emrah1982/KuluckaMakinesi/KuluckaSureleriVeDegerler.jpeg

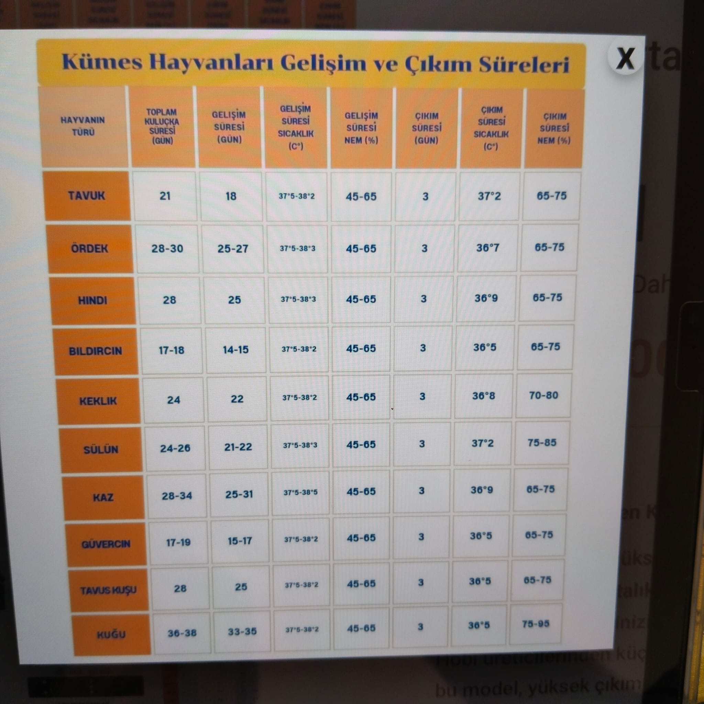
KuluckaSureleriVeDegerler.jpeg
