emrah1982/KuluckaMakinesi/KuluckaMakinesi_kicad/kullanilacakEkipmanlarinListesi.md

PCF8574 IO Genişleme Modülü
CJMCU-9548 TCA9548A I2C 8 Kanal Çoklayıcı Kartı Modülü
SHT40 Sensör Modül 1mt Kablolu
PAM8403 2x3w Amplifier Board
17HS4401 Nema 17 Step Motor
DS3231 Hassas RTC ve 24C32 EEPROM Modülü
DRV8825 Step Motor Sürücü Modül
Mini360 3A DC DC Voltaj Dönüştürücü Modülü (4.75-23V Giriş - 1-17V Çıkış)
