emrah1982/KuluckaMakinesi/docs/Hayvan.pdf

Hayvan | Evre | Gün Aralığı | Sıcaklık (°C) | Nem (%) | Not
Tavuk | Gelişim 1–18 | | 37.5 | 50-55 | Yumurtalar çevrilir
| Çıkım | 19–21 | 37.2 | 65-75 | Çevirme DURUR
Bıldırcın | Gelişim 1–14 | | 37.5 | 45-55 | Hızlı gelişim
| Çıkım | 15–18 | 37.2 | 65-75 | Kritik nem artışı
Kaz | Gelişim 1–25 | | 37.5 | 55-60 | Günlük soğutma + su püskürtme
| Çıkım | 26–30 | 37.2 | 75-80 | Yüksek nem şart
Ördek | Gelişim 1–25 | | 37.5 | 55-60 | Kaz ile benzer
| Çıkım | 26–28 | 37.2 | 70-80 | Nem artırılır
Hindi | Gelişim 1–25 | | 37.5 | 50-55 | Düzenli çevirme
| Çıkım | 26–28 | 37.2 | 65-75 | Nem artır
Güvercin | Gelişim 1–15 | | 37.5 | 50-55 | Hassas süreç
| Çıkım | 16–19 | 37.2 | 65-70 | Nem artar
Papağan | Gelişim | Türüne bağlı | 36.8-37.2 | 50-60 | Stabil ortam
| Çıkım | Son 2-3 gün | 36.5-37 | 65-75 | Tür bazlı değişir
Sülün | Gelişim 1–20 | | 37.5 | 50-55 | Tavuk benzeri
| Çıkım | 21–25 | 37.2 | 65-75 | Nem artır
Deve Kuşu | Gelişim 1–38 | | 36.0 | 25-35 | Çok düşük nem
| Çıkım | 39–42 | 36.0 | 40-50 | Yavaş çıkım
