emrah1982/KuluckaMakinesi/KuluckaMakinesi_kicad/resimler/3.2 inch ESP32 TFT Dokunmatik LCD Ekran.png

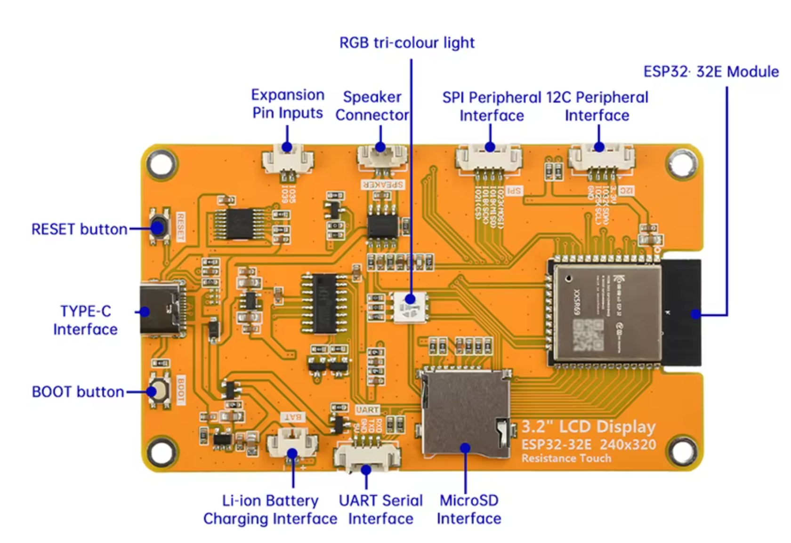
KuluckaMakinesi_kicad/resimler/3.2 inch ESP32 TFT Dokunmatik LCD Ekran.png
