emrah1982/KuluckaMakinesi/KuluckaMakinesi_kicad/resimler/DRV8825/Ekran görüntüsü 2026-05-17 150617.png

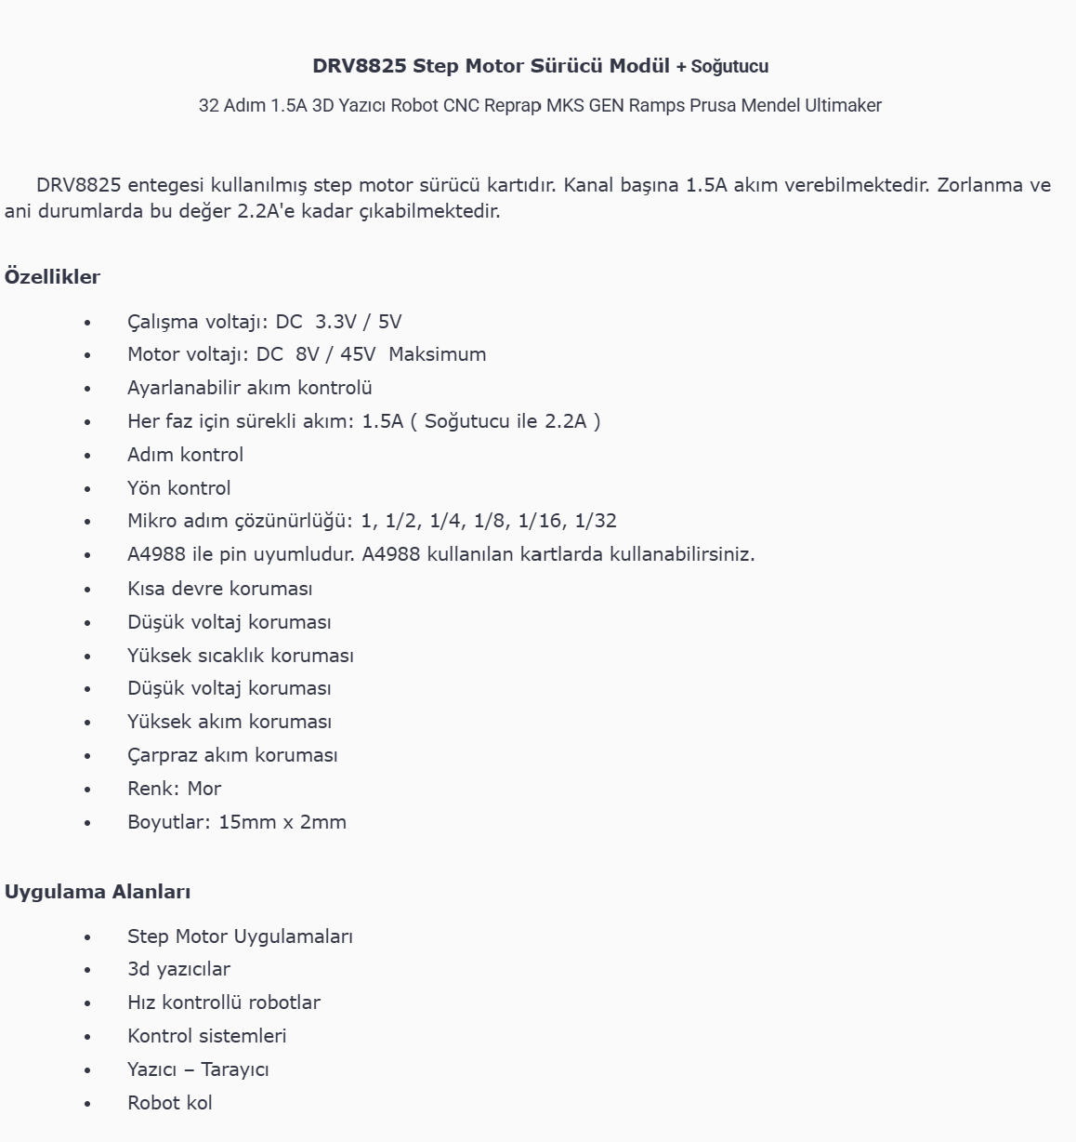
KuluckaMakinesi_kicad/resimler/DRV8825/Ekran görüntüsü 2026-05-17 150617.png
