emrah1982/KuluckaMakinesi/KuluckaMakinesi_kicad/resimler/DS3231/Ekran görüntüsü 2026-05-17 150417.png

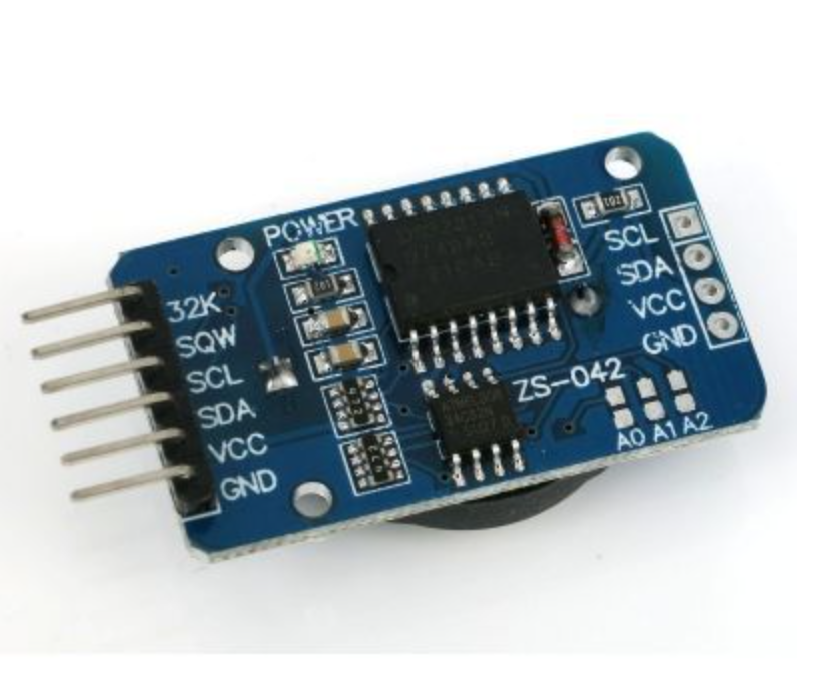
KuluckaMakinesi_kicad/resimler/DS3231/Ekran görüntüsü 2026-05-17 150417.png
