emrah1982/KuluckaMakinesi/KuluckaMakinesi_kicad/resimler/mini360/Ekran görüntüsü 2026-05-18 221324.png

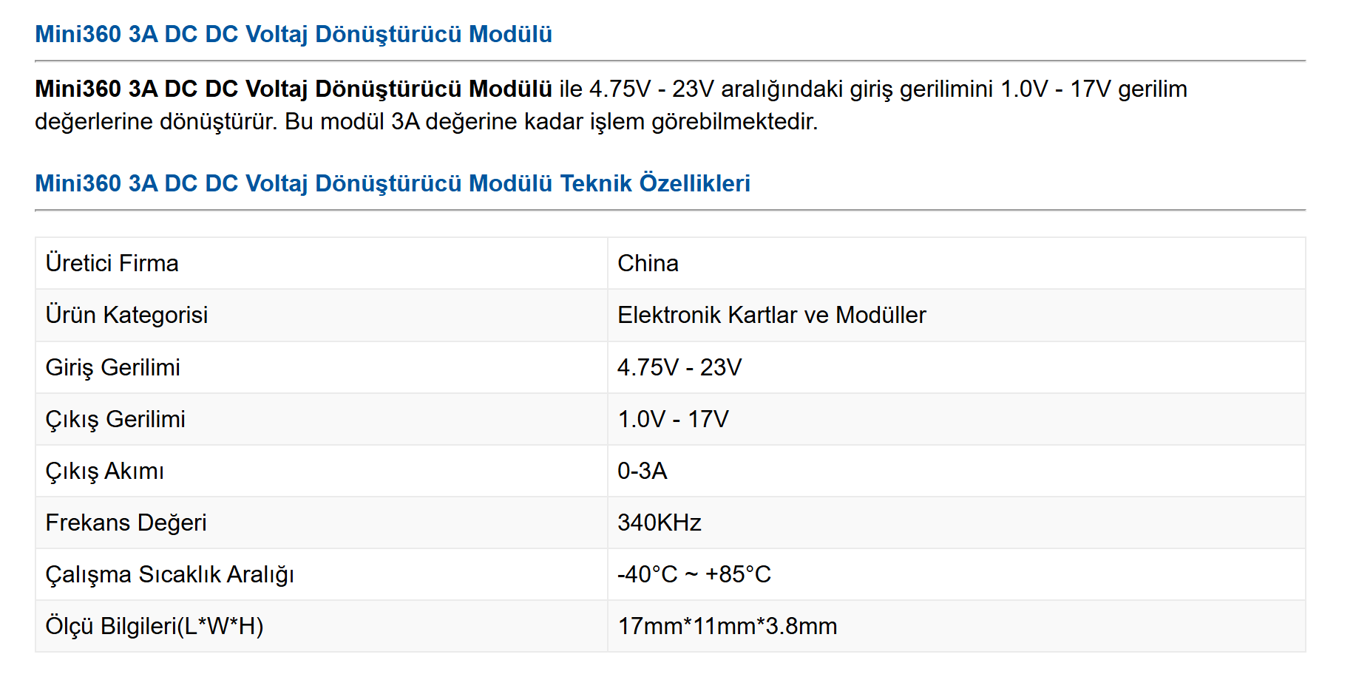
KuluckaMakinesi_kicad/resimler/mini360/Ekran görüntüsü 2026-05-18 221324.png
