emrah1982/KuluckaMakinesi/KuluckaMakinesi_kicad/resimler/PAM8403/Ekran görüntüsü 2026-05-17 150039.png

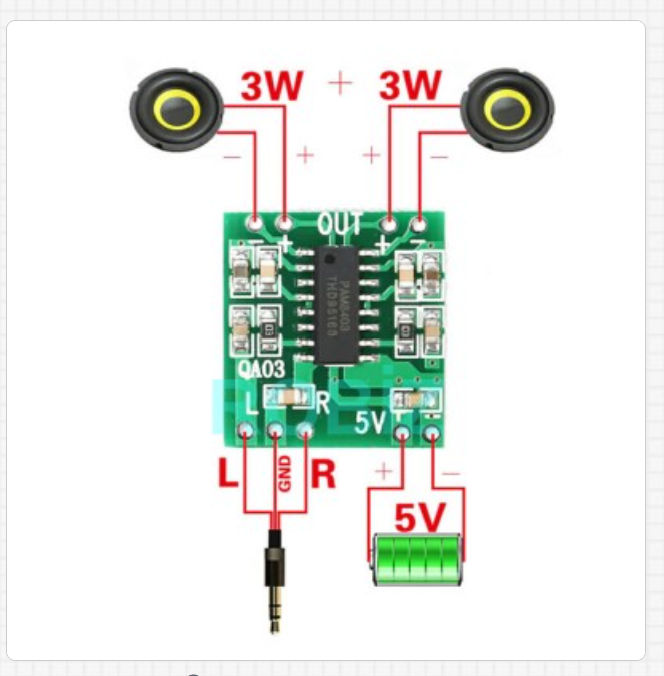
KuluckaMakinesi_kicad/resimler/PAM8403/Ekran görüntüsü 2026-05-17 150039.png
