emrah1982/KuluckaMakinesi/KuluckaMakinesi_kicad/resimler/pcf8574/Ekran görüntüsü 2026-05-17 144710.png

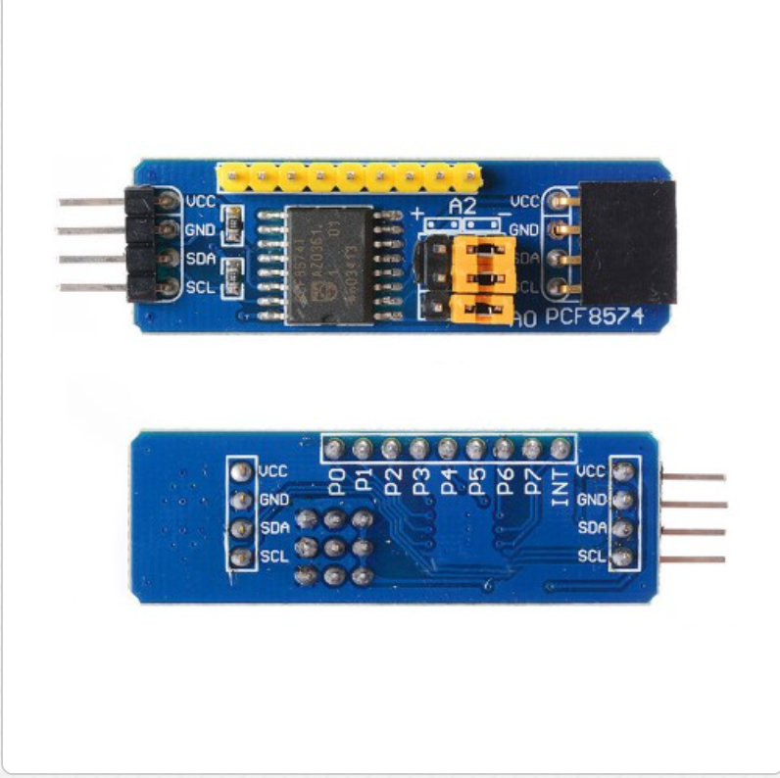
KuluckaMakinesi_kicad/resimler/pcf8574/Ekran görüntüsü 2026-05-17 144710.png
