emrah1982/KuluckaMakinesi/KuluckaMakinesi_kicad/resimler/SHT40 Sensör Modül/Ekran görüntüsü 2026-05-17 145020.png

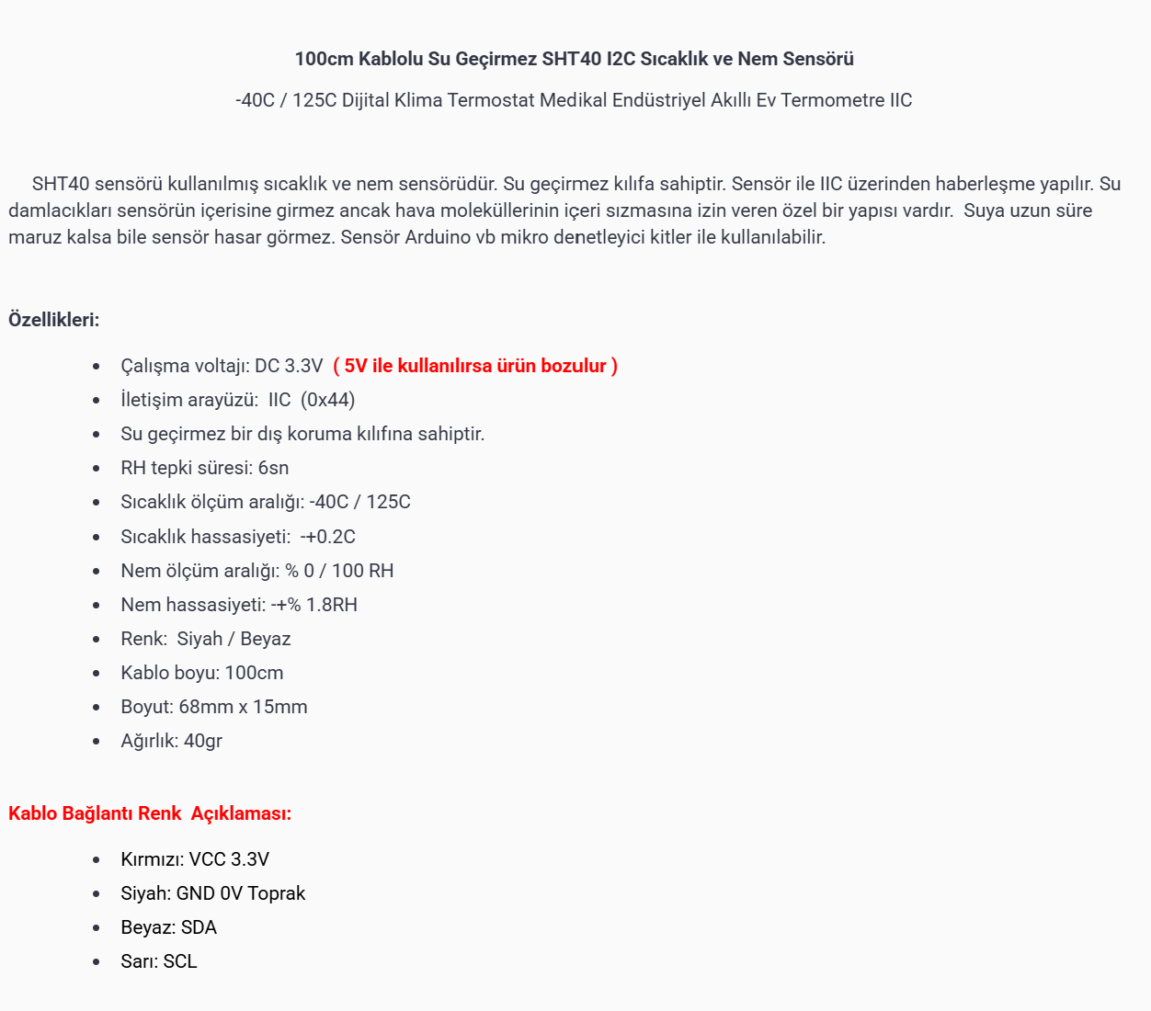
KuluckaMakinesi_kicad/resimler/SHT40 Sensör Modül/Ekran görüntüsü 2026-05-17 145020.png
