emrah1982/KuluckaMakinesi/KuluckaMakinesi_kicad/resimler/TCA9548A/Ekran görüntüsü 2026-05-17 144811.png

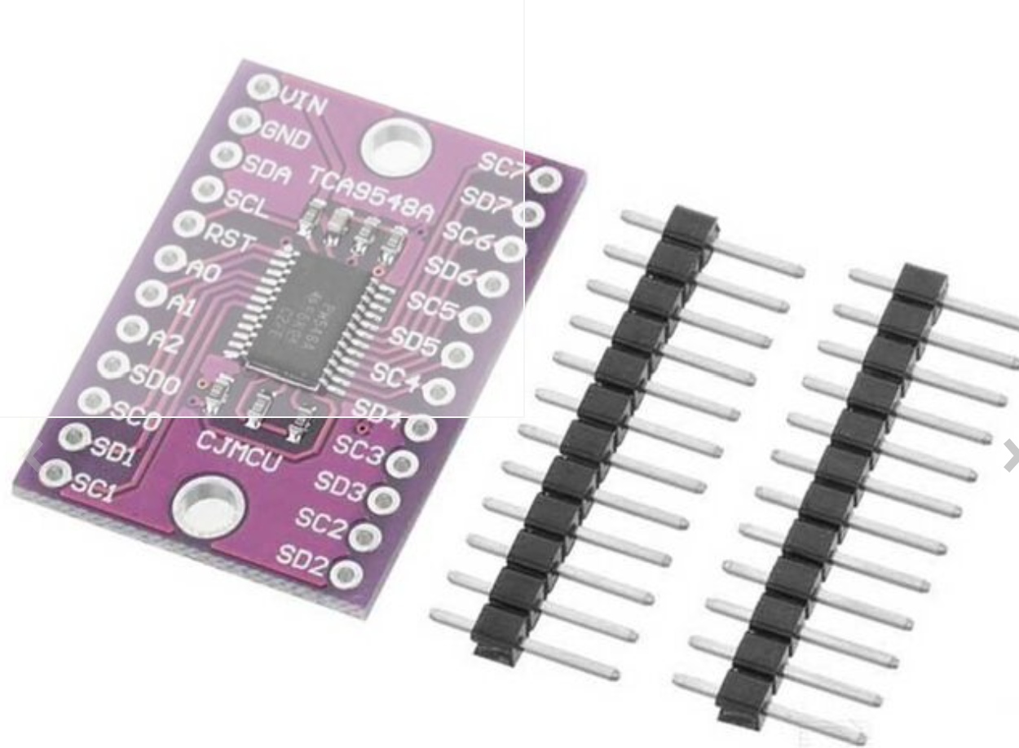
KuluckaMakinesi_kicad/resimler/TCA9548A/Ekran görüntüsü 2026-05-17 144811.png
