emrah1982/KuluckaMakinesi/KuluckaMakinesi_kicad/resimler/Step Motor/Ekran görüntüsü 2026-05-17 150236.png

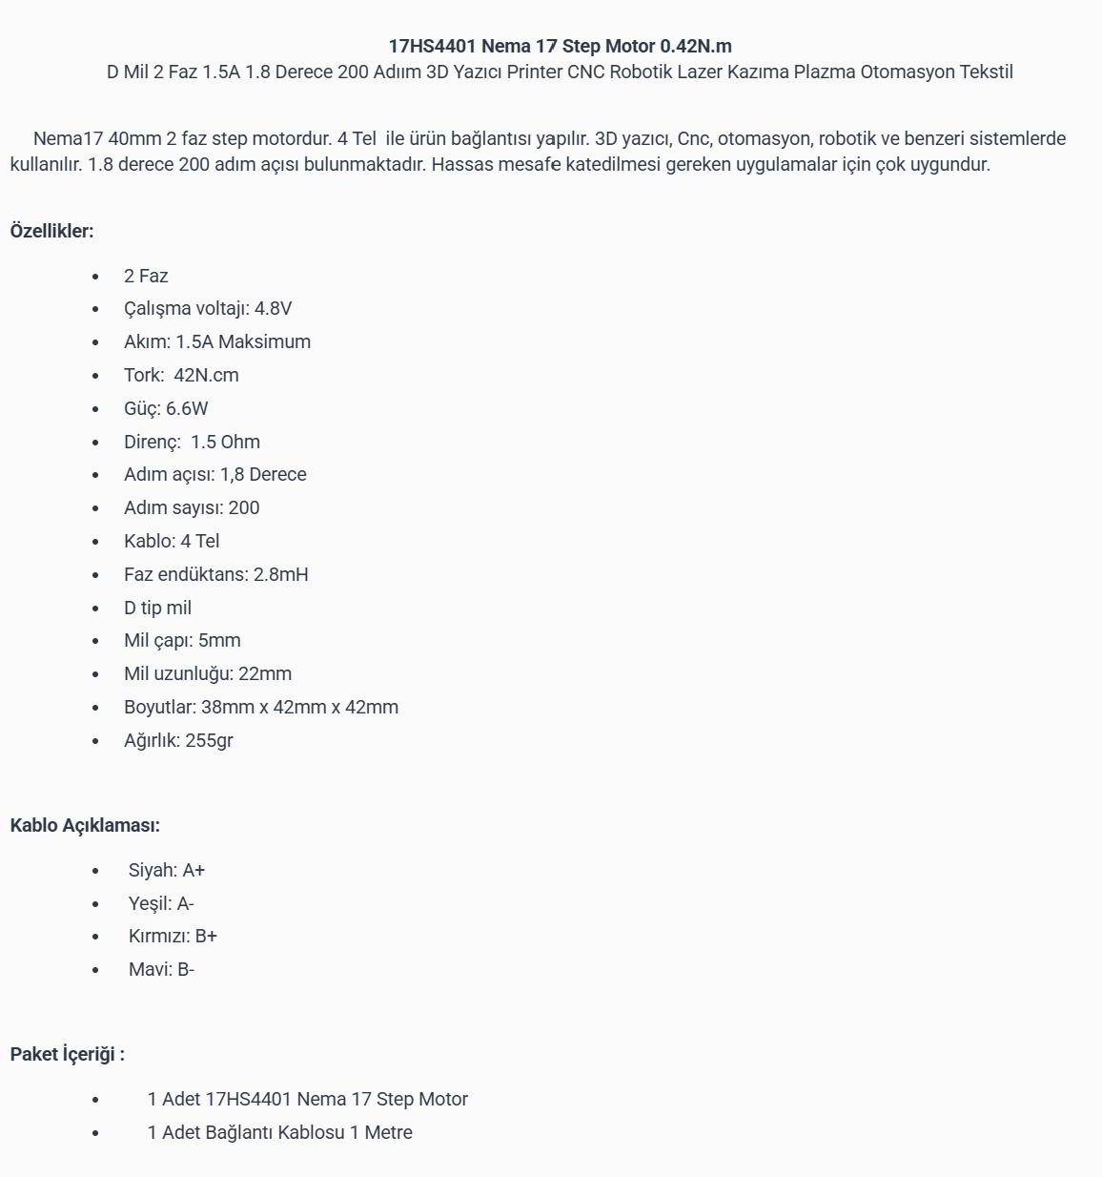
KuluckaMakinesi_kicad/resimler/Step Motor/Ekran görüntüsü 2026-05-17 150236.png
