emrah1982/KuluckaMakinesi/KuluckaMakinesi_kicad/KuluckaMakinesi.kicad_pcb

## KiCad design KuluckaMakinesi_kicad/KuluckaMakinesi.kicad_pcb (2026-08-02)

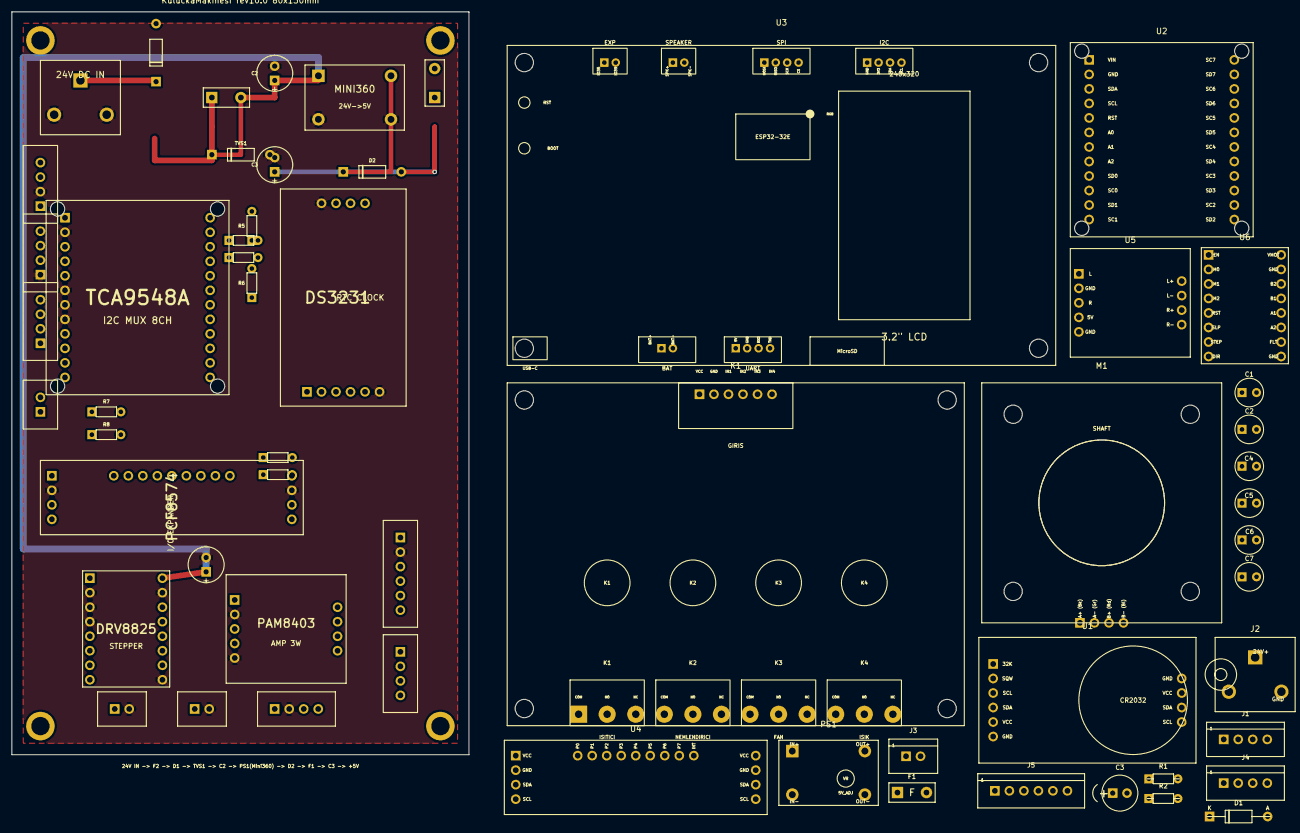
[picture p19: board KuluckaMakinesi.kicad_pcb from above]

Board: 2 copper layers, 80.0 x 130.0 mm, 61 parts (0 on the bottom side), 28 nets.

Parts:
C1: 100uF/25V; CP_Radial_D6.3mm_P2.5mm
C1#2, C2#2, C4, C5, C6, C7: 100nF; C_Disc_D5mm_P2.54mm
C2, C3#2: 100uF/35V; CP_Radial_D6.3mm_P2.5mm
C3: 100uF/16V; CP_Radial_D6.3mm_P2.5mm
D1, D1#2: SS34; D_Axial_DO41_P10.16mm
D2: SS14; D_Axial_DO41_P10.16mm
F1: 1A_PTC; F_Polyfuse_Radial_P5.08mm
F1#2, F2: 3A_PTC; F_Polyfuse_Radial_P5.08mm
H1, H2, H3, H4: M3; MountingHole_3.2mm_M3
J1: SHT40_SENSOR; JST_XH_4pin_2.54mm
J1#2: 24V_IN; DC_Jack_5.5x2.1
J2: DC_Jack_24V_5.5x2.1; DC_Jack_5.5x2.1
J2#2: BAT_2p; JST_XH_2pin_2.54mm
J3: 12V_VMOT; JST_XH_2pin_2.54mm
J3#2: UART_4p; JST_XH_4pin_2.54mm
J4: I2C_4p; JST_XH_4pin_2.54mm
J4#2: NEMA17_MOTOR; JST_XH_4pin_2.54mm
J5: ROLE_CTRL_6p; JST_XH_6pin_2.54mm
J5#2: EXP_2p; JST_XH_2pin_2.54mm
J6: SPI_4p; JST_XH_4pin_2.54mm
J7: SPK_2p; JST_XH_2pin_2.54mm
J8: NEMA17_4p; JST_XH_4pin_2.54mm
J9: RELAY_6p; JST_XH_6pin_2.54mm
J10: SHT40_4p; JST_XH_4pin_2.54mm
K1: RELAY_4CH; Relay4Channel_Module
M1: NEMA17; NEMA17_42x42_Mount
PS1: MINI360; Mini360_Buck
PS1#2: Mini360_24V_5V; Mini360_Buck
R1, R1#2, R2, R2#2, R3, R4, R5, R6, R7, R8: 4.7k; R_Axial_P5.08mm
TVS1: P6KE30A; D_Axial_DO41_P10.16mm
U1, U4: DS3231; DS3231_Module
U2, U2#2: TCA9548A; TCA9548A_Module
U3: ESP32_TFT; ESP32_TFT_3248S032
U4#2, U5#2: PCF8574; PCF8574_Module
U5, U7: PAM8403; PAM8403_Module
U6, U6#2: DRV8825; DRV8825_Module

Connections:
/+3V3: J4.2, J10.1, R1#2.1, R2.1, R3.1, R4.1, R5.1, R6.1, R7.1, R8.1, U2.1, U2.5, U4.5, U4.8, U5#2.1, U5#2.5, U6.5, U6.6
/+5V: C3.1, F1.2, J3#2.1, J9.1, U7.4
/+5V_BUCK: D2.1, PS1.3
/+5V_RAW: D2.2, F1.1
/+24V_FUSED: C1.1, C2.1, F2.2, PS1.1, TVS1.1, U6.9
/+24V_IN: D1.1, J1#2.1
/+24V_RAW: D1.2, F2.1
/AUDIO_IN: J7.1, U7.1, U7.3
/DIR: U5#2.15, U6.8
/GND: C1.2, C2.2, C3.2, J1#2.2, J2#2.2, J3#2.2, J4.1, J7.2, J9.2, J10.2, PS1.2, PS1.4, TVS1.2, U2.2, U2.6, U2.7, U2.8, U4.6, U4.7, U5#2.2, U5#2.6, U6.2, U6.3, U6.4, U6.10, U6.16, U7.2, U7.5
/I2C_SCL_CH0: J10.4, R4.2, U2.10
/I2C_SCL_CH1: R6.2, U2.12, U4.3, U4.10
/I2C_SCL_CH2: R8.2, U2.14, U5#2.4, U5#2.8
/I2C_SCL_MAIN: J4.4, R2.2, U2.4
/I2C_SDA_CH0: J10.3, R3.2, U2.9
/I2C_SDA_CH1: R5.2, U2.11, U4.4, U4.9
/I2C_SDA_CH2: R7.2, U2.13, U5#2.3, U5#2.7
/I2C_SDA_MAIN: J4.3, R1#2.2, U2.3
/MOT_A1: J8.1, U6.13
/MOT_A2: J8.2, U6.14
/MOT_B1: J8.3, U6.12
/MOT_B2: J8.4, U6.11
/MOT_EN: U5#2.13, U6.1
/RELAY_FAN: J9.5, U5#2.11
/RELAY_HEATER: J9.3, U5#2.9
/RELAY_HUMID: J9.4, U5#2.10
/RELAY_LIGHT: J9.6, U5#2.12
/STEP: J6.1, U6.7
