emrah1982/KuluckaMakinesi/KuluckaMakinesi_Esp32/KuluckaMakinesi/DisplayManager.cpp

#include "DisplayManager.h"
#include "AnimalIcons.h"
#include "CandlingScheduler.h"
#include <esp_task_wdt.h>
#include "WdtFeed.h"
#include "StorageService.h"
#include <math.h>

// Derece -> Radyan donusumu
#define DEG2RAD 0.0174532925f

// ==================== RENK PALETI (Web arayuz eslesimi) ====================
static const uint16_t COL_BG     = 0x0000;  // Siyah arkaplan
static const uint16_t COL_CARD   = 0x1947;  // #1E293B - Kart
static const uint16_t COL_TEXT   = 0xFFFF;  // Beyaz
static const uint16_t COL_DIM    = 0x9517;  // #94A3B8 - Soluk
static const uint16_t COL_RED    = 0xD924;  // #DC2626
static const uint16_t COL_BLUE   = 0x231D;  // #2563EB
static const uint16_t COL_GREEN  = 0x1509;  // #16A34A
static const uint16_t COL_ORANGE = 0xDBA0;  // #D97706
static const uint16_t COL_CYAN   = 0x05BA;  // #06B6D4
static const uint16_t COL_PURPLE = 0x79DD;  // #7C3AED
static const uint16_t COL_BAR_BG = 0x2104;  // #202020
static const uint16_t COL_YELLOW = 0xFE60;  // #FFD700

// Durum isimleri ve renkleri (index = SystemState enum)
// 0=INIT 1=AUTOTUNE 2=RUNNING 3=PAUSED 4=COMPLETED 5=EMERGENCY 6=CLEANING
static const char* ST_BADGE[]  = {"BASLA", "TUNE", "CALISIYOR", "DURAKLAT", "TAMAM", "ACIL!", "TEMIZLIK"};
static const char* ST_SHORT[]  = {"Basla", "Tune", "Calisiyor", "Duraklat", "Tamam", "ACIL!", "Temizlik"};
static const uint16_t ST_CLR[] = {COL_DIM, COL_PURPLE, COL_GREEN, COL_ORANGE, COL_BLUE, COL_RED, COL_CYAN};

// Sekme isimleri (5 sekme: Durum, Olcum, Kontrol, Profil, Ayar)
static const char* TAB_LABEL[] = {"Durum", "Olcum", "Kontrol", "Profil", "Ayar"};

// Profilleri alfabetik siralayan index haritasi (gercek index degismez!)
// _profileSortMap[i] = ALL_PROFILES dizisindeki gercek index
static uint8_t _profileSortMap[PROFILE_COUNT];
static bool _profileSortReady = false;

static void buildProfileSortMap() {
    for (uint8_t i = 0; i < PROFILE_COUNT; i++) _profileSortMap[i] = i;
    // Insertion sort: alfabetik (case-insensitive)
    for (uint8_t i = 1; i < PROFILE_COUNT; i++) {
        uint8_t key = _profileSortMap[i];
        int8_t j = i - 1;
        while (j >= 0 && strcmp(ALL_PROFILES[_profileSortMap[j]]->name,
                                ALL_PROFILES[key]->name) > 0) {
            _profileSortMap[j + 1] = _profileSortMap[j];
            j--;
        }
        _profileSortMap[j + 1] = key;
    }
    _profileSortReady = true;
}

static inline uint8_t profileRealIdx(uint8_t sortedPos) {
    if (!_profileSortReady) buildProfileSortMap();
    return _profileSortMap[sortedPos];
}

// Layout sabitleri (240x320 portrait, tab bar altta)
static const int SCR_W = 240;
static const int SCR_H = 320;
static const int TAB_H = 30;           // Alt tab bar yuksekligi
static const int PAGE_H = SCR_H - TAB_H; // Icerik alani: 0-289

// Dashboard layout
static const int HDR_Y = 0,   HDR_H = 28;
static const int GAU_Y = 30,  GAU_H = 56;
static const int INF_Y = 88,  INF_H = 46;
static const int OUT_Y = 136, OUT_H = 62;
static const int SNS_Y = 200, SNS_H = 24;
static const int ALM_Y = 226, ALM_H = 38;
// Durum seridi: alarm kartinin altinda kalan bos alan (264..290 arasi
// kullanilmiyordu). CO2, yumurta IR kaynagi ve I/O sagligi burada.
static const int STA_Y = 266, STA_H = 22;

// Profil sekmesi kaydirma bolgeleri. Ekranda gorunen kontrollerle AYNI yerde
// olmalari sart: yukari = baslik karti, asagi = alttaki "ASAGI" seridi.
static const int PROF_SCROLL_UP_MAXY = 66;    // baslik karti 2..64
static const int PROF_SCROLL_DN_MINY = 266;   // alt serit 266..286

// ---- Sistem kontrol onay modali ----
// Yazilar buyutuldugu icin modal da buyutuldu. Yatay tasma sinirlari
// (Font1 ~6 px/karakter, Font2 ~8 px, Font4 ~14 px, ic genislik 212 px):
//   baslik  "SISTEM KONTROL" Font2 = 112 px  OK
//   durum   "Calisiyor"      Font4 = 126 px  OK
//   uyari   en uzun satir    Font2 = 176 px  OK   (26 karakteri asmamali)
//   buton   "GUVENLIK SIFIRLA" Font2 = 128 px, tek buton genisligi 212  OK
//   buton   "DURAKLAT"       Font2 =  64 px, ikili buton genisligi 104  OK
static const int SYSM_X = 10, SYSM_Y = 30;
static const int SYSM_W = SCR_W - 20;              // 220 (ic genislik 212)
static const int SYSM_H = 240;                     // 30..270 (sayfa siniri 290)
static const int SYSM_BTN_H = 44;                  // dokunma hedefi buyutuldu
static const int SYSM_ACT_Y = SYSM_Y + 92;         // eylem butonlari 122..166
static const int SYSM_CANCEL_Y = SYSM_Y + 182;     // vazgec 212..256
static const int SYSM_BTN_W2 = (SYSM_W - 12) / 2;  // yan yana iki buton: 104
// Kazara acilan modal panoyu suresiz kapatmasin
static const unsigned long SYSM_TIMEOUT_MS = 15000;

// Sistem durumuna gore sunulan eylemler.
// Cizim ve dokunma AYNI kaynagi kullanir; ikisi ayrisirsa kullanici
// bastigi butondan baska bir eylemi tetikler - guvenlik acisindan kabul
// edilemez.
struct SysAction {
    const char* label;
    TouchAction act;
    uint16_t    color;
};

static uint8_t sysActionsFor(int state, SysAction out[2]) {
    switch (state) {
        case 2:  // SYS_RUNNING
            out[0] = {"DURAKLAT", TOUCH_PAUSE, COL_ORANGE};
            out[1] = {"DURDUR",   TOUCH_STOP,  COL_RED};
            return 2;
        case 3:  // SYS_PAUSED
            out[0] = {"DEVAM",  TOUCH_RESUME, COL_GREEN};
            out[1] = {"DURDUR", TOUCH_STOP,   COL_RED};
            return 2;
        case 1:  // SYS_AUTOTUNING
            out[0] = {"DURDUR", TOUCH_STOP, COL_RED};
            return 1;
        case 5:  // SYS_EMERGENCY
            out[0] = {"GUVENLIK SIFIRLA", TOUCH_SAFETY_RESET, COL_CYAN};
            return 1;
        case 6:  // SYS_CLEANING
            out[0] = {"TEMIZLIGI BITIR", TOUCH_STOP, COL_ORANGE};
            return 1;
        default: // SYS_INITIALIZING / SYS_COMPLETED
            out[0] = {"BASLAT", TOUCH_START, COL_GREEN};
            return 1;
    }
}

// Kontrol sayfasi buton konumlari
static const int BTN_W  = 112;
static const int BTN_H  = 44;
static const int BTN_Y1 = 38;
static const int BTN_Y2 = 88;

// ==================== CONSTRUCTOR & BEGIN ====================

DisplayManager::DisplayManager()
    : _tft()
    , _lastUpdate(0)
    , _lastTouch(0)
    , _tab(TAB_DASH)
    , _forceRedraw(true)
    , _bgDraw(true)
    , _scrollOffset(0)
    , _profMaxScroll(0)
    , _sysCtrlOpen(false)
    , _sysCtrlDrawn(false)
    , _sysCtrlOpenedMs(0)
#if RELAY_TEST_ENABLED
    , _relayTestDrawn(false)
    , _relayTestSig(0xFF)
    , _relayTestHeaterLeft(0xFFFF)
#endif
    , _profileListOpen(false)
    , _pendingProfileIdx(0)
    , _prevTemp(-999)
    , _prevHum(-999)
    , _prevCO2(0)
    , _prevTempMin(-999)
    , _prevTempMax(-999)
    , _prevHumMin(-999)
    , _prevHumMax(-999)
    , _prevTempColor(0)
    , _prevHumColor(0)
    , _prevCO2Color(0)
    , _loadingTaskHandle(nullptr)
    , _loadingActive(false)
{
}

void DisplayManager::begin() {
#if (TFT_BL >= 0)
    pinMode(TFT_BL, OUTPUT);
    digitalWrite(TFT_BL, HIGH);
#endif

    _tft.init();
    _tft.setRotation(0);  // Portrait: 240x320
    _tft.fillScreen(COL_BG);

    // Dokunmatik kalibrasyon
    // 5. parametre: bit0=swap_XY, bit1=invert_X, bit2=invert_Y
    // ESP32-3248S032 icin 7 (swap+invertX+invertY) genelde dogru
    uint16_t calData[5] = {
        TOUCH_CAL_X_MIN, TOUCH_CAL_X_MAX,
        TOUCH_CAL_Y_MIN, TOUCH_CAL_Y_MAX, 7
    };
    _tft.setTouch(calData);

    // ========== SECGEM SPLASH ANIMASYONU ==========
    showSplashAnimation();

    _lastUpdate = 0;
    _lastTouch  = 0;
    _tab = TAB_DASH;
    _forceRedraw = true;
    _bgDraw = true;  // Tab bar ve arka plan cizimi icin

    DEBUG_PRINTLN("[TOUCH] OK");
}

// ==================== DOKUNMATIK ====================

bool DisplayManager::getTouchXY(uint16_t &x, uint16_t &y) {
    // Ham Z basinci oku
    uint16_t z = _tft.getTouchRawZ();
    if (z < 300) return false;

    // Ham koordinatlari oku
    uint16_t rawX, rawY;
    _tft.getTouchRaw(&rawX, &rawY);

    // ESP32-3248S032 rotation=0: swap YOK, invertX + invertY
    int sx = map((long)rawX, TOUCH_CAL_X_MIN, TOUCH_CAL_X_MAX, SCR_W - 1, 0);
    int sy = map((long)rawY, TOUCH_CAL_Y_MIN, TOUCH_CAL_Y_MAX, SCR_H - 1, 0);
    x = constrain(sx, 0, SCR_W - 1);
    y = constrain(sy, 0, SCR_H - 1);
    return true;
}

bool DisplayManager::touchInRect(uint16_t tx, uint16_t ty,
                                  int rx, int ry, int rw, int rh) {
    return (tx >= rx && tx < rx + rw && ty >= ry && ty < ry + rh);
}

TouchAction DisplayManager::handleTouch(const DisplayData &data) {
    uint16_t tx, ty;
    if (!getTouchXY(tx, ty)) return TOUCH_NONE;

    unsigned long now = millis();
    if (now - _lastTouch < TOUCH_DEBOUNCE_MS) return TOUCH_NONE;
    _lastTouch = now;

#if RELAY_TEST_ENABLED
    // --- ROLE TESTI ACIKSA: EN ONCE, her seyden once ---
    // Modal dokunmasi TUM sekme isleyicilerinden once gelmelidir. Bu blok
    // once TAB_CTRL isleyicisinin ardinda duruyordu ve calismiyordu:
    // "TESTI BITIR" (y 208..248) ile Kontrol sekmesindeki
    // "Profil Sec / Profili Duzenle" satiri (y 218..246) cakisiyor,
    // dokunus once oraya gidip profil listesini aciyordu.
    // Koordinatlar drawRelayTest ile BIREBIR ayni.
    if (data.relayTestActive) {
        const int mx = 6, my = 24, mw = SCR_W - 12;
        const int bx = mx + 4, bw2 = (mw - 12) / 2;
        const int rx2 = bx + bw2 + 4;
        const int bh = 38;
        const int r1y = my + 42;
        const int r2y = r1y + bh + 4;
        const int fy  = r2y + bh + 4;

        if (touchInRect(tx, ty, bx,  r1y, bw2, bh)) return TOUCH_RTEST_R0;
        if (touchInRect(tx, ty, rx2, r1y, bw2, bh)) return TOUCH_RTEST_R1;
        if (touchInRect(tx, ty, bx,  r2y, bw2, bh)) return TOUCH_RTEST_R2;
        if (touchInRect(tx, ty, rx2, r2y, bw2, bh)) return TOUCH_RTEST_R3;
        if (touchInRect(tx, ty, bx,  fy,  mw - 8, bh)) return TOUCH_RTEST_FAN;
        if (touchInRect(tx, ty, bx,  fy + bh + 20, mw - 8, 40)) {
            _forceRedraw = true;
            return TOUCH_RTEST_EXIT;
        }
        return TOUCH_NONE;   // modal disi dokunuslar yutulur
    }
#endif

    // --- ALARM MODAL aciksa ---
    // Tum alarmlarda 3 buton: SUSTUR (10dk), ERTELE (1sa), KAPAT
    // CANDLING'de SUSTUR butonu yerine direkt ERTELE/KAPAT (kullanici karari net olsun)
    if (_alarmModalOpen) {
        bool isCandling = (data.alarmType == ALARM_CANDLING_DUE);
        const int btnX = 20;
        const int btnW = SCR_W - 40;
        const int btnH = 38;
        const int btnGap = 6;
        // 3 buton: SUSTUR / ERTELE / KAPAT (alt alta)
        const int totalH = (isCandling ? 2 : 3) * btnH + (isCandling ? 1 : 2) * btnGap;
        const int firstY = SCR_H - totalH - 14;

        if (isCandling) {
            // CANDLING: ERTELE + KAPAT (2 buton)
            int snoozeY  = firstY;
            int dismissY = firstY + btnH + btnGap;
            if (touchInRect(tx, ty, btnX, snoozeY, btnW, btnH)) {
                _alarmModalOpen = false;
                _alarmModalDrawn = false;
                _forceRedraw = true;
                return TOUCH_ALARM_SNOOZE;
            }
            if (touchInRect(tx, ty, btnX, dismissY, btnW, btnH)) {
                _alarmModalOpen = false;
                _alarmModalDrawn = false;
                _forceRedraw = true;
                return TOUCH_ALARM_DISMISS;
            }
        } else {
            // STANDART: SUSTUR + ERTELE + KAPAT (3 buton)
            int ackY     = firstY;
            int snoozeY  = firstY + btnH + btnGap;
            int dismissY = firstY + 2 * (btnH + btnGap);
            if (touchInRect(tx, ty, btnX, ackY, btnW, btnH)) {
                _alarmModalOpen = false;
                _alarmModalDrawn = false;
                _forceRedraw = true;
                return TOUCH_ALARM_ACK;
            }
            if (touchInRect(tx, ty, btnX, snoozeY, btnW, btnH)) {
                _alarmModalOpen = false;
                _alarmModalDrawn = false;
                _forceRedraw = true;
                return TOUCH_ALARM_SNOOZE;
            }
            if (touchInRect(tx, ty, btnX, dismissY, btnW, btnH)) {
                _alarmModalOpen = false;
                _alarmModalDrawn = false;
                _forceRedraw = true;
                return TOUCH_ALARM_DISMISS;
            }
        }
        // Modal disindaki dokunmalar yutulur — kullanici acikca buton tikladi
        return TOUCH_NONE;
    }

    // --- Profil dropdown aciksa TUM ekrani ele al (tab bar dahil) ---
    if (_tab == TAB_CTRL && _profileListOpen) {
        const int itemH  = 36;       // Daha buyuk dokunma alani
        const int hdrH   = 40;       // Ust baslik + yukari ok
        const int ftrH   = 40;       // Alt asagi ok
        const int listY  = hdrH;     // Liste baslangici
        int maxVisible = (SCR_H - hdrH - ftrH) / itemH;  // (320-40-40)/36 = 6
        if (maxVisible > PROFILE_COUNT) maxVisible = PROFILE_COUNT;
        int maxScroll = PROFILE_COUNT - maxVisible;
        if (maxScroll < 0) maxScroll = 0;
        if (_scrollOffset > maxScroll) _scrollOffset = maxScroll;

        int listEndY = listY + maxVisible * itemH;

        // Yukari ok butonuna dokunma (baslik alani, y < hdrH)
        if (ty < hdrH) {
            if (_scrollOffset > 0) {
                _scrollOffset--;
                _forceRedraw = true;
            }
            return TOUCH_NONE;
        }

        // Asagi ok butonuna dokunma (alt alan, y >= listEndY)
        if (ty >= listEndY) {
            if (_scrollOffset < maxScroll) {
                _scrollOffset++;
                _forceRedraw = true;
            }
            return TOUCH_NONE;
        }

        // Liste icerisindeki profillere dokunma
        int idx = (ty - listY) / itemH;
        idx = constrain(idx, 0, maxVisible - 1);
        int sortedIdx = idx + _scrollOffset;
        int realIdx = -1;
        if (sortedIdx >= 0 && sortedIdx < PROFILE_COUNT) {
            realIdx = profileRealIdx(sortedIdx);  // Alfabetik -> gercek index
            _pendingProfileIdx = (uint8_t)realIdx;
            _profileListOpen = false;
            _scrollOffset = 0;
            _forceRedraw = true;
            return TOUCH_PROFILE_SELECT;
        }

        // Baska bir yere dokunma -> kapat
        _profileListOpen = false;
        _scrollOffset = 0;
        _forceRedraw = true;
        return TOUCH_NONE;
    }

    // --- Tab bar dokunma (Y >= PAGE_H) ---
    if (ty >= PAGE_H) {
        int tabW = SCR_W / TAB_COUNT;
        int tabIdx = tx / tabW;
        if (tabIdx >= 0 && tabIdx < TAB_COUNT) {
            DisplayTab newTab = (DisplayTab)tabIdx;
            if (newTab != _tab) {
                _tab = newTab;
                _scrollOffset = 0;  // Tab degisince scroll sifirla
                _profileListOpen = false;
                _forceRedraw = true;
            }
        }
        return TOUCH_NONE;
    }

    // --- Profil EDITOR aciksa: tum ekran ona ait ---
    if (_tab == TAB_CTRL && _profileEditorOpen) {
        const int hdrH    = 32;
        const int rowH    = 42;
        const int rowGap  = 3;
        const int rowsY   = hdrH + 3;
        const int padX    = 8;
        const int btnW    = 50;
        const int btnH    = rowH - 8;
        const int rowCount = 4;   // Sicaklik, Nem Alt, Nem Ust, Cev Aralik

        // Satir bazli ±butonlar
        // NOT: forceRedraw set ETMIYORUZ — sadece deger metni guncellenir,
        // arkaplan/butonlar olduklari yerde kalir (flicker olmaz).
        for (int i = 0; i < rowCount; i++) {
            int y = rowsY + i * (rowH + rowGap);
            int btnY = y + rowH - btnH - 4;
            int minusX = padX + 8;
            int plusX  = SCR_W - padX - 8 - btnW;
            if (touchInRect(tx, ty, minusX, btnY, btnW, btnH)) {
                if (i == 0) return TOUCH_EDIT_TEMP_DEC;
                if (i == 1) return TOUCH_EDIT_HUMLOW_DEC;
                if (i == 2) return TOUCH_EDIT_HUMHIGH_DEC;
                if (i == 3) return TOUCH_EDIT_TURNINT_DEC;
            }
            if (touchInRect(tx, ty, plusX, btnY, btnW, btnH)) {
                if (i == 0) return TOUCH_EDIT_TEMP_INC;
                if (i == 1) return TOUCH_EDIT_HUMLOW_INC;
                if (i == 2) return TOUCH_EDIT_HUMHIGH_INC;
                if (i == 3) return TOUCH_EDIT_TURNINT_INC;
            }
        }

        // Alt: Fabrika + Kapat
        int botY = rowsY + rowCount * (rowH + rowGap) + 4;
        int botBtnH = 32;
        int botBtnW = (SCR_W - padX * 3) / 2;
        int closeX  = SCR_W - padX - botBtnW;

        if (touchInRect(tx, ty, padX, botY, botBtnW, botBtnH)) {
            // Fabrika butonunun rengi degisecek (override silindi -> gri),
            // bu yuzden BG yeniden cizilmeli.
            _forceRedraw = true;
            return TOUCH_EDIT_RESET_FACTORY;
        }
        if (touchInRect(tx, ty, closeX, botY, botBtnW, botBtnH)) {
            _profileEditorOpen = false;
            _forceRedraw = true;
            return TOUCH_NONE;
        }
        // Editor aciksa baska bolgeye dokunmayi yutuyoruz
        return TOUCH_NONE;
    }

    // --- Kontrol sayfasi butonlari (yeni tasarim) ---
    if (_tab == TAB_CTRL) {
        const int cardMargin = 4;
        const int cardW = SCR_W - cardMargin * 2;
        const int btnGap = 4;
        const int btnStartY = 34;
        const int btnH2 = 38;
        const int btnW2 = (cardW - btnGap) / 2;
        int lx = cardMargin;
        int rx = cardMargin + btnW2 + btnGap;

        // 2x2 buton grid
        if (touchInRect(tx, ty, lx, btnStartY, btnW2, btnH2)) return TOUCH_START;
        if (touchInRect(tx, ty, rx, btnStartY, btnW2, btnH2)) return TOUCH_PAUSE;
        if (touchInRect(tx, ty, lx, btnStartY + btnH2 + btnGap, btnW2, btnH2)) return TOUCH_RESUME;
        if (touchInRect(tx, ty, rx, btnStartY + btnH2 + btnGap, btnW2, btnH2)) return TOUCH_STOP;

        // Alt satir: Profil Sec (SOL) + Profili Duzenle (SAG)
        const int pidH = 44;
        const int nemH = 44;
        const int py = 122;
        const int ny = py + pidH + 4;
        const int cy = ny + nemH + 4;  // 218

        // Manuel cikis toggle'lari (NEM ESIKLERI kartinin yerine gecti).
        // Koordinatlar drawControl'daki cizimle BIREBIR ayni olmali; aksi
        // halde kullanici bastigi butondan baskasini tetikler.
#if RELAY_TEST_ENABLED
        // Tek giris: role/cikis testi (cizimle ayni koordinatlar)
        {
            const int mBtnY = ny + 17;
            const int mBtnH = 22;
            if (touchInRect(tx, ty, cardMargin, mBtnY, cardW, mBtnH)) {
                _forceRedraw = true;
                return TOUCH_RTEST_ENTER;
            }
        }
#endif
        const int bottomH = 28;
        const int halfW = (cardW - 4) / 2;
        int px = cardMargin + halfW + 4;  // sag yari baslangici

        // Profil Sec — SOL
        if (touchInRect(tx, ty, cardMargin, cy, halfW, bottomH)) {
            _profileListOpen = true;
            _scrollOffset = 0;
            _forceRedraw = true;
            return TOUCH_NONE;
        }
        // Profili Duzenle — SAG (editoru ac)
        if (touchInRect(tx, ty, px, cy, halfW, bottomH)) {
            _profileEditorOpen = true;
            _forceRedraw = true;
            return TOUCH_NONE;
        }

        // En alt satir — sag yarida TEMIZLIK butonu
        const int ty2 = cy + bottomH + 4;
        const int turnH = 28;
        int clnX = cardMargin + halfW + 4;
        if (touchInRect(tx, ty, clnX, ty2, halfW, turnH)) {
            _forceRedraw = true;
            return TOUCH_CLEANING_TOGGLE;
        }
    }

    // --- Sistem kontrol modali acikken baska hicbir sey dinlenmez ---
    // Modal bir ONAY penceresidir; arka plandaki kontrollerin de tetiklenmesi
    // kullanicinin onaylamadigi bir eylemi calistirabilirdi.
    if (_sysCtrlOpen) {
        SysAction acts[2];
        uint8_t n = sysActionsFor(constrain(data.systemState, 0, 6), acts);

        // Vazgec
        if (touchInRect(tx, ty, SYSM_X + 4, SYSM_CANCEL_Y, SYSM_W - 8, SYSM_BTN_H)) {
            _sysCtrlOpen = false;
            _forceRedraw = true;
            return TOUCH_NONE;
        }
        // Eylem butonlari - cizimle AYNI koordinatlar ve AYNI eylem kaynagi
        if (n == 1) {
            if (touchInRect(tx, ty, SYSM_X + 4, SYSM_ACT_Y, SYSM_W - 8, SYSM_BTN_H)) {
                _sysCtrlOpen = false;
                _forceRedraw = true;
                return acts[0].act;
            }
        } else {
            if (touchInRect(tx, ty, SYSM_X + 4, SYSM_ACT_Y, SYSM_BTN_W2, SYSM_BTN_H)) {
                _sysCtrlOpen = false;
                _forceRedraw = true;
                return acts[0].act;
            }
            if (touchInRect(tx, ty, SYSM_X + 8 + SYSM_BTN_W2, SYSM_ACT_Y,
                            SYSM_BTN_W2, SYSM_BTN_H)) {
                _sysCtrlOpen = false;
                _forceRedraw = true;
                return acts[1].act;
            }
        }
        // Modal disina dokunma -> kapat (guvenli taraf)
        _sysCtrlOpen = false;
        _forceRedraw = true;
        return TOUCH_NONE;
    }

    // --- Durum sekmesi: DURUM kartina dokunma -> sistem kontrol modali ---
    // Dogrudan eylem YOK. Kart yalnizca onay penceresini acar.
    if (_tab == TAB_DASH) {
        const int bw = 56;
        const int gap = (SCR_W - 4 * bw - 4) / 3;
        const int x3 = 2 + 2 * (bw + gap);      // DURUM karti
        if (touchInRect(tx, ty, x3, INF_Y, bw, INF_H)) {
            _sysCtrlOpen     = true;
            _sysCtrlDrawn    = false;   // bir kez cizilsin
            _sysCtrlOpenedMs = millis();
            _forceRedraw     = true;
            return TOUCH_NONE;
        }
    }

    // --- Profil sayfasi: scroll ---
    // Dokunma bolgeleri artik EKRANDA GORUNEN kontrollerle ayni yerde:
    //   yukari -> baslik karti (y 2..64), icinde "^ 1/2" gostergesi var
    //   asagi  -> en alttaki "v ASAGI v" seridi (y 266..286)
    // Eskiden bolgeler y 38..80 ve y>220 idi; hicbir gorsel karsiligi yoktu,
    // kullanici kaydirmanin mumkun oldugunu bile goremiyordu.
    if (_tab == TAB_PROF) {
        if (ty < PROF_SCROLL_UP_MAXY) {
            if (_scrollOffset > 0) {
                _scrollOffset--;
                _forceRedraw = true;
            }
            return TOUCH_NONE;
        }
        if (ty >= PROF_SCROLL_DN_MINY) {
            // Sinir kontrolu: eskiden kosulsuz artiriliyordu. Cizim sirasinda
            // kirpiliyordu ama bu, "sonu gectin" geri bildirimi vermiyordu.
            if (_scrollOffset < _profMaxScroll) {
                _scrollOffset++;
                _forceRedraw = true;
            }
            return TOUCH_NONE;
        }
    }

    // --- Ayar sayfasi scroll ---
    if (_tab == TAB_SET) {
        if (ty < 60) {
            if (_scrollOffset > 0) {
                _scrollOffset--;
                _forceRedraw = true;
            }
            return TOUCH_NONE;
        }
        // YENI TASARIM (Tarih kart 28 + AG 58 + SENSOR 28 + SISTEM 58 + PROFIL 46 + IR 36)
        // Yumurta sayisi -/+ butonlari (Kart 4 PROFIL icinde, kompakt)
        // PROFIL cy = 2+28+4+58+4+28+4+58+4 = 190, btnY = cy+22 = 212
        const int btnY = 212;
        const int btnW = 28;
        const int btnH = 20;
        const int leftBtnX  = 4 + 8 + 6;             // cardPadX + cardMargin + 6 = 18
        const int rightBtnX = leftBtnX + btnW + 42;  // 88
        if (touchInRect(tx, ty, leftBtnX, btnY, btnW, btnH))  return TOUCH_EGG_DEC;
        if (touchInRect(tx, ty, rightBtnX, btnY, btnW, btnH)) return TOUCH_EGG_INC;

        // IR YUMURTA toggle butonu (Kart 5 - cy=240, tgl y = cy+6 = 246)
        const int tglW = 72;
        const int tglH = 24;
        const int tglX = SCR_W - 4 - 8 - tglW;
        const int tglY = 246;
        if (touchInRect(tx, ty, tglX, tglY, tglW, tglH)) {
            _forceRedraw = true;
            return TOUCH_EGG_SENSOR_TOGGLE;
        }
        // IR YUMURTA "BUL" butonu (Kart 5, sol-alt) — cy=240, btnY = cy+18 = 258
        const int bulX = 4 + 8;       // 12
        const int bulY = 254;         // dokunma zonu cy+14..cy+34
        const int bulW = 64;
        const int bulH = 22;
        if (touchInRect(tx, ty, bulX, bulY, bulW, bulH)) {
            _forceRedraw = true;
            return TOUCH_EGG_DISCOVER;
        }

        if (ty > 285) {
            _scrollOffset++;
            _forceRedraw = true;
            return TOUCH_NONE;
        }
    }

    // --- Dashboard: alarm kartina dokunma -> kullanici alarmi sustur (ack) ---
    // (Onceki davranis TOUCH_SAFETY_RESET idi; v3'te alarm ack daha sik kullanilir.
    // Safety reset acil durumda Kontrol tab'indan zaten yapilabilir.)
    if (_tab == TAB_DASH) {
        if (touchInRect(tx, ty, 2, ALM_Y, SCR_W - 4, ALM_H) && data.alarmActive) {
            _forceRedraw = true;
            return TOUCH_ALARM_ACK;
        }
    }

    return TOUCH_NONE;
}

// ==================== UPDATE ====================

TouchAction DisplayManager::update(const DisplayData &data) {
    // Loading animasyonu calisiyorsa once durdur, landscape splash'ten
    // portrait dashboard'a gec (dashboard ilk kez ciziliyor)
    if (_loadingActive) {
        stopLoadingAnimation();
        _tft.fillScreen(COL_BG);
        _tft.setRotation(0);     // portrait'a gec
        _tft.fillScreen(COL_BG);
        _forceRedraw = true;
        _bgDraw      = true;
    }
    // Alarm modal otomatik ac/kapat (alarm aktif + mute degil -> ac)
    if (data.alarmAutoShow && !_alarmModalOpen) {
        _alarmModalOpen  = true;
        _alarmModalDrawn = false;
        _forceRedraw     = true;
    }
    // Alarm temizlendi -> modal'i kapat
    if (!data.alarmActive && _alarmModalOpen) {
        _alarmModalOpen  = false;
        _alarmModalDrawn = false;
        _forceRedraw     = true;
    }

    // Cleaning gecisinde tam ekran yenile (banner alanini temizlemek icin)
    static bool s_prevCleaning = false;
    if (data.cleaningActive != s_prevCleaning) {
        _forceRedraw = true;
        s_prevCleaning = data.cleaningActive;
    }

    // FAZ ILERLEMESI: gun veya aktif evre degisince tam yenile.
    // Profil sekmesindeki evre cerceveleri (yesil/gri/yok) _bgDraw katmaninda
    // cizilir, yani yalnizca tam yenilemede. Bu tetik olmadan gun donse bile
    // tamamlanan evre gri cerceveye GECMEZ; ekran acik kaldigi surece eski
    // durumu gosterir ve ancak sekme degistirilince duzelirdi.
    // Gunde bir kez calisir, maliyeti ihmal edilebilir.
    static int     s_prevDay      = -1;
    static uint8_t s_prevPhaseIdx = 0xFF;
    if (data.currentDay != s_prevDay || data.currentPhaseIndex != s_prevPhaseIdx) {
        _forceRedraw   = true;
        s_prevDay      = data.currentDay;
        s_prevPhaseIdx = data.currentPhaseIndex;
    }

    // Termal kacis bannerinin acilmasi/kapanmasi da alan temizligi ister
    static bool s_prevRunaway = false;
    if (data.thermalRunaway != s_prevRunaway) {
        _forceRedraw  = true;
        s_prevRunaway = data.thermalRunaway;
    }

#if RELAY_TEST_ENABLED
    // Role testine girildiginde/cikildiginda tam yenile: modal zemini bir kez
    // cizilecek, cikista da arka plan temizlenecek.
    static bool s_prevRTest = false;
    if (data.relayTestActive != s_prevRTest) {
        _forceRedraw    = true;
        _relayTestDrawn = false;
        _relayTestSig   = 0xFF;   // butonlar kesin cizilsin
        s_prevRTest     = data.relayTestActive;
    }
#endif

    // Sistem kontrol modali zaman asimi: kazara acildiysa panoyu suresiz
    // kapatmasin, kendiliginden kapansin (hicbir eylem tetiklemeden).
    if (_sysCtrlOpen && (millis() - _sysCtrlOpenedMs) > SYSM_TIMEOUT_MS) {
        _sysCtrlOpen = false;
        _forceRedraw = true;
    }

    // Dokunma her zaman kontrol et (ekran guncelleme beklemeden)
    TouchAction action = handleTouch(data);

    unsigned long now = millis();
    if (!_forceRedraw && _lastUpdate != 0 && (now - _lastUpdate) < DISPLAY_UPDATE_MS) {
        return action;
    }
    _lastUpdate = now;

    _bgDraw = _forceRedraw;
    if (_forceRedraw) {
        _tft.fillRect(0, 0, SCR_W, PAGE_H, COL_BG);
        _forceRedraw = false;
    }

#if RELAY_TEST_ENABLED
    // Role testi acikken her sey onun altinda kalir: otomatik kontrol zaten
    // askida, ekranda da baska bir sey gosterilmesi yaniltici olurdu.
    if (data.relayTestActive) {
        drawRelayTest(data);
        return action;
    }
#endif

    // Sistem kontrol modali en ustte: onay bekleyen bir pencere arka plandaki
    // olcumlerle karistirilmamali.
    // TITREME ONLEME: modal icerigi acikken degismez, bu yuzden yalnizca BIR
    // KEZ cizilir. Eskiden her DISPLAY_UPDATE_MS'de (500 ms) tum zemin
    // fillRoundRect ile yeniden dolduruluyordu; gozle gorulur sekilde
    // yanip sonuyordu.
    if (_sysCtrlOpen) {
        if (_bgDraw || !_sysCtrlDrawn) {
            if (_bgDraw) draw(data);   // arka plani bir kez tazele
            drawSysControl(data);
            _sysCtrlDrawn = true;
        }
        return action;
    }

    // Modal acik degilse normal tab cizimi
    if (!_alarmModalOpen) {
        draw(data);
    } else {
        // Modal: tum tab'larin ustunde tam ekran (tab bar dahil)
        drawAlarmModal(data);
    }
    return action;
}

void DisplayManager::draw(const DisplayData &data) {
    drawTabBar();

    switch (_tab) {
        case TAB_DASH:  drawDashboard(data); break;
        case TAB_GRAPH: drawGraph(data);     break;
        case TAB_CTRL:  drawControl(data);   break;
        case TAB_PROF:  drawProfile(data);   break;
        case TAB_SET:   drawSettings(data);  break;
        default:        drawDashboard(data); break;
    }

    // ===== TEMIZLIK MODU UYARI BANTI (tum sekmeler uzerinde) =====
    // Aktifken her cizimden sonra ust kisima sari/turuncu yanip sonen bir
    // bant ciziyoruz: kullanici hangi sekmede olursa olsun modun aktif
    // oldugunu net gorur.
    // Termal kacis, temizlik modundan ONCELIKLIDIR: biri konfor bilgisi,
    // digeri fiziksel mudahale gerektiren bir donanim arizasi.
    if (data.thermalRunaway) {
        drawRunawayBanner(data);
    } else if (data.cleaningActive) {
        drawCleaningBanner(data);
    }

    // ===== CANDLING (DOL KONTROLU) BILDIRISI =====
    // Bugun kontrol gunu ise temizlik banneri yoksa ust bant goster
    if (data.candlingToday && !data.cleaningActive) {
        drawCandlingBanner(data);
    }
}

void DisplayManager::drawCleaningBanner(const DisplayData &data) {
    // Yanip sonen efekt (500 ms periyot) — kullanici sezmesin diye 2 ton
    bool blink = ((millis() / 500) % 2) == 0;
    uint16_t bg = blink ? COL_ORANGE : COL_RED;

    const int bh = 16;
    const int by = 0;
    _tft.fillRect(0, by, SCR_W, bh, bg);
    _tft.drawFastHLine(0, bh, SCR_W, COL_RED);

    // Sol: uyari ikonu/metin (kucuk font 1)
    _tft.setTextFont(1);
    _tft.setTextSize(1);
    _tft.setTextDatum(ML_DATUM);
    _tft.setTextColor(COL_TEXT, bg);
    _tft.setTextPadding(0);
    _tft.drawString("! TEMIZLIK MODU AKTIF", 4, by + bh / 2);

    // Sag: kalan dakika + heater/fan PWM (live geri bildirim)
    unsigned long mins = (data.cleaningRemainMs + 59999UL) / 60000UL;
    char buf[40];
    snprintf(buf, sizeof(buf), "H%u F%u %lud",
             data.heaterPWM, data.fanPWM, mins);
    _tft.setTextDatum(MR_DATUM);
    _tft.drawString(buf, SCR_W - 4, by + bh / 2);
    _tft.setTextDatum(TL_DATUM);
}

void DisplayManager::drawCandlingBanner(const DisplayData &data) {
    // Yanip sonen efekt (500 ms periyot) — kirmizi/sari (dikkat cekici)
    bool blink = ((millis() / 500) % 2) == 0;
    uint16_t bg = blink ? COL_RED : COL_ORANGE;

    const int bh = 18;
    const int by = 0;
    _tft.fillRect(0, by, SCR_W, bh, bg);
    _tft.drawFastHLine(0, bh, SCR_W, COL_RED);

    // Sol: dol kontrolu uyari metni (kalinca yazı)
    _tft.setTextFont(2);
    _tft.setTextSize(1);
    _tft.setTextDatum(ML_DATUM);
    _tft.setTextColor(COL_TEXT, bg);
    _tft.setTextPadding(0);
    char buf[56];
    snprintf(buf, sizeof(buf), "🔔 DOL KONTROLU ZAMANI! %s", data.candlingLabel ? data.candlingLabel : "");
    _tft.drawString(buf, 4, by + bh / 2);

    // Sag: lockdown gunu
    _tft.setTextFont(1);
    snprintf(buf, sizeof(buf), "Lockdown: G%u", data.candlingLockdownDay);
    _tft.setTextDatum(MR_DATUM);
    _tft.drawString(buf, SCR_W - 4, by + bh / 2);
    _tft.setTextDatum(TL_DATUM);
}

// ==================== TAB BAR (ALTTA) ====================

void DisplayManager::drawTabBar() {
    int tabW = SCR_W / TAB_COUNT;
    int by = PAGE_H;

    // Tab bar her zaman cizilsin (ilk acilista ve sekme degisiminde)
    _tft.fillRect(0, by, SCR_W, TAB_H, COL_CARD);
    _tft.drawFastHLine(0, by, SCR_W, COL_DIM);

    for (int i = 0; i < TAB_COUNT; i++) {
        int bx = i * tabW;
        bool active = (i == (int)_tab);

        _tft.setTextFont(2);
        _tft.setTextSize(1);
        _tft.setTextDatum(MC_DATUM);
        _tft.setTextPadding(0);

        if (active) {
            _tft.fillRect(bx + 1, by + 1, tabW - 2, TAB_H - 1, COL_BG);
            _tft.fillRect(bx + 4, by + 1, tabW - 8, 2, COL_BLUE);
        }

        uint16_t bg = active ? COL_BG : COL_CARD;
        _tft.setTextColor(active ? COL_BLUE : COL_DIM, bg);
        _tft.drawString(TAB_LABEL[i], bx + tabW / 2, by + TAB_H / 2 + 4);
    }
}

// ==================== SAYFA: DASHBOARD ====================

void DisplayManager::drawDashboard(const DisplayData &data) {
    drawHeader(data);
    drawGauges(data);
    drawInfoRow(data);
    drawOutputs(data);
    drawSensors(data);
    drawAlarm(data);
    drawStatusStrip(data);   // CO2 + yumurta IR kaynagi + I/O sagligi
}

// ==================== SAYFA: GRAFIK (GAUGE TARZI - FLICKER-FREE) ====================

// ---------------------------------------------------------------------
//  Sensor durum gosterimi - iki ekranin da kullandigi TEK kaynak
//
//  Uc durum ayridir ve karistirilmamalidir:
//    OK   : takili, okuyor
//    HATA : takili ama cevap vermiyor -> GERCEK ARIZA (kirmizi)
//    YOK  : donanim hic takili degil -> normal (gri)
//  Takili olmayana alarm rengi vermek gercek arizayi siradanlastirir.
// ---------------------------------------------------------------------
const char* DisplayManager::sensorStateText(bool ok, bool present) {
    if (ok)      return "OK";
    if (present) return "HATA";
    return "YOK";
}

uint16_t DisplayManager::sensorStateColor(bool ok, bool present) const {
    if (ok)      return COL_GREEN;
    if (present) return COL_RED;
    return COL_DIM;
}

// ---------------------------------------------------------------------
//  Olcum durum renkleri - Durum ve Olcum sekmelerinin ortak kaynagi
// ---------------------------------------------------------------------
uint16_t DisplayManager::tempStateColor(float temp, float target) const {
    float d = temp - target;
    if (fabs(d) <= 0.5f) return COL_GREEN;
    return (d > 0) ? COL_RED : COL_BLUE;   // sicak kirmizi, soguk mavi
}

uint16_t DisplayManager::humStateColor(float hum, float low, float high) const {
    if (hum >= low && hum <= high) return COL_GREEN;
    return (hum > high) ? COL_CYAN : COL_ORANGE;   // nemli cyan, kuru turuncu
}

uint16_t DisplayManager::co2StateColor(uint16_t co2, bool valid,
                                       uint16_t low, uint16_t high,
                                       uint16_t critical) const {
    // Sensor yoksa gri: 0 ppm'i YESIL "normal" gostermek "hava temiz"
    // izlenimi verir, oysa hicbir olcum yoktur.
    if (!valid)          return COL_DIM;
    if (co2 >= critical) return COL_RED;
    if (co2 >= high)     return COL_ORANGE;
    if (co2 <= low)      return COL_GREEN;
    return COL_YELLOW;
}

void DisplayManager::drawGauge(int cx, int cy, int r, float value, float minVal,
                                float maxVal, float target, uint16_t color,
                                const char* label, const char* unit,
                                float bandLo, float bandHi,
                                GaugeDev devMode, uint8_t devDecimals) {
    const bool showDev = (devMode != DEV_NONE);
    // Sadece ilk cizimde statik elemanlari ciz
    if (_bgDraw) {
        // Arkaplan yay (koyu gri) - sadece 1 kez cizilir
        for (int i = 0; i <= 180; i += 3) {
            float angle = (180.0f - i) * DEG2RAD;
            int x1 = cx + cos(angle) * (r - 6);
            int y1 = cy - sin(angle) * (r - 6);
            int x2 = cx + cos(angle) * r;
            int y2 = cy - sin(angle) * r;
            _tft.drawLine(x1, y1, x2, y2, 0x2104);
        }
        
        // Isaretciler - sadece 1 kez cizilir.
        //   set noktasi : kalin (2px) turuncu, yayin disina tasar
        //   bant sinirlari: ince (1px) turuncu, alarm esiklerini gosterir
        auto drawMark = [&](float t, bool thick) {
            float tr = (t - minVal) / (maxVal - minVal);
            tr = constrain(tr, 0.0f, 1.0f);
            float tAngle = (180.0f - tr * 180.0f) * DEG2RAD;
            int tx1 = cx + cos(tAngle) * (r - 10);
            int ty1 = cy - sin(tAngle) * (r - 10);
            int tx2 = cx + cos(tAngle) * (r + (thick ? 4 : 2));
            int ty2 = cy - sin(tAngle) * (r + (thick ? 4 : 2));
            _tft.drawLine(tx1, ty1, tx2, ty2, COL_ORANGE);
            if (thick) _tft.drawLine(tx1 + 1, ty1, tx2 + 1, ty2, COL_ORANGE);
        };
        if (bandLo > GAUGE_NONE + 1.0f) drawMark(bandLo, false);
        if (bandHi > GAUGE_NONE + 1.0f) drawMark(bandHi, false);
        if (target > GAUGE_NONE + 1.0f) drawMark(target, true);
        
        // Min/Max etiketleri - sadece 1 kez
        _tft.setTextFont(1);
        _tft.setTextDatum(TC_DATUM);
        _tft.setTextColor(COL_DIM, COL_BG);
        char buf[8];
        sprintf(buf, "%.0f", minVal);
        _tft.drawString(buf, cx - r + 8, cy + 6);
        sprintf(buf, "%.0f", maxVal);
        _tft.drawString(buf, cx + r - 8, cy + 6);
        
        // Birim - sadece 1 kez.
        // Sapma satiri gosterilecekse ayni yeri o kullanir (birimi kendi
        // icinde yazar), burada cizmiyoruz; yoksa ust uste binerdi.
        if (!showDev) {
            _tft.setTextFont(2);
            _tft.setTextDatum(MC_DATUM);
            _tft.setTextColor(COL_DIM, COL_BG);
            _tft.drawString(unit, cx, cy + 42);
        }
        
        // Etiket (ust) - sadece 1 kez
        _tft.setTextFont(2);
        _tft.setTextColor(COL_TEXT, COL_BG);
        _tft.drawString(label, cx, cy - r - 12);
    }
    
    // Deger yayi (renkli) - her zaman guncellenir
    float ratio = (value - minVal) / (maxVal - minVal);
    ratio = constrain(ratio, 0.0f, 1.0f);
    int sweepDeg = (int)(ratio * 180);

    // Kabul edilebilir bant. Yay her karede yeniden cizildigi icin turuncu
    // sinir cizgilerinin yay uzerine denk gelen kismi siliniyor; bandi
    // ibrenin ulasmadigi bolgede koyu gri yerine soluk yesil cizerek kalici
    // hale getiriyoruz. Boylece "normal aralik" ibre nerede olursa olsun
    // gorunur kalir.
    int bandDegLo = -1, bandDegHi = -1;
    if (bandLo > GAUGE_NONE + 1.0f && bandHi > GAUGE_NONE + 1.0f) {
        float lo = fminf(bandLo, bandHi);
        float hi = fmaxf(bandLo, bandHi);
        float rLo = constrain((lo - minVal) / (maxVal - minVal), 0.0f, 1.0f);
        float rHi = constrain((hi - minVal) / (maxVal - minVal), 0.0f, 1.0f);
        bandDegLo = (int)(rLo * 180.0f);
        bandDegHi = (int)(rHi * 180.0f);
    }

    for (int i = 0; i <= 180; i += 3) {
        float angle = (180.0f - i) * DEG2RAD;
        int x1 = cx + cos(angle) * (r - 6);
        int y1 = cy - sin(angle) * (r - 6);
        int x2 = cx + cos(angle) * r;
        int y2 = cy - sin(angle) * r;
        uint16_t offCol = (bandDegLo >= 0 && i >= bandDegLo && i <= bandDegHi)
                            ? 0x0320      // soluk yesil = normal aralik
                            : 0x2104;     // koyu gri    = aralik disi
        uint16_t col = (i <= sweepDeg) ? color : offCol;
        _tft.drawLine(x1, y1, x2, y2, col);
    }
    
    // Merkez daire (ibre merkezi)
    _tft.fillCircle(cx, cy, 5, COL_TEXT);
    
    // Deger (buyuk, ortada) - textPadding ile uzerine yaz
    _tft.setTextFont(4);
    _tft.setTextDatum(MC_DATUM);
    _tft.setTextColor(color, COL_BG);
    _tft.setTextPadding(60);
    char buf[8];
    sprintf(buf, "%.1f", value);
    _tft.drawString(buf, cx, cy + 22);
    _tft.setTextPadding(0);

    // Sapma satiri: "hedefe ne kadar kaldi / ne kadar asildi".
    // Renk ISA-101 mantigiyla: hedefteyken soluk gri (dikkat cekmesin),
    // disina cikinca kadran rengi (goz oraya gitsin).
    if (showDev) {
        char devBuf[20];
        bool  inTarget = false;
        float dev = 0.0f;
        const bool hasBand = (bandLo > GAUGE_NONE + 1.0f && bandHi > GAUGE_NONE + 1.0f);
        const float lo = hasBand ? fminf(bandLo, bandHi) : 0.0f;
        const float hi = hasBand ? fmaxf(bandLo, bandHi) : 0.0f;

        if (devMode == DEV_SETPOINT) {
            // Tek hedefli olcum: sapma her zaman set noktasina gore.
            // Deger bandin icindeyse "normal" sayilir ama sayi yine yazilir;
            // 0.1 C'lik sapmalari izlemek kulucka icin degerli.
            dev = value - target;
            inTarget = hasBand ? (value >= lo && value <= hi)
                               : (fabsf(dev) < 0.05f);
            snprintf(devBuf, sizeof(devBuf), "%+.*f %s", (int)devDecimals, dev, unit);
        } else {
            // Aralik hedefli olcum: aralik ICINDE sapma diye bir sey yoktur;
            // ortalamaya gore sapma yazmak yaniltir (%56 da %64 de hedeftedir).
            // Disarda ise en yakin sinira olan uzaklik gosterilir.
            if      (value < lo) { dev = value - lo; }
            else if (value > hi) { dev = value - hi; }
            else                 { inTarget = true;  }

            if (inTarget) snprintf(devBuf, sizeof(devBuf), "HEDEFTE");
            else          snprintf(devBuf, sizeof(devBuf), "%+.*f %s",
                                   (int)devDecimals, dev, unit);
        }

        _tft.setTextFont(2);
        _tft.setTextDatum(MC_DATUM);
        _tft.setTextColor(inTarget ? COL_DIM : color, COL_BG);
        _tft.setTextPadding(70);
        _tft.drawString(devBuf, cx, cy + 42);
        _tft.setTextPadding(0);
    }
}

void DisplayManager::drawGraph(const DisplayData &data) {
    const int cardMargin = 4;
    const int cardPadX = 8;
    const int cardW = SCR_W - cardMargin * 2;
    
    // ========== UST KART: PROFIL BILGISI ==========
    const int hdrH = 42;
    if (_bgDraw) {
        _tft.fillRoundRect(cardMargin, 2, cardW, hdrH, 6, COL_CARD);
        _tft.drawRoundRect(cardMargin, 2, cardW, hdrH, 6, 0x3186);
        _prevTemp = -999;
        _prevHum = -999;
    }
    
    // Hayvan ikonu (sol) - profil adi ile eslestirilir (index sirasindan bagimsiz)
    // Her hayvanin kendi rengi var (tavuk kahve, kaz beyaz, papagan yesil, ari sari vb.)
    if (_bgDraw) {
        const AnimalIconEntry* entry = getAnimalIconEntryByName(data.profileName);
        _tft.drawXBitmap(cardMargin + 6, 7, entry->icon, ICON_WIDTH, ICON_HEIGHT, entry->color);
    }
    
    // Profil adi ve gun bilgisi (ikonun yaninda)
    _tft.setTextFont(2);
    _tft.setTextDatum(TL_DATUM);
    _tft.setTextColor(COL_TEXT, COL_CARD);
    _tft.setTextPadding(100);
    _tft.drawString(data.profileName ? data.profileName : "---", cardMargin + ICON_WIDTH + 14, 8);
    
    _tft.setTextFont(1);
    _tft.setTextColor(COL_ORANGE, COL_CARD);
    char dayInfo[24];
    sprintf(dayInfo, "Gun %d/%d | Kalan: %d", data.currentDay, data.totalDays, data.remainingDays);
    _tft.drawString(dayInfo, cardMargin + ICON_WIDTH + 14, 26);
    
    // secgem.com (sag ust)
    _tft.setTextFont(2);
    _tft.setTextDatum(TR_DATUM);
    _tft.setTextColor(COL_CYAN, COL_CARD);
    _tft.drawString("secgem.com", SCR_W - cardMargin - cardPadX, 6);
    _tft.setTextDatum(TL_DATUM);
    _tft.setTextPadding(0);
    
    // ========== GAUGE ALANI ==========
    // Ust satir: Sicaklik (sol) + Nem (sag) yan yana
    // Alt satir: CO2 (ortada)
    const int GAUGE_R = 38;  // Ust gauge radius
    const int GAUGE_R_CO2 = 32;  // CO2 gauge biraz kucuk
    const int GAUGE_Y1 = hdrH + 21 + GAUGE_R;  // Ust satir Y (+13px asagi)
    const int GAUGE1_X = SCR_W / 4;           // Sicaklik (sol)
    const int GAUGE2_X = 3 * SCR_W / 4;       // Nem (sag)
    const int GAUGE_Y2 = GAUGE_Y1 + GAUGE_R + 8 + GAUGE_R_CO2;  // Alt satir Y
    const int GAUGE3_X = SCR_W / 2;           // CO2 (orta)
    
    // Deger degisti mi kontrol et
    bool tempChanged = (fabs(data.temperature - _prevTemp) >= 0.1f);
    bool humChanged = (fabs(data.humidity - _prevHum) >= 0.1f);
    bool co2Changed = (data.co2 != _prevCO2);
    
    // ---- Kadran olcek sinirlari (uyarlanabilir) ----
    // Normalde hedefin +/-3 C'lik dar bir penceresi kullanilir; kulucka
    // calisirken bu yuksek cozunurluk verir.
    //
    // Ancak ISINMA sirasinda olcum bu pencerenin tamamen disinda kalir
    // (orn. hedef 37.8, oda 28). drawGauge oranı constrain() ile 0'a
    // kirptigi icin ibre 28 -> 34.8 arasindaki tum yolculuk boyunca
    // sifirda cakili durur; kullanici hedefe yaklasmayi izleyemez.
    //
    // Cozum: olcum disarda kaldiginda pencereyi olcumu icine alacak sekilde
    // genislet. Genisletme 5'er derecelik adimlarla yapilir; her okumada
    // olcegin kaymasini onler, ibre gercekten hareket eder.
    float tempMin = data.targetTemp - 3.0f;
    float tempMax = data.targetTemp + 3.0f;
    if (data.temperature < tempMin) tempMin = floorf(data.temperature / 5.0f) * 5.0f;
    if (data.temperature > tempMax) tempMax = ceilf(data.temperature / 5.0f) * 5.0f;

    float humMin = data.targetHumLow - 10.0f;
    float humMax = data.targetHumHigh + 10.0f;
    if (data.humidity < humMin) humMin = floorf(data.humidity / 10.0f) * 10.0f;
    if (data.humidity > humMax) humMax = ceilf(data.humidity / 10.0f) * 10.0f;
    if (humMin < 0.0f)   humMin = 0.0f;
    if (humMax > 100.0f) humMax = 100.0f;

    // Olcek degistiyse min/max etiketleri ve hedef isaretcisi yenilenmeli.
    // Bunlar yalnizca _bgDraw'da cizildigi icin tam yeniden cizim gerekir.
    // Adimli genisletme sayesinde bu nadiren tetiklenir (titreme olmaz).
    if (tempMin != _prevTempMin || tempMax != _prevTempMax ||
        humMin  != _prevHumMin  || humMax  != _prevHumMax) {
        _prevTempMin = tempMin;  _prevTempMax = tempMax;
        _prevHumMin  = humMin;   _prevHumMax  = humMax;
        _forceRedraw = true;
    }
    
    // CO2 sinir degerleri (profil bazli)
    float co2Min = 0;
    float co2Max = (float)data.co2Critical + 1000;  // Kritik + 1000 ppm
    float co2Target = (float)data.co2Low;           // Hedef = alt limit
    
    // Durum renkleri - Durum sekmesiyle ORTAK kaynak (bkz. *StateColor)
    uint16_t tempColor = tempStateColor(data.temperature, data.targetTemp);
    uint16_t humColor  = humStateColor(data.humidity, data.targetHumLow, data.targetHumHigh);
    uint16_t co2Color  = co2StateColor(data.co2, data.co2Valid,
                                       data.co2Low, data.co2High, data.co2Critical);
    
    bool tempColorChanged = (tempColor != _prevTempColor);
    bool humColorChanged = (humColor != _prevHumColor);
    bool co2ColorChanged = (co2Color != _prevCO2Color);
    
    // Sicaklik gauge (sol ust)
    // Sicaklikta TEK dogru deger vardir (set noktasi) + cevresinde alarm
    // uretmeyen tolerans bandi. Bu yuzden kalin set noktasi cizgisi ile
    // birlikte +/- ALARM_TEMP_TOLERANCE bandi gosterilir: operator hem
    // "nereye gitmeli" hem "ne zaman alarm calar" bilgisini ayni anda gorur.
    if (tempChanged || tempColorChanged || _bgDraw) {
        drawGauge(GAUGE1_X, GAUGE_Y1, GAUGE_R,
                  data.temperature, tempMin, tempMax, data.targetTemp,
                  tempColor, "SICAKLIK", "C",
                  data.targetTemp - ALARM_TEMP_TOLERANCE,
                  data.targetTemp + ALARM_TEMP_TOLERANCE,
                  DEV_SETPOINT, 1);   // sapma: set noktasina gore, 0.1 C
        _prevTemp = data.temperature;
        _prevTempColor = tempColor;
    }
    
    // Nem gauge (sag ust)
    // Nem TEK bir hedef degil ARALIK ister (orn. %55-65). Ortalamayi tek
    // isaretci olarak gostermek yaniltiyordu: %56 da %64 de hedefte olmasina
    // ragmen ibre isaretciden uzak gorunuyordu. Artik alt ve ust sinir ayri
    // cizgilerle, aralarindaki bant da soluk yesil ile gosteriliyor.
    if (humChanged || humColorChanged || _bgDraw) {
        drawGauge(GAUGE2_X, GAUGE_Y1, GAUGE_R,
                  data.humidity, humMin, humMax,
                  GAUGE_NONE,          // nemde tek set noktasi yok
                  humColor, "NEM", "%",
                  data.targetHumLow, data.targetHumHigh,
                  DEV_BAND, 1);        // sapma: aralik sinirina gore
        _prevHum = data.humidity;
        _prevHumColor = humColor;
    }
    
    // CO2 gauge (alt orta) - sensor yoksa birim "YOK" yazar
    if (co2Changed || co2ColorChanged || _bgDraw) {
        // CO2'de "dusuk iyidir": set noktasi yok, tabandan alt limite kadar
        // olan bolge kabul edilebilir bant.
        // Sensor yokken sapma satiri gosterilmez: 0 ppm bandin icinde
        // kaldigi icin "HEDEFTE" yazardi ve olcum varmis gibi gorunurdu.
        drawGauge(GAUGE3_X, GAUGE_Y2, GAUGE_R_CO2,
                  (float)data.co2, co2Min, co2Max, GAUGE_NONE,
                  co2Color, "CO2", data.co2Valid ? "ppm" : "YOK",
                  co2Min, co2Target,
                  data.co2Valid ? DEV_BAND : DEV_NONE, 0);  // ppm tam sayi
        _prevCO2 = data.co2;
        _prevCO2Color = co2Color;
    }
    
    // ========== ALT KART: DETAY BILGISI ==========
    const int INFO_Y = GAUGE_Y2 + GAUGE_R_CO2 + 14;
    const int INFO_H = 60;  // 3. satir (IR yumurta) icin genisletildi
    
    if (_bgDraw) {
        _tft.fillRoundRect(cardMargin, INFO_Y, cardW, INFO_H, 6, COL_CARD);
        _tft.drawRoundRect(cardMargin, INFO_Y, cardW, INFO_H, 6, 0x3186);
        // IR satiri icin ince ayirici
        _tft.drawFastHLine(cardMargin + 4, INFO_Y + 41, cardW - 8, 0x2104);
    }
    
    // Ust satir: Evre ve CO2 limitleri
    _tft.setTextFont(2);
    _tft.setTextDatum(TL_DATUM);
    _tft.setTextColor(COL_GREEN, COL_CARD);
    _tft.setTextPadding(80);
    _tft.drawString(data.phaseName ? data.phaseName : "---", cardPadX + cardMargin, INFO_Y + 6);
    
    _tft.setTextDatum(TR_DATUM);
    _tft.setTextColor(COL_DIM, COL_CARD);
    _tft.setTextPadding(120);
    char co2LimitStr[32];
    sprintf(co2LimitStr, "CO2: %u/%u ppm", data.co2High, data.co2Critical);
    _tft.drawString(co2LimitStr, SCR_W - cardMargin - cardPadX, INFO_Y + 6);
    
    // Alt satir: Hedef degerler ve yumurta sayisi
    _tft.setTextFont(1);
    _tft.setTextDatum(TL_DATUM);
    _tft.setTextColor(COL_DIM, COL_CARD);
    _tft.setTextPadding(100);
    char targetStr[32];
    sprintf(targetStr, "%.1fC | %%%d-%%%d", data.targetTemp, (int)data.targetHumLow, (int)data.targetHumHigh);
    _tft.drawString(targetStr, cardPadX + cardMargin, INFO_Y + 28);
    
    _tft.setTextDatum(TR_DATUM);
    _tft.setTextColor(COL_TEXT, COL_CARD);
    _tft.setTextPadding(100);
    char eggStr[24];
    sprintf(eggStr, "Yumurta: %u", (unsigned)data.eggCount);
    _tft.drawString(eggStr, SCR_W - cardMargin - cardPadX, INFO_Y + 28);

    // Alt satir: Yumurta IR sicaklik (3. satir)
    _tft.setTextDatum(TL_DATUM);
    _tft.setTextColor(COL_DIM, COL_CARD);
    _tft.setTextPadding(80);
    _tft.drawString("Yumurta Sicaklik:", cardPadX + cardMargin, INFO_Y + 46);
    
    char eggTempStr[26];
    if (data.eggTempValid) {
        // Kaynak da yazilir: yerel MLX90614 mi, yoksa WiFi yedegine mi
        // dusuldu? Yedege dusuldugunde olcum agdan geliyor demektir ve
        // baglanti koparsa veri bayatlar - kullanici bunu bilmeli.
        // °C sembolu: extended ASCII 0xB0 (TFT_eSPI font 2/4 destekler)
        snprintf(eggTempStr, sizeof(eggTempStr), "%.1f \xB0""C (%s)",
                 data.eggTemp,
                 (data.eggTempSource == 1) ? "yerel" : "uzak");
        _tft.setTextColor((data.eggTempSource == 1) ? COL_YELLOW : COL_CYAN,
                          COL_CARD);
    } else {
        snprintf(eggTempStr, sizeof(eggTempStr), "Baglanti yok");
        _tft.setTextColor(COL_DIM, COL_CARD);
    }
    _tft.setTextDatum(TR_DATUM);
    _tft.setTextPadding(120);
    _tft.drawString(eggTempStr, SCR_W - cardMargin - cardPadX, INFO_Y + 46);
    _tft.setTextPadding(0);
    _tft.setTextDatum(TL_DATUM);
}

void DisplayManager::drawHeader(const DisplayData &data) {
    if (_bgDraw) {
        _tft.fillRect(0, HDR_Y, SCR_W, HDR_H, COL_CARD);
    }

    _tft.setTextFont(2);
    _tft.setTextSize(1);
    _tft.setTextDatum(TL_DATUM);
    _tft.setTextColor(COL_TEXT, COL_CARD);
    _tft.setTextPadding(100);
    _tft.drawString(data.profileName ? data.profileName : "---", 5, HDR_Y + 1);

    char sub[40];
    int rd = data.remainingDays < 0 ? 0 : data.remainingDays;
    if (data.hatchDate.length() > 0) {
        snprintf(sub, sizeof(sub), "Gun %d/%d | C:%s",
                 data.currentDay, data.totalDays, data.hatchDate.c_str());
    } else {
        snprintf(sub, sizeof(sub), "Gun %d/%d | %s | %dg",
                 data.currentDay, data.totalDays,
                 data.phaseName ? data.phaseName : "---", rd);
    }
    _tft.setTextFont(1);
    _tft.setTextColor(COL_DIM, COL_CARD);
    _tft.drawString(sub, 5, HDR_Y + 18);

    int si = constrain(data.systemState, 0, 6);
    const char* sn = ST_BADGE[si];
    uint16_t sc = ST_CLR[si];
    _tft.setTextFont(1);
    int tw = _tft.textWidth(sn);
    int bw = tw + 12;
    int bx = SCR_W - bw - 4;
    _tft.fillRoundRect(bx, HDR_Y + 4, bw, 16, 4, sc);
    _tft.setTextDatum(MC_DATUM);
    _tft.setTextColor(COL_TEXT, sc);
    _tft.drawString(sn, bx + bw / 2, HDR_Y + 12);
}

void DisplayManager::drawGauges(const DisplayData &data) {
    const int gw = 115;
    int lx = 2;
    int rx = SCR_W - gw - 2;

    // Sicaklik
    if (_bgDraw) {
        _tft.fillRoundRect(lx, GAU_Y, gw, GAU_H, 4, COL_CARD);
        _tft.fillRect(lx + 1, GAU_Y + 4, 3, GAU_H - 8, COL_RED);
    }

    _tft.setTextFont(4);
    _tft.setTextSize(1);
    _tft.setTextDatum(TC_DATUM);
    // Deger, Olcum sekmesiyle AYNI durum rengini kullanir. Eskiden burada
    // hep beyaz yaziliyordu: ayni sicaklik bir sekmede kirmizi, digerinde
    // notr gorunuyordu ve Durum sekmesi sapmayi hic belli etmiyordu.
    _tft.setTextColor(tempStateColor(data.temperature, data.targetTemp), COL_CARD);
    _tft.setTextPadding(_tft.textWidth("88.8"));
    char ts[8];
    dtostrf(data.temperature, 4, 1, ts);
    _tft.drawString(ts, lx + gw / 2, GAU_Y + 4);

    _tft.setTextFont(1);
    _tft.setTextColor(COL_DIM, COL_CARD);
    _tft.setTextPadding(0);
    _tft.drawString("C SICAKLIK", lx + gw / 2, GAU_Y + 34);
    // Hedef satiri kirmizi: olculen degerle karistirilmamasi icin ayirt edici
    _tft.setTextColor(COL_RED, COL_CARD);
    char tt[16];
    snprintf(tt, sizeof(tt), "Hedef: %.1f", data.targetTemp);
    _tft.setTextPadding(_tft.textWidth("Hedef: 88.8"));
    _tft.drawString(tt, lx + gw / 2, GAU_Y + 44);
    _tft.setTextPadding(0);

    // Nem
    if (_bgDraw) {
        _tft.fillRoundRect(rx, GAU_Y, gw, GAU_H, 4, COL_CARD);
        _tft.fillRect(rx + 1, GAU_Y + 4, 3, GAU_H - 8, COL_BLUE);
    }

    _tft.setTextFont(4);
    _tft.setTextDatum(TC_DATUM);
    _tft.setTextColor(humStateColor(data.humidity, data.targetHumLow,
                                    data.targetHumHigh), COL_CARD);
    _tft.setTextPadding(_tft.textWidth("88.8"));
    char hs[8];
    dtostrf(data.humidity, 4, 1, hs);
    _tft.drawString(hs, rx + gw / 2, GAU_Y + 4);

    _tft.setTextFont(1);
    _tft.setTextColor(COL_DIM, COL_CARD);
    _tft.setTextPadding(0);
    _tft.drawString("% NEM", rx + gw / 2, GAU_Y + 34);
    // Hedef araligi kirmizi (sicaklik karti ile ayni dil)
    _tft.setTextColor(COL_RED, COL_CARD);
    char ht[16];
    snprintf(ht, sizeof(ht), "%%%d - %%%d", (int)data.targetHumLow, (int)data.targetHumHigh);
    _tft.setTextPadding(_tft.textWidth("%88 - %88"));
    _tft.drawString(ht, rx + gw / 2, GAU_Y + 44);
    _tft.setTextPadding(0);
}

void DisplayManager::drawInfoRow(const DisplayData &data) {
    const int bw = 56;
    const int gap = (SCR_W - 4 * bw - 4) / 3;
    int x1 = 2, x2 = x1 + bw + gap, x3 = x2 + bw + gap, x4 = x3 + bw + gap;

    // Evre
    if (_bgDraw) _tft.fillRoundRect(x1, INF_Y, bw, INF_H, 4, COL_CARD);
    _tft.setTextFont(1);
    _tft.setTextSize(1);
    _tft.setTextDatum(TC_DATUM);
    _tft.setTextColor(COL_DIM, COL_CARD);
    _tft.setTextPadding(0);
    _tft.drawString("EVRE", x1 + bw / 2, INF_Y + 3);
    _tft.setTextFont(2);
    _tft.setTextColor(COL_TEXT, COL_CARD);
    _tft.setTextPadding(bw - 4);
    _tft.drawString(data.phaseName ? data.phaseName : "---", x1 + bw / 2, INF_Y + 14);
    _tft.setTextFont(1);
    _tft.setTextColor(COL_DIM, COL_CARD);
    _tft.setTextPadding(bw - 8);
    char p1[16];
    snprintf(p1, sizeof(p1), "Bitis: %dg", data.phaseRemainingDays);
    _tft.drawString(p1, x1 + bw / 2, INF_Y + 35);
    _tft.setTextPadding(0);

    // Kalan
    if (_bgDraw) _tft.fillRoundRect(x2, INF_Y, bw, INF_H, 4, COL_CARD);
    _tft.setTextFont(1);
    _tft.setTextColor(COL_DIM, COL_CARD);
    _tft.drawString("KALAN", x2 + bw / 2, INF_Y + 3);
    _tft.setTextFont(2);
    _tft.setTextColor(COL_TEXT, COL_CARD);
    _tft.setTextPadding(bw - 4);
    int rem = data.remainingDays < 0 ? 0 : data.remainingDays;
    char r1[12];
    snprintf(r1, sizeof(r1), "%d gun", rem);
    _tft.drawString(r1, x2 + bw / 2, INF_Y + 14);
    _tft.setTextFont(1);
    _tft.setTextColor(COL_DIM, COL_CARD);
    _tft.setTextPadding(bw - 8);
    char d1[12];
    snprintf(d1, sizeof(d1), "Gun %d/%d", data.currentDay, data.totalDays);
    _tft.drawString(d1, x2 + bw / 2, INF_Y + 35);
    _tft.setTextPadding(0);

    // Durum - DOKUNULABILIR (sistem kontrol modalini acar).
    // Cyan cerceve, dokunulabilir oldugunu belli eder; diger kartlarda yok.
    if (_bgDraw) {
        _tft.fillRoundRect(x3, INF_Y, bw, INF_H, 4, COL_CARD);
        _tft.drawRoundRect(x3, INF_Y, bw, INF_H, 4, COL_CYAN);
    }
    _tft.setTextFont(1);
    _tft.setTextColor(COL_CYAN, COL_CARD);
    _tft.drawString("DURUM >", x3 + bw / 2, INF_Y + 3);
    int si = constrain(data.systemState, 0, 6);
    _tft.setTextFont(2);
    _tft.setTextColor(COL_TEXT, COL_CARD);
    _tft.setTextPadding(bw - 4);
    _tft.drawString(ST_SHORT[si], x3 + bw / 2, INF_Y + 14);
    _tft.setTextFont(1);
    _tft.setTextColor(COL_DIM, COL_CARD);
    _tft.setTextPadding(0);
    _tft.drawString(data.profileName ? data.profileName : "---", x3 + bw / 2, INF_Y + 35);

    // Yumurta
    if (_bgDraw) _tft.fillRoundRect(x4, INF_Y, bw, INF_H, 4, COL_CARD);
    _tft.setTextFont(1);
    _tft.setTextColor(COL_DIM, COL_CARD);
    _tft.drawString("YUM", x4 + bw / 2, INF_Y + 3);
    _tft.setTextFont(2);
    _tft.setTextColor(COL_TEXT, COL_CARD);
    _tft.setTextPadding(bw - 4);
    char ec[10];
    snprintf(ec, sizeof(ec), "%u", (unsigned)data.eggCount);
    _tft.drawString(ec, x4 + bw / 2, INF_Y + 14);
    _tft.setTextFont(1);
    _tft.setTextColor(COL_DIM, COL_CARD);
    _tft.setTextPadding(0);
    _tft.drawString("adet", x4 + bw / 2, INF_Y + 35);
}

void DisplayManager::drawOutputs(const DisplayData &data) {
    if (_bgDraw) _tft.fillRoundRect(2, OUT_Y, SCR_W - 4, OUT_H, 4, COL_CARD);

    const int lblX = 8;
    const int barX = 55;
    const int barW = 148;
    const int barH = 12;

    // Isitici
    int iy = OUT_Y + 6;
    _tft.setTextFont(1);
    _tft.setTextSize(1);
    _tft.setTextDatum(ML_DATUM);
    _tft.setTextColor(COL_DIM, COL_CARD);
    _tft.setTextPadding(0);
    _tft.drawString("Isitici", lblX, iy + barH / 2);
    drawBar(barX, iy, barW, barH, data.heaterPWM, 255, COL_ORANGE, COL_BAR_BG);
    _tft.setTextDatum(MR_DATUM);
    _tft.setTextColor(COL_TEXT, COL_CARD);
    _tft.setTextPadding(24);
    char hv[6]; snprintf(hv, sizeof(hv), "%d", data.heaterPWM);
    _tft.drawString(hv, SCR_W - 8, iy + barH / 2);

    // Fan
    int fy = iy + barH + 6;
    _tft.setTextDatum(ML_DATUM);
    _tft.setTextColor(COL_DIM, COL_CARD);
    _tft.setTextPadding(0);
    _tft.drawString("Fan", lblX, fy + barH / 2);
    drawBar(barX, fy, barW, barH, data.fanPWM, 255, COL_CYAN, COL_BAR_BG);
    _tft.setTextDatum(MR_DATUM);
    _tft.setTextColor(COL_TEXT, COL_CARD);
    _tft.setTextPadding(24);
    char fv[6]; snprintf(fv, sizeof(fv), "%d", data.fanPWM);
    _tft.drawString(fv, SCR_W - 8, fy + barH / 2);

    // Nem
    int ny = fy + barH + 6;
    _tft.setTextDatum(ML_DATUM);
    _tft.setTextColor(COL_DIM, COL_CARD);
    _tft.setTextPadding(0);
    _tft.drawString("Nem", lblX, ny + barH / 2);
    uint16_t indBg = data.humidifierOn ? COL_GREEN : COL_BAR_BG;
    uint16_t indFg = data.humidifierOn ? COL_TEXT : COL_DIM;
    _tft.fillRoundRect(barX, ny, barW, barH, barH / 2, indBg);
    _tft.setTextDatum(MC_DATUM);
    _tft.setTextColor(indFg, indBg);
    _tft.drawString(data.humidifierOn ? "ACIK" : "KAPALI", barX + barW / 2, ny + barH / 2);
}

void DisplayManager::drawSensors(const DisplayData &data) {
    if (_bgDraw) _tft.fillRoundRect(2, SNS_Y, SCR_W - 4, SNS_H, 4, COL_CARD);

    // DORT sutun: SHT40 | SHT30 | CO2 | UP
    // CO2 eskiden bu satirda yoktu; yalnizca Olcum sekmesinde kadran ve
    // Durum sekmesi alt seridinde deger olarak goruluyordu. Sensor durumunun
    // toplu okundugu yer burasi oldugu icin CO2 de yanlarina alindi.
    // Sutun genisligi 78 -> 59 px dustu; Font 1'de (~6 px/karakter) en uzun
    // icerik olan uptime "2s15d30s" 48 px eder, sigar.
    const int sw = (SCR_W - 4) / 4;
    _tft.setTextFont(1);
    _tft.setTextSize(1);
    _tft.setTextDatum(TC_DATUM);
    _tft.setTextPadding(0);

    int cx1 = 2 + sw / 2;
    _tft.setTextColor(COL_DIM, COL_CARD);
    _tft.drawString(SENSOR1_NAME, cx1, SNS_Y + 2);
    _tft.setTextColor(sensorStateColor(data.sensor1OK, data.sensor1Present), COL_CARD);
    _tft.drawString(sensorStateText(data.sensor1OK, data.sensor1Present), cx1, SNS_Y + 13);

    int cx2 = 2 + sw + sw / 2;
    _tft.setTextColor(COL_DIM, COL_CARD);
    _tft.drawString(SENSOR2_NAME, cx2, SNS_Y + 2);
    _tft.setTextColor(sensorStateColor(data.sensor2OK, data.sensor2Present), COL_CARD);
    _tft.drawString(sensorStateText(data.sensor2OK, data.sensor2Present), cx2, SNS_Y + 13);

    // CO2: ikili dil (OK/YOK). CO2Sensor "takili ama arizali" ayrimini
    // tutmadigi icin diger iki sensordeki uc durumlu dil kullanilamiyor.
    int cx3 = 2 + 2 * sw + sw / 2;
    _tft.setTextColor(COL_DIM, COL_CARD);
    _tft.drawString("CO2", cx3, SNS_Y + 2);
    _tft.setTextColor(data.co2Valid ? COL_GREEN : COL_DIM, COL_CARD);
    _tft.drawString(data.co2Valid ? "OK" : "YOK", cx3, SNS_Y + 13);

    int cx4 = 2 + 3 * sw + sw / 2;
    _tft.setTextColor(COL_DIM, COL_CARD);
    _tft.drawString("UP", cx4, SNS_Y + 2);
    unsigned long s = data.uptimeSec;
    char ut[16];
    snprintf(ut, sizeof(ut), "%lus%lud%lus", s / 3600, (s % 3600) / 60, s % 60);
    _tft.setTextColor(COL_TEXT, COL_CARD);
    _tft.setTextPadding(sw);
    _tft.drawString(ut, cx4, SNS_Y + 13);
    _tft.setTextPadding(0);
}

// ---------------------------------------------------------------------
//  Durum seridi (Durum sekmesi alti)
//
//  Buradaki uc bilgi daha once TFT'de HIC yoktu:
//    CO2       - yalnizca Olcum sekmesinde kadran olarak vardi
//    IR kaynak - yerel MLX90614 mi uzak WiFi yedegi mi, sadece web'de vardi
//    I/O       - role/MUX sagligi, sadece durum JSON'unda vardi
//  Ucu de gecerli/gecersiz ayrimini renk ile tasir; olcum yokken yesil
//  gostermek "her sey yolunda" izlenimi verecegi icin gri kullanilir.
// ---------------------------------------------------------------------
void DisplayManager::drawStatusStrip(const DisplayData &data) {
    if (_bgDraw) {
        _tft.fillRoundRect(2, STA_Y, SCR_W - 4, STA_H, 4, COL_CARD);
    }

    const int ty = STA_Y + STA_H / 2;
    _tft.setTextFont(1);
    _tft.setTextSize(1);
    _tft.setTextDatum(ML_DATUM);

    // ---- SOL: CO2 ----  "CO2 1250/3000"
    _tft.setTextColor(COL_DIM, COL_CARD);
    _tft.setTextPadding(0);
    _tft.drawString("CO2", 6, ty);

    char cbuf[10];
    if (data.co2Valid) snprintf(cbuf, sizeof(cbuf), "%u", (unsigned)data.co2);
    else               snprintf(cbuf, sizeof(cbuf), "--");
    _tft.setTextColor(co2StateColor(data.co2, data.co2Valid, data.co2Low,
                                    data.co2High, data.co2Critical), COL_CARD);
    _tft.setTextPadding(28);
    _tft.drawString(cbuf, 26, ty);

    // Limit kirmizi (Durum sekmesindeki diger hedeflerle ayni dil)
    char lbuf[10];
    snprintf(lbuf, sizeof(lbuf), "/%u", (unsigned)data.co2High);
    _tft.setTextColor(COL_RED, COL_CARD);
    _tft.setTextPadding(30);
    _tft.drawString(lbuf, 56, ty);

    // ---- ORTA: Yumurta IR + kaynak ----  "IR 37.6 Y"
    _tft.setTextColor(COL_DIM, COL_CARD);
    _tft.setTextPadding(0);
    _tft.drawString("IR", 100, ty);

    char ibuf[14];
    uint16_t irCol;
    if (!data.eggTempValid) {
        snprintf(ibuf, sizeof(ibuf), "--");
        irCol = COL_DIM;
    } else {
        // Y = yerel MLX90614 (birincil), U = uzak WiFi servisi (yedek).
        // Kaynak onemli: yedege dusulduyse olcum agdan geliyor demektir.
        char tag = (data.eggTempSource == 1) ? 'Y' : 'U';
        snprintf(ibuf, sizeof(ibuf), "%.1f %c", data.eggTemp, tag);
        irCol = (data.eggTempSource == 1) ? COL_GREEN : COL_CYAN;
    }
    _tft.setTextColor(irCol, COL_CARD);
    _tft.setTextPadding(48);
    _tft.drawString(ibuf, 116, ty);

    // ---- SAG: I/O sagligi ----
    _tft.setTextDatum(MR_DATUM);
    const char* ioTxt;
    uint16_t    ioCol;
    if (!data.muxOK) {
        ioTxt = "I/O MUX!";   ioCol = COL_RED;
    } else if (!data.relayOK) {
        ioTxt = "I/O ROLE!";  ioCol = COL_RED;
    } else if (data.muxRecoverCount > 0) {
        // Bus toparlandi ama sorun yasandi: sessizce gecmemeli
        ioTxt = "I/O ~";      ioCol = COL_ORANGE;
    } else {
        ioTxt = "I/O OK";     ioCol = COL_GREEN;
    }
    _tft.setTextColor(ioCol, COL_CARD);
    _tft.setTextPadding(60);
    _tft.drawString(ioTxt, SCR_W - 6, ty);

    _tft.setTextPadding(0);
    _tft.setTextDatum(TL_DATUM);
}

// ---------------------------------------------------------------------
//  Termal kacis banneri - tum sekmelerin ustunde
//
//  Sistem "kapattim" dedigi halde sicaklik dusmuyorsa role kontagi
//  yapismis olabilir. Yazilimin yapabilecegi bir sey kalmamistir; tek
//  cozum isitici beslemesini elle kesmektir. Bu yuzden mesaj hangi
//  sekmede olunursa olunsun gorunur.
// ---------------------------------------------------------------------
void DisplayManager::drawRunawayBanner(const DisplayData &data) {
    (void)data;
    bool blink = ((millis() / 400) % 2) == 0;
    uint16_t bg = blink ? COL_RED : 0x8000;   // kirmizi <-> koyu kirmizi

    const int bh = 16;
    _tft.fillRect(0, 0, SCR_W, bh, bg);
    _tft.drawFastHLine(0, bh, SCR_W, COL_RED);

    _tft.setTextFont(1);
    _tft.setTextSize(1);
    _tft.setTextDatum(MC_DATUM);
    _tft.setTextColor(COL_TEXT, bg);
    _tft.setTextPadding(0);
    _tft.drawString("!! ISITICI BESLEMESINI KES !!", SCR_W / 2, bh / 2);
    _tft.setTextDatum(TL_DATUM);
}

// ---------------------------------------------------------------------
//  Sistem kontrol onay modali
//
//  Neden onay: stop() NVS'deki kulucka durumunu siler, yani guc kesintisi
//  kurtarmasi kaybolur ve gun sayaci sifirlanir. Kumeste/ahirda dokunmatik
//  panele yanlislikla surtunmek 18 gunluk bir kulucka icin olumcul olurdu.
//  Bu yuzden DURUM karti dogrudan eylem yapmaz, once bu modali acar.
//
//  Modal SYSM_TIMEOUT_MS sonunda kendiliginden kapanir: kazara acilan bir
//  pencere panoyu suresiz kapatip olcumleri gizlemesin.
// ---------------------------------------------------------------------
void DisplayManager::drawSysControl(const DisplayData &data) {
    // Zemin
    _tft.fillRoundRect(SYSM_X, SYSM_Y, SYSM_W, SYSM_H, 8, COL_CARD);
    _tft.drawRoundRect(SYSM_X, SYSM_Y, SYSM_W, SYSM_H, 8, COL_CYAN);

    _tft.setTextSize(1);
    _tft.setTextDatum(MC_DATUM);
    _tft.setTextPadding(0);

    // Baslik (Font 2 - 14 karakter, Font 4'te 196 px olur ve 212'ye cok
    // yaklasirdi; basliktan cok DURUM buyuk olmali)
    _tft.setTextFont(2);
    _tft.setTextColor(COL_CYAN, COL_CARD);
    _tft.drawString("SISTEM KONTROL", SCR_W / 2, SYSM_Y + 16);

    // Mevcut durum - modaldeki EN ONEMLI bilgi, Font 4
    int si = constrain(data.systemState, 0, 6);
    _tft.setTextFont(4);
    _tft.setTextColor(ST_CLR[si], COL_CARD);
    _tft.drawString(ST_SHORT[si], SCR_W / 2, SYSM_Y + 50);

    // Gun bilgisi - Font 2 (eskiden Font 1 idi)
    _tft.setTextFont(2);
    _tft.setTextColor(COL_DIM, COL_CARD);
    char dbuf[24];
    snprintf(dbuf, sizeof(dbuf), "Gun %d/%d", data.currentDay, data.totalDays);
    _tft.drawString(dbuf, SCR_W / 2, SYSM_Y + 76);

    // Eylem butonlari
    SysAction acts[2];
    uint8_t n = sysActionsFor(si, acts);

    if (n == 1) {
        drawButton(SYSM_X + 4, SYSM_ACT_Y, SYSM_W - 8, SYSM_BTN_H,
                   acts[0].label, acts[0].color, COL_TEXT);
    } else {
        drawButton(SYSM_X + 4, SYSM_ACT_Y, SYSM_BTN_W2, SYSM_BTN_H,
                   acts[0].label, acts[0].color, COL_TEXT);
        drawButton(SYSM_X + 8 + SYSM_BTN_W2, SYSM_ACT_Y, SYSM_BTN_W2, SYSM_BTN_H,
                   acts[1].label, acts[1].color, COL_TEXT);
    }

    // Uyari metni - Font 2. Satirlar 26 karakteri ASMAMALI, yoksa 212 px'lik
    // ic genisligi tasar. Metinler bu sinira gore kisaltildi.
    _tft.setTextFont(2);
    _tft.setTextDatum(MC_DATUM);
    bool hasStop = (acts[0].act == TOUCH_STOP) || (n == 2 && acts[1].act == TOUCH_STOP);
    if (hasStop) {
        _tft.setTextColor(COL_RED, COL_CARD);
        _tft.drawString("DURDUR kaydi SILER,",        // 19 karakter
                        SCR_W / 2, SYSM_ACT_Y + SYSM_BTN_H + 14);
        _tft.drawString("kurtarma kaybolur.",         // 18 karakter
                        SCR_W / 2, SYSM_ACT_Y + SYSM_BTN_H + 32);
    } else {
        _tft.setTextColor(COL_DIM, COL_CARD);
        _tft.drawString("Isitici devreye girer.",     // 22 karakter
                        SCR_W / 2, SYSM_ACT_Y + SYSM_BTN_H + 22);
    }

    // Vazgec - en genis ve en kolay hedef (yanlislikla acildiysa cikis)
    drawButton(SYSM_X + 4, SYSM_CANCEL_Y, SYSM_W - 8, SYSM_BTN_H,
               "VAZGEC", 0x3186, COL_TEXT);

    _tft.setTextDatum(TL_DATUM);
}

#if RELAY_TEST_ENABLED
// ---------------------------------------------------------------------
//  ROLE TEST MODALI (GECICI - Config.h RELAY_TEST_ENABLED)
//
//  PCF8574 (MUX CH7) uzerindeki dort rolenin tek tek denenmesi. Fan
//  ROLEDE DEGIL: IO18 uzerinden 25 kHz PWM ile L298N surucuye gidiyor,
//  bu yuzden ayri bir buton olarak veriliyor.
//
//  Buton genisligi 108 px; etiketler Font 2'de en fazla ~12 karakter
//  olacak sekilde secildi.
// ---------------------------------------------------------------------
void DisplayManager::drawRelayTest(const DisplayData &data) {
    const int mx = 6, my = 24, mw = SCR_W - 12, mh = 236;   // 24..260
    const int bx = mx + 4, bw2 = (mw - 12) / 2;             // 108
    const int rx2 = bx + bw2 + 4;
    const int bh = 38;

    // TITREME ONLEME: zemin ve basliklar DEGISMEZ, yalnizca bir kez cizilir.
    // Eskiden her DISPLAY_UPDATE_MS'de (500 ms) tum modal fillRoundRect ile
    // siliniyordu; ekran surekli yanip sonuyordu.
    bool bgNeeded = (_bgDraw || !_relayTestDrawn);
    if (bgNeeded) {
        _tft.fillRoundRect(mx, my, mw, mh, 8, COL_CARD);
        _tft.drawRoundRect(mx, my, mw, mh, 8, COL_ORANGE);

        _tft.setTextSize(1);
        _tft.setTextDatum(MC_DATUM);
        _tft.setTextPadding(0);
        _tft.setTextFont(2);
        _tft.setTextColor(COL_ORANGE, COL_CARD);
        _tft.drawString("ROLE TESTI", SCR_W / 2, my + 14);
        _tft.setTextFont(1);
        _tft.setTextColor(COL_DIM, COL_CARD);
        _tft.drawString("PCF8574 - MUX CH7", SCR_W / 2, my + 30);
        _relayTestDrawn = true;
    }

    // Butonlar yalnizca DURUM DEGISINCE yeniden cizilir. Her karede
    // cizilseydi kucuk olcekli bir titreme kalmaya devam ederdi.
    // Isitici geri sayimi saniyede bir degistigi icin imzaya dahil edildi;
    // aksi halde sayac ekranda donuk kalirdi.
    uint8_t sig = (data.relayTestOn[0] ? 1 : 0) | (data.relayTestOn[1] ? 2 : 0)
                | (data.relayTestOn[2] ? 4 : 0) | (data.relayTestOn[3] ? 8 : 0)
                | (data.relayTestFan > 0 ? 16 : 0) | (data.relayOK ? 32 : 0);
    if (!bgNeeded && sig == _relayTestSig &&
        data.relayTestHeaterLeftSec == _relayTestHeaterLeft) return;
    _relayTestSig        = sig;
    _relayTestHeaterLeft = data.relayTestHeaterLeftSec;

    _tft.setTextSize(1);
    _tft.setTextDatum(MC_DATUM);
    _tft.setTextPadding(0);

    // Dort role - 2x2
    const int r1y = my + 42;
    const int r2y = r1y + bh + 4;
    drawButton(bx,  r1y, bw2, bh, "P0 ISITICI",
               data.relayTestOn[0] ? COL_RED : 0x3186, COL_TEXT);
    drawButton(rx2, r1y, bw2, bh, "P1 NEMLEND.",
               data.relayTestOn[1] ? COL_BLUE : 0x3186, COL_TEXT);
    drawButton(bx,  r2y, bw2, bh, "P2 CEV.GUC",
               data.relayTestOn[2] ? COL_GREEN : 0x3186, COL_TEXT);
    drawButton(rx2, r2y, bw2, bh, "P3 CEV.YON",
               data.relayTestOn[3] ? COL_PURPLE : 0x3186, COL_TEXT);

    // Fan - role degil. Iki sinyal birden: P7 (L298N IN1) + IO18 PWM (ENA).
    // Etikette ikisi de yazili ki test sirasinda hangi hattin denendigi belli olsun.
    const int fy = r2y + bh + 4;
    char fbuf[24];
    snprintf(fbuf, sizeof(fbuf), "FAN P7+PWM %u", (unsigned)data.relayTestFan);
    drawButton(bx, fy, mw - 8, bh, fbuf,
               data.relayTestFan > 0 ? COL_CYAN : 0x3186, COL_TEXT);

    // Durum satiri: role yazmasi gercekten geciyor mu + isitici geri sayimi.
    // Isitici sessizce kapansaydi kullanici "role bozuk" sanardi; kalan
    // sureyi gostermek bunun bilincli bir sinir oldugunu belli eder.
    _tft.setTextFont(1);
    _tft.setTextDatum(MC_DATUM);
    _tft.setTextPadding(210);
    if (data.relayTestHeaterLeftSec > 0) {
        char hbuf[40];
        snprintf(hbuf, sizeof(hbuf), "Isitici otomatik kapanma: %u sn",
                 (unsigned)data.relayTestHeaterLeftSec);
        _tft.setTextColor(COL_ORANGE, COL_CARD);
        _tft.drawString(hbuf, SCR_W / 2, fy + bh + 10);
    } else {
        _tft.setTextColor(data.relayOK ? COL_GREEN : COL_RED, COL_CARD);
        _tft.drawString(data.relayOK ? "Role karti: OK"
                                     : "Role karti: YAZILAMIYOR!",
                        SCR_W / 2, fy + bh + 10);
    }
    _tft.setTextPadding(0);

    // Cikis
    drawButton(bx, fy + bh + 20, mw - 8, 40, "TESTI BITIR", COL_ORANGE, COL_TEXT);
    _tft.setTextDatum(TL_DATUM);
}
#endif // RELAY_TEST_ENABLED

void DisplayManager::drawAlarm(const DisplayData &data) {
    if (_bgDraw) _tft.fillRoundRect(2, ALM_Y, SCR_W - 4, ALM_H, 4, COL_CARD);
    if (data.alarmActive) {
        _tft.drawRoundRect(2, ALM_Y, SCR_W - 4, ALM_H, 4, COL_RED);
    }
    _tft.setTextFont(2);
    _tft.setTextSize(1);
    _tft.setTextDatum(ML_DATUM);
    _tft.setTextPadding(SCR_W - 16);
    if (data.alarmActive && data.alarmMsg.length() > 0) {
        // Susturulmus alarm HALA TEHLIKEDIR. Sessiz bir sistemde "alarm yok"
        // ile "alarm var ama susturuldu" ayirt edilemezse kullanici tehlikeyi
        // gecmis sanir. Bu yuzden kirmizi cerceve korunur, metin turuncuya
        // doner ve sag ust kosede acik bir SESSIZ etiketi cikar.
        _tft.setTextColor(data.alarmMuted ? COL_ORANGE : COL_RED, COL_CARD);
        String txt = data.alarmMsg;
        // Susturuldugunda sag tarafta etikete yer acmak icin daha kisa kes
        uint8_t maxLen = data.alarmMuted ? 15 : 22;
        if (txt.length() > maxLen) txt = txt.substring(0, maxLen - 3) + "...";
        _tft.setTextPadding(data.alarmMuted ? (SCR_W - 70) : (SCR_W - 16));
        _tft.drawString(txt, 8, ALM_Y + 12);
        _tft.setTextPadding(0);

        if (data.alarmMuted) {
            _tft.setTextDatum(MR_DATUM);
            _tft.setTextColor(COL_ORANGE, COL_CARD);
            _tft.drawString("SESSIZ", SCR_W - 10, ALM_Y + 12);
            _tft.setTextDatum(ML_DATUM);
        }

        // Alt satir: dokunma ipucu / susturma durumu
        _tft.setTextFont(1);
        _tft.setTextColor(COL_DIM, COL_CARD);
        _tft.setTextPadding(SCR_W - 16);
        _tft.drawString(data.alarmMuted ? "Susturuldu - dokun: detay"
                                        : "Dokun: SUSTUR",
                        8, ALM_Y + ALM_H - 10);
        _tft.setTextFont(2);
    } else {
        _tft.setTextColor(COL_GREEN, COL_CARD);
        _tft.drawString("Alarm yok", 8, ALM_Y + ALM_H / 2);
    }
    _tft.setTextPadding(0);
}

// ==================== SAYFA: KONTROL ====================

void DisplayManager::drawControl(const DisplayData &data) {
    // Dropdown aciksa tam sayfa profil listesi goster
    if (_profileListOpen) {
        if (_bgDraw) drawProfileList();
        return;
    }
    // Editor acik ise tam sayfa profil duzenleme goster
    if (_profileEditorOpen) {
        drawProfileEditor(data);
        return;
    }

    const int cardMargin = 4;
    const int cardPadX = 8;
    const int cardW = SCR_W - cardMargin * 2;

    // ========== BASLIK KARTI ==========
    if (_bgDraw) {
        _tft.fillRoundRect(cardMargin, 2, cardW, 28, 6, COL_CARD);
        _tft.drawRoundRect(cardMargin, 2, cardW, 28, 6, 0x3186);
    }
    _tft.setTextFont(1);
    _tft.setTextSize(1);
    _tft.setTextDatum(TL_DATUM);
    _tft.setTextColor(COL_CYAN, COL_CARD);
    _tft.drawString("! SISTEM KONTROL", cardPadX + cardMargin, 10);

    // ========== KONTROL BUTONLARI (2x2) ==========
    {
        const int btnGap = 4;
        const int btnStartY = 34;
        const int btnH2 = 38;
        const int btnW2 = (cardW - btnGap) / 2;
        int lx = cardMargin;
        int rx = cardMargin + btnW2 + btnGap;

        int st = data.systemState;
        uint16_t cStart  = (st == 0 || st == 3 || st == 4 || st == 5) ? COL_GREEN : 0x2104;
        uint16_t cPause  = (st == 1 || st == 2) ? COL_ORANGE : 0x2104;
        uint16_t cResume = (st == 3) ? COL_CYAN : 0x2104;
        uint16_t cStop   = (st != 0) ? COL_RED : 0x2104;

        drawButton(lx, btnStartY, btnW2, btnH2, "BASLAT", cStart, COL_TEXT);
        drawButton(rx, btnStartY, btnW2, btnH2, "DURAKLAT", cPause, COL_TEXT);
        drawButton(lx, btnStartY + btnH2 + btnGap, btnW2, btnH2, "DEVAM", cResume, COL_TEXT);
        drawButton(rx, btnStartY + btnH2 + btnGap, btnW2, btnH2, "DURDUR", cStop, COL_TEXT);
    }

    // ========== PID PARAMETRELERI ==========
    int py = 122;
    const int pidH = 44;
    if (_bgDraw) {
        _tft.fillRoundRect(cardMargin, py, cardW, pidH, 6, COL_CARD);
        _tft.drawRoundRect(cardMargin, py, cardW, pidH, 6, 0x3186);
    }
    _tft.setTextFont(1);
    _tft.setTextDatum(TL_DATUM);
    _tft.setTextColor(COL_CYAN, COL_CARD);
    _tft.drawString("* PID", cardPadX + cardMargin, py + 6);

    _tft.setTextFont(2);
    _tft.setTextColor(COL_TEXT, COL_CARD);
    _tft.setTextDatum(TL_DATUM);
    
    // Kp
    _tft.setTextColor(COL_DIM, COL_CARD);
    _tft.drawString("Kp", cardPadX + cardMargin, py + 24);
    _tft.setTextColor(COL_TEXT, COL_CARD);
    char kpStr[10]; snprintf(kpStr, sizeof(kpStr), "%.1f", data.kp);
    _tft.drawString(kpStr, cardPadX + cardMargin + 22, py + 24);
    
    // Ki
    _tft.setTextColor(COL_DIM, COL_CARD);
    _tft.drawString("Ki", cardPadX + cardMargin + 70, py + 24);
    _tft.setTextColor(COL_TEXT, COL_CARD);
    char kiStr[10]; snprintf(kiStr, sizeof(kiStr), "%.2f", data.ki);
    _tft.drawString(kiStr, cardPadX + cardMargin + 88, py + 24);
    
    // Kd
    _tft.setTextColor(COL_DIM, COL_CARD);
    _tft.drawString("Kd", cardPadX + cardMargin + 145, py + 24);
    _tft.setTextColor(COL_TEXT, COL_CARD);
    char kdStr[10]; snprintf(kdStr, sizeof(kdStr), "%.1f", data.kd);
    _tft.drawString(kdStr, cardPadX + cardMargin + 165, py + 24);

    // ========== MANUEL CIKIS KONTROLU ==========
    // Buradaki eski "NEM ESIKLERI" karti kaldirildi: salt gosterimdi (dokunma
    // isleyicisi yoktu) ve ayni bilgi Durum sekmesinde nem kartinda
    // ("%55 - %65") ve Olcum sekmesinde yesil bant + HEDEFTE satiri olarak
    // zaten iki kez gosteriliyordu. Acilan 44 px manuel kontrole verildi.
    int ny = py + pidH + 4;
    const int nemH = 44;
    if (_bgDraw) {
        _tft.fillRoundRect(cardMargin, ny, cardW, nemH, 6, COL_CARD);
        _tft.drawRoundRect(cardMargin, ny, cardW, nemH, 6,
                           data.cleaningActive ? COL_ORANGE : 0x3186);
    }
    _tft.setTextFont(1);
    _tft.setTextDatum(TL_DATUM);
    _tft.setTextColor(data.cleaningActive ? COL_ORANGE : COL_CYAN, COL_CARD);
    _tft.setTextPadding(150);
    _tft.drawString(data.cleaningActive ? "* MANUEL MOD AKTIF" : "* MANUEL KONTROL",
                    cardPadX + cardMargin, ny + 5);
    _tft.setTextPadding(0);

    // Iki toggle: ISITICI | NEMLENDIRICI
    // Manuel mod aktif degilse dokunmak once o moda gecirir; PID ile elle
    // kontrolun ayni anda isiticiya komut vermesi kabul edilemez.
    {
        const int mBtnY = ny + 17;
        const int mBtnH = 22;
#if RELAY_TEST_ENABLED
        // TEK GIRIS NOKTASI.
        // Onceden burada ISITICI ve NEM toggle'lari da vardi; onlar temizlik
        // modu uzerinden calisiyordu, role testi ise otomatik kontrolu
        // tamamen askiya alan AYRI bir yol. Iki farkli manuel mekanizmayi
        // yan yana koymak hangi durumda olundugunu belirsizlestiriyor ve
        // kazara yanlis moda girme riski yaratiyordu. Role testi zaten
        // isitici (P0) ve nemlendiriciyi (P1) de kapsiyor.
        drawButton(cardMargin, mBtnY, cardW, mBtnH,
                   "ROLE / CIKIS TESTI", COL_ORANGE, COL_TEXT);
#else
        // Test derlemeden cikarildiginda kart bos kalmasin
        _tft.setTextFont(1);
        _tft.setTextDatum(MC_DATUM);
        _tft.setTextColor(COL_DIM, COL_CARD);
        _tft.drawString("Manuel kontrol web arayuzunde",
                        SCR_W / 2, mBtnY + mBtnH / 2);
        _tft.setTextDatum(TL_DATUM);
#endif
    }

    // ========== ALT SATIR: PROFIL SEC + PROFIL DUZENLE ==========
    int cy = ny + nemH + 4;
    const int bottomH = 28;
    const int halfW = (cardW - 4) / 2;

    // Profil Sec butonu (sol)
    if (_bgDraw) _tft.fillRoundRect(cardMargin, cy, halfW, bottomH, 6, COL_BLUE);
    _tft.setTextFont(2);
    _tft.setTextDatum(MC_DATUM);
    _tft.setTextColor(COL_TEXT, COL_BLUE);
    _tft.setTextPadding(halfW - 8);
    char profBtn[24];
    // Override varsa profil adi yanina "*" ekle (rozet)
    bool hasOverride = _customProfileStorage &&
                       _customProfileStorage->hasProfileOverride(
                           (uint8_t)_pendingProfileIdx);
    snprintf(profBtn, sizeof(profBtn), "%s%s v",
             data.profileName ? data.profileName : "Sec",
             hasOverride ? " *" : "");
    _tft.drawString(profBtn, cardMargin + halfW / 2, cy + bottomH / 2);
    _tft.setTextPadding(0);

    // Profili Duzenle butonu (sag) — turuncu, vurgu icin
    int px = cardMargin + halfW + 4;
    if (_bgDraw) _tft.fillRoundRect(px, cy, halfW, bottomH, 6, COL_ORANGE);
    _tft.setTextFont(2);
    _tft.setTextDatum(MC_DATUM);
    _tft.setTextColor(COL_TEXT, COL_ORANGE);
    _tft.setTextPadding(halfW - 8);
    _tft.drawString("Profili Duzenle", px + halfW / 2, cy + bottomH / 2);
    _tft.setTextPadding(0);

    // ========== ALT SATIR: CEVIRME DURUMU (sol) + TEMIZLIK BTN (sag) ==========
    int ty = cy + bottomH + 4;     // 250
    const int turnH = 28;
    const int halfW2 = (cardW - 4) / 2;

    // -- Sol: Cevirme durumu --
    if (_bgDraw) {
        _tft.fillRoundRect(cardMargin, ty, halfW2, turnH, 6, COL_CARD);
        _tft.drawRoundRect(cardMargin, ty, halfW2, turnH, 6, 0x3186);
    }
    _tft.setTextFont(1);
    _tft.setTextDatum(ML_DATUM);
    _tft.setTextColor(COL_DIM, COL_CARD);
    _tft.drawString("Cevirme:", cardPadX + cardMargin, ty + turnH / 2);
    _tft.setTextDatum(MR_DATUM);
    _tft.setTextFont(2);
    _tft.setTextColor(data.turningEnabled ? COL_GREEN : COL_RED, COL_CARD);
    _tft.setTextPadding(40);
    _tft.drawString(data.turningEnabled ? "ON" : "OFF",
                    cardMargin + halfW2 - 8, ty + turnH / 2);
    _tft.setTextPadding(0);

    // -- Sag: Temizlik (Bakim) butonu --
    // Aktifken kirmizi "DURDUR", pasifken yesil "TEMIZLIK"
    int clnX = cardMargin + halfW2 + 4;
    uint16_t clnBg = data.cleaningActive ? COL_RED : COL_GREEN;
    // Buton arkaplani her cizimde guncellensin (aktif/pasif rengi degistigi icin)
    _tft.fillRoundRect(clnX, ty, halfW2, turnH, 6, clnBg);
    _tft.drawRoundRect(clnX, ty, halfW2, turnH, 6, 0x3186);
    _tft.setTextFont(2);
    _tft.setTextDatum(MC_DATUM);
    _tft.setTextColor(COL_TEXT, clnBg);
    _tft.setTextPadding(halfW2 - 8);
    if (data.cleaningActive) {
        // Kalan dakika
        unsigned long mins = (data.cleaningRemainMs + 59999UL) / 60000UL;
        char lbl[16];
        snprintf(lbl, sizeof(lbl), "DURDUR %lud", mins);
        _tft.drawString(lbl, clnX + halfW2 / 2, ty + turnH / 2);
    } else {
        _tft.drawString("TEMIZLIK", clnX + halfW2 / 2, ty + turnH / 2);
    }
    _tft.setTextPadding(0);
    _tft.setTextDatum(TL_DATUM);
}

// ==================== SAYFA: PROFIL ====================

void DisplayManager::drawProfile(const DisplayData &data) {
    const int cardMargin = 4;
    const int cardPadX = 6;
    const int cardW = SCR_W - cardMargin * 2;
    
    // ========== BASLIK KARTI ==========
    const int hdrH = 62;
    if (_bgDraw) {
        _tft.fillRoundRect(cardMargin, 2, cardW, hdrH, 6, COL_CARD);
        _tft.drawRoundRect(cardMargin, 2, cardW, hdrH, 6, 0x3186);
    }

    // BASLIK YERLESIMI - her eleman kendi satir bandinda.
    // Eski duzende profil adi (Font 4, y 20..46, sol) ile evre adi
    // (Font 2, y 24..40, saga hizali) AYNI bantta idi. Uzun kombinasyonlarda
    // ("Ipek Bocegi" + "Erken Gelisim") yatayda cakisip ust uste biniyordu.
    // Yeni duzen (Font 2 = 16 px, Font 4 = 26 px):
    //   satir 1  y  2..18 : PROFIL (sol)      | Gun x/y (sag)
    //   satir 2  y 19..45 : profil adi (Font 4, TAM GENISLIK, komsusu yok)
    //   satir 3  y 46..62 : evre adi (sol)    | CO2 limitleri (sag, Font 1)
    const int lx0 = cardPadX + cardMargin;              // sol icerik kenari  = 10
    const int rx0 = SCR_W - cardMargin - cardPadX;      // sag icerik kenari  = 230

    // --- Satir 1 ---
    _tft.setTextFont(2);
    _tft.setTextSize(1);
    _tft.setTextDatum(TL_DATUM);
    _tft.setTextColor(COL_CYAN, COL_CARD);
    _tft.drawString("PROFIL", lx0, 2);

    _tft.setTextDatum(TR_DATUM);
    _tft.setTextColor(COL_ORANGE, COL_CARD);
    char dayInfo[20];
    snprintf(dayInfo, sizeof(dayInfo), "Gun %d/%d", data.currentDay, data.totalDays);
    _tft.setTextPadding(90);
    _tft.drawString(dayInfo, rx0, 2);
    _tft.setTextPadding(0);

    // --- Satir 2: profil adi, satirin tamami onun ---
    const char* pn = data.profileName ? data.profileName : "---";
    _tft.setTextFont(4);
    _tft.setTextDatum(TL_DATUM);
    _tft.setTextColor(COL_TEXT, COL_CARD);
    _tft.setTextPadding(cardW - cardPadX * 2);
    _tft.drawString(pn, lx0, 19);
    _tft.setTextPadding(0);

    // --- Satir 3 sol: aktif evre ---
    // 12 karakterle sinirli: Font 2'de ~96 px eder, x 10..106 arasinda kalir
    // ve sagdaki CO2 grubuna (128'den baslar) hicbir kosulda degmez.
    char phBuf[16];
    const char* phSrc = data.phaseName ? data.phaseName : "---";
    snprintf(phBuf, sizeof(phBuf), "%.12s", phSrc);
    _tft.setTextFont(2);
    _tft.setTextColor(COL_GREEN, COL_CARD);
    _tft.setTextPadding(104);
    _tft.drawString(phBuf, lx0, 46);
    _tft.setTextPadding(0);

    // --- Satir 3 sag: CO2 limitleri (Font 1, sagdan sola yerlesim) ---
    // Renkler siddeti tasir: yesil = normal ust siniri, sari = yuksek,
    // kirmizi = kritik. Font 1 (8 px) kullanildi ki Font 2'lik evre adiyla
    // ayni satirda rahat sigsin.
    _tft.setTextFont(1);
    _tft.setTextDatum(TR_DATUM);
    char co2Str[12];
    _tft.setTextColor(COL_RED, COL_CARD);
    snprintf(co2Str, sizeof(co2Str), "%u", data.co2Critical);
    _tft.setTextPadding(30);
    _tft.drawString(co2Str, rx0, 50);
    _tft.setTextColor(COL_YELLOW, COL_CARD);
    snprintf(co2Str, sizeof(co2Str), "%u", data.co2High);
    _tft.drawString(co2Str, rx0 - 32, 50);
    _tft.setTextColor(COL_GREEN, COL_CARD);
    snprintf(co2Str, sizeof(co2Str), "%u", data.co2Low);
    _tft.drawString(co2Str, rx0 - 64, 50);
    _tft.setTextColor(COL_DIM, COL_CARD);
    _tft.setTextPadding(0);
    _tft.drawString("CO2", rx0 - 96, 50);
    _tft.setTextFont(2);
    _tft.setTextDatum(TL_DATUM);

    // Evre listesi
    const AnimalProfile* prof = data.profile;
    if (!prof) {
        _tft.setTextFont(2);
        _tft.setTextDatum(MC_DATUM);
        _tft.setTextColor(COL_DIM, COL_BG);
        _tft.drawString("Profil bulunamadi", SCR_W / 2, 120);
        return;
    }

    // ========== EVRE KARTLARI ==========
    // Faz sayisina gore kart yuksekligi dinamik (4 faz icin kompakt)
    int totalCards = prof->phaseCount;

    // YERLESIM HESABI - uc satir da Font 2 kullanir, Font 2 yuksekligi 16 px.
    // Uc satir icin en az 48 px gerekir; eski degerler bunu saglamiyordu ve
    // yazilar ust uste biniyordu:
    //   kompakt: kart 44 px, satirlar +3/+18/+30
    //            -> satir2 satir1'e 1 px, satir3 satir2'ye 4 px biniyordu,
    //               ustelik satir3 (30+16=46) 44 px'lik karti tasiyordu.
    //   normal : kart 56 px, satirlar +4/+26/+40
    //            -> satir3 satir2'ye 2 px biniyordu.
    //
    // Kompakt kart 44 -> 52 px yapildi. Gorunur kart sayisi DEGISMEDI:
    //   maxVisible = (290 - 68) / (52 + 2) = 4   (eskiden 222/46 = 4)
    const int phH = (totalCards >= 4) ? 52 : 56;
    const int gap = (totalCards >= 4) ? 2  : 3;
    // Satir baslangiclari: her satir 16 px, aralarinda 1-3 px nefes payi
    const int phRow1Y = (totalCards >= 4) ? 2  : 4;    // Baslik + gun araligi
    const int phRow2Y = (totalCards >= 4) ? 19 : 23;   // Sicaklik + nem
    const int phRow3Y = (totalCards >= 4) ? 35 : 40;   // Cevirme + sogutma

    int startY = hdrH + 6;

    // Dol kontrolu karti icin alt rezerv.
    // Dikey butce dar: 290 px sayfada baslik 68'e kadar gidiyor. Kart
    // yuksekligi 44 -> 52 cikinca 4 kart + dol karti artik sigmiyordu ve
    // dol karti "candY + cardH < PAGE_H" korumasina takilip HIC cizilmiyordu.
    // Bilgi kaybetmemek icin gorunur kart sayisini bir azaltiyoruz; kalan
    // fazlara zaten kaydirma ile ulasiliyor.
    const int candReserve = (data.candlingLockdownDay > 0 && totalCards >= 4) ? 36 : 0;

    int maxVisible = (PAGE_H - startY - candReserve) / (phH + gap);
    if (maxVisible < 1) maxVisible = 1;

    int maxScroll = totalCards - maxVisible;
    if (maxScroll < 0) maxScroll = 0;
    if (_scrollOffset > maxScroll) _scrollOffset = maxScroll;

    for (uint8_t idx = 0; idx < maxVisible && (idx + _scrollOffset) < totalCards; idx++) {
        uint8_t i = idx + _scrollOffset;
        const IncubationPhase &ph = prof->phases[i];
        if (ph.startDay == 0 && ph.endDay == 0) continue;

        int cy = startY + idx * (phH + gap);
        if (cy + phH > PAGE_H) break;

        // ---- Evrenin ZAMAN DURUMU ----
        // Eskiden yalnizca "aktif" evre ayrisiyordu; TAMAMLANAN ile HENUZ
        // GELINMEYEN evreler birbirinin ayni gorunuyordu. Kulucka kac gundur
        // suruyor, hangi evreler geride kaldi - bunlar bir bakista okunmaliydi.
        bool started  = (data.currentDay > 0);
        bool isActive = (i == data.currentPhaseIndex);
        bool isDone   = (started && !isActive && data.currentDay > ph.endDay);
        // ucuncu durum (bekleyen) = !isActive && !isDone

        // Her durumun KENDI CERCEVESI var:
        //   aktif      : yesil cerceve + koyu yesil zemin
        //   tamamlandi : gri cerceve  + soluk icerik (geride kaldi)
        //   bekliyor   : mor kenar cubugu, cerceve yok (one cikmasin)
        uint16_t cardBg = isActive ? 0x0A2A : COL_CARD;
        uint16_t accent = isActive ? COL_GREEN : (isDone ? COL_DIM : COL_PURPLE);
        // Tamamlanan evrede metinler soluklastirilir
        uint16_t bodyCol  = isDone ? COL_DIM : COL_TEXT;
        uint16_t labelCol = COL_DIM;
        uint16_t dayCol   = isDone ? COL_DIM : COL_ORANGE;

        if (_bgDraw) {
            _tft.fillRoundRect(cardMargin, cy, cardW, phH, 5, cardBg);
            _tft.fillRoundRect(cardMargin, cy + 2, 5, phH - 4, 2, accent);
            if (isActive) {
                _tft.drawRoundRect(cardMargin, cy, cardW, phH, 5, COL_GREEN);
            } else if (isDone) {
                _tft.drawRoundRect(cardMargin, cy, cardW, phH, 5, COL_DIM);
            }
        }

        // Evre adi (sol ust) - Font 2
        _tft.setTextFont(2);
        _tft.setTextDatum(TL_DATUM);
        _tft.setTextColor(isActive ? COL_GREEN : bodyCol, cardBg);
        _tft.setTextPadding(100);
        _tft.drawString(ph.phaseName, cardPadX + cardMargin + 8, cy + phRow1Y);
        _tft.setTextPadding(0);

        // Gun araligi (sag ust) - Font 2. Tamamlanan evrede "OK" ekiyle
        // gosterilir: cerceve rengi disinda ikinci bir isaret olur.
        _tft.setTextDatum(TR_DATUM);
        _tft.setTextColor(dayCol, cardBg);
        char dayRange[20];
        snprintf(dayRange, sizeof(dayRange), "%sGun %d-%d",
                 isDone ? "OK " : "", ph.startDay, ph.endDay);
        _tft.setTextPadding(88);
        _tft.drawString(dayRange, SCR_W - cardMargin - cardPadX, cy + phRow1Y);
        _tft.setTextPadding(0);
        _tft.setTextDatum(TL_DATUM);

        // Sicaklik (sol alt) - Font 2
        _tft.setTextColor(labelCol, cardBg);
        _tft.drawString("Sic:", cardPadX + cardMargin + 8, cy + phRow2Y);
        _tft.setTextColor(bodyCol, cardBg);
        char tempStr[20];
        if (ph.tempEnd > 0.0f && ph.tempEnd != ph.temperature) {
            snprintf(tempStr, sizeof(tempStr), "%.1f>%.1f", ph.temperature, ph.tempEnd);
        } else {
            snprintf(tempStr, sizeof(tempStr), "%.1fC", ph.temperature);
        }
        _tft.drawString(tempStr, cardPadX + cardMargin + 38, cy + phRow2Y);

        // Nem (sag orta) - Font 2
        _tft.setTextDatum(TR_DATUM);
        _tft.setTextColor(COL_DIM, cardBg);
        char humStr[20];
        snprintf(humStr, sizeof(humStr), "Nem: %%%d-%%%d", (int)ph.humidityLow, (int)ph.humidityHigh);
        _tft.setTextColor(isDone ? COL_DIM : COL_CYAN, cardBg);
        _tft.drawString(humStr, SCR_W - cardMargin - cardPadX, cy + phRow2Y);
        _tft.setTextDatum(TL_DATUM);

        // Cevirme (sol alt) - Font 2
        _tft.setTextColor(isDone ? COL_DIM
                                 : (ph.turningEnabled ? COL_GREEN : COL_RED), cardBg);
        _tft.drawString(ph.turningEnabled ? "Cevirme: ACIK" : "Cevirme: KAPALI",
                         cardPadX + cardMargin + 8, cy + phRow3Y);

        // Cooling/Sprey indikatoru (sag alt) - 4 fazli kompakt modda
        if (totalCards >= 4 && (ph.coolingEnabled || ph.sprayingEnabled)) {
            _tft.setTextDatum(TR_DATUM);
            _tft.setTextColor(isDone ? COL_DIM : COL_PURPLE, cardBg);
            const char* coolSym = ph.sprayingEnabled ? "* Sogut+Sprey" : "* Sogutma";
            _tft.drawString(coolSym, SCR_W - cardMargin - cardPadX, cy + phRow3Y);
            _tft.setTextDatum(TL_DATUM);
        }
    }

    // Scroll gostergesi - BASLIK KARTININ 1. SATIRINDA.
    // Eskiden sayfanin en altinda (PAGE_H-12, yani y 270..286) ciziliyordu.
    // Kart yuksekligi 52 px'e cikinca 4. kart 282'ye kadar uzuyor ve gosterge
    // onun uzerine biniyordu. Baslik satirinda "PROFIL" (x 10..58) ile
    // "Gun x/y" (x ~158..230) arasi bostur; gosterge oraya alindi.
    // handleTouch sinir kontrolu icin son degeri paylas
    _profMaxScroll = maxScroll;

    if (maxScroll > 0) {
        // Baslikta sayfa gostergesi. Yukari cikilabiliyorsa "^" ile birlikte
        // yazilir ve baslik kartinin tamami "yukari" dokunma alanidir.
        _tft.setTextFont(1);
        _tft.setTextDatum(MC_DATUM);
        _tft.setTextColor(_scrollOffset > 0 ? COL_CYAN : COL_DIM, COL_CARD);
        _tft.setTextPadding(46);
        char sc[16];
        snprintf(sc, sizeof(sc), "%s%d/%d",
                 (_scrollOffset > 0) ? "^ " : "", _scrollOffset + 1, maxScroll + 1);
        _tft.drawString(sc, 108, 10);
        _tft.setTextPadding(0);

        // Alt serit: asagi kaydirma. Gorunur olmasi sart - eskiden kaydirma
        // tamamen gizli dokunma bolgeleriyle yapiliyordu ve kullanici
        // "1/2" yazisini gorup nasil gecilecegini bilemiyordu.
        const int by = PROF_SCROLL_DN_MINY;
        const int bh = 20;
        bool canDown = (_scrollOffset < maxScroll);
        _tft.fillRoundRect(cardMargin, by, cardW, bh, 5,
                           canDown ? 0x18E3 : COL_BG);
        _tft.setTextDatum(MC_DATUM);
        _tft.setTextFont(2);
        _tft.setTextColor(canDown ? COL_CYAN : COL_DIM, canDown ? 0x18E3 : COL_BG);
        _tft.setTextPadding(cardW - 8);
        _tft.drawString(canDown ? "v  ASAGI  v" : "- liste sonu -",
                        SCR_W / 2, by + bh / 2);
        _tft.setTextPadding(0);

        _tft.setTextFont(2);
        _tft.setTextDatum(TL_DATUM);
    }

    // ========== DOL KONTROLU (CANDLING) KARTI ==========
    // Evre kartlarinin altinda kontrol gunlerini goster
    // 4 fazli profilde KOMPAKT mod (~32px tek satir), 2-3 fazli profilde detayli liste
    if (data.candlingLockdownDay > 0) {
        CandlingSchedule cs;
        buildCandlingSchedule(prof, cs);

        bool compactMode = (totalCards >= 4);

        int candY = startY + (min((int)prof->phaseCount, maxVisible)) * (phH + gap) + 2;
        int cardH = compactMode ? 32 : (20 + (cs.checkCount * 12) + 8);

        if (candY + cardH < PAGE_H) {
            // Bugun kontrol gunu mu? (vurgu icin)
            bool todayIsCheck = false;
            int  todayCheckIdx = -1;
            for (int k = 0; k < cs.checkCount; k++) {
                if (cs.checkDays[k] == data.currentDay) {
                    todayIsCheck = true;
                    todayCheckIdx = k;
                    break;
                }
            }

            // Kart arka plan (bugun kontrol ise vurgulu)
            uint16_t cardColor = todayIsCheck ? 0x4A20 : COL_CARD;   // koyu turuncu / kart
            if (_bgDraw) {
                _tft.fillRoundRect(cardMargin, candY, cardW, cardH, 5, cardColor);
                _tft.fillRoundRect(cardMargin, candY + 2, 5, cardH - 4, 2, COL_YELLOW);
                _tft.drawRoundRect(cardMargin, candY, cardW, cardH, 5, 0x8482);
            }

            if (compactMode) {
                // KOMPAKT MOD (4 fazli profil): tek satir kart + gunler
                // Format: "Dol: G5 G10 G15 L18 [BUGUN!]" — sigistirilmis
                _tft.setTextFont(2);
                _tft.setTextDatum(TL_DATUM);
                _tft.setTextColor(COL_YELLOW, cardColor);
                _tft.drawString("Dol:", cardPadX + cardMargin + 8, candY + 4);

                // Gunler yan yana
                _tft.setTextFont(1);
                int gx = cardPadX + cardMargin + 36;
                for (int k = 0; k < cs.checkCount; k++) {
                    int controlDay = cs.checkDays[k];
                    bool isToday = (data.currentDay == controlDay);
                    bool isPast  = (data.currentDay > controlDay);

                    if (isToday) {
                        _tft.setTextColor(COL_YELLOW, cardColor);
                    } else if (isPast) {
                        _tft.setTextColor(0x3A5A, cardColor);
                    } else {
                        _tft.setTextColor(COL_CYAN, cardColor);
                    }

                    char buf[8];
                    // Son entry lockdown ise "L" prefix, digerleri "G"
                    if (k == cs.checkCount - 1) {
                        snprintf(buf, sizeof(buf), "L%u", controlDay);
                    } else {
                        snprintf(buf, sizeof(buf), "G%u", controlDay);
                    }
                    _tft.drawString(buf, gx, candY + 6);
                    gx += (controlDay >= 10 ? 24 : 20);
                }

                // Alt satir: bugunse "BUGUN!" yanip soner, degilse en yakin kalan gun
                _tft.setTextFont(1);
                if (todayIsCheck) {
                    bool blink = ((millis() / 500) % 2) == 0;
                    if (blink) {
                        _tft.setTextDatum(MR_DATUM);
                        _tft.setTextColor(COL_YELLOW, cardColor);
                        _tft.drawString("* BUGUN KONTROL ZAMANI! *",
                                       SCR_W - cardMargin - cardPadX - 4, candY + 22);
                        _tft.setTextDatum(TL_DATUM);
                    }
                } else {
                    // En yakin gelecek kontrol gunu
                    int nextDay = 0;
                    for (int k = 0; k < cs.checkCount; k++) {
                        if (cs.checkDays[k] > data.currentDay) {
                            nextDay = cs.checkDays[k];
                            break;
                        }
                    }
                    if (nextDay > 0) {
                        char nbuf[32];
                        snprintf(nbuf, sizeof(nbuf), "Sonraki: Gun %d (%d gun)",
                                 nextDay, nextDay - data.currentDay);
                        _tft.setTextDatum(MR_DATUM);
                        _tft.setTextColor(COL_DIM, cardColor);
                        _tft.drawString(nbuf, SCR_W - cardMargin - cardPadX - 4, candY + 22);
                        _tft.setTextDatum(TL_DATUM);
                    }
                }
            } else {
                // DETAYLI MOD (2-3 fazli profil): dikey liste eski tasarim
                _tft.setTextFont(2);
                _tft.setTextDatum(TL_DATUM);
                _tft.setTextColor(COL_YELLOW, cardColor);
                _tft.drawString("Dol Kontrolu", cardPadX + cardMargin + 8, candY + 3);

                _tft.setTextFont(1);
                _tft.setTextSize(1);
                int cy = candY + 18;

                bool startDateValid = (data.startYear >= 2020 && data.startYear <= 2099 &&
                                       data.startMonth >= 1 && data.startMonth <= 12 &&
                                       data.startDay >= 1 && data.startDay <= 31);
                DateTime startDt(data.startYear, data.startMonth, data.startDay);

                for (int k = 0; k < cs.checkCount; k++) {
                    int controlDay = cs.checkDays[k];
                    bool isToday = (data.currentDay == controlDay);
                    bool isPast  = (data.currentDay > controlDay);
                    int daysRemaining = controlDay - data.currentDay;

                    if (isToday)      _tft.setTextColor(COL_YELLOW, cardColor);
                    else if (isPast)  _tft.setTextColor(0x3A5A, cardColor);
                    else              _tft.setTextColor(COL_CYAN, cardColor);

                    char labelBuf[48];
                    if (startDateValid) {
                        DateTime checkDt = startDt + TimeSpan(controlDay - 1, 0, 0, 0);
                        if (k < 3) {
                            snprintf(labelBuf, sizeof(labelBuf), "%d.Kontrol: %02d.%02d.%04d",
                                     k + 1, checkDt.day(), checkDt.month(), checkDt.year());
                        } else {
                            snprintf(labelBuf, sizeof(labelBuf), "Lockdown: %02d.%02d.%04d",
                                     checkDt.day(), checkDt.month(), checkDt.year());
                        }
                    } else {
                        if (k < 3) {
                            snprintf(labelBuf, sizeof(labelBuf), "%d.Kontrol: Gun %d",
                                     k + 1, controlDay);
                        } else {
                            snprintf(labelBuf, sizeof(labelBuf), "Lockdown: Gun %d", controlDay);
                        }
                    }
                    _tft.setTextDatum(TL_DATUM);
                    _tft.drawString(labelBuf, cardPadX + cardMargin + 8, cy);

                    char dayBuf[24];
                    if (daysRemaining == 0)       snprintf(dayBuf, sizeof(dayBuf), "BUGUN!");
                    else if (daysRemaining > 0)   snprintf(dayBuf, sizeof(dayBuf), "%d gun kaldi", daysRemaining);
                    else                           snprintf(dayBuf, sizeof(dayBuf), "%d gun gecti", -daysRemaining);
                    _tft.setTextColor(COL_DIM, cardColor);
                    _tft.setTextDatum(TR_DATUM);
                    _tft.drawString(dayBuf, SCR_W - cardMargin - cardPadX - 2, cy);
                    _tft.setTextDatum(TL_DATUM);

                    cy += 12;
                }
            }

            // Font sifirla
            _tft.setTextFont(2);
            _tft.setTextSize(1);
        }
    }
}

// ==================== PROFIL DROPDOWN LISTESI ====================

void DisplayManager::drawProfileList() {
    const int itemH  = 36;       // Dokunma alani (touch handler ile ayni!)
    const int hdrH   = 40;       // Ust baslik yuksekligi
    const int ftrH   = 40;       // Alt buton yuksekligi
    const int listY  = hdrH;

    int maxVisible = (SCR_H - hdrH - ftrH) / itemH;  // (320-40-40)/36 = 6
    if (maxVisible > PROFILE_COUNT) maxVisible = PROFILE_COUNT;
    int maxScroll = PROFILE_COUNT - maxVisible;
    if (maxScroll < 0) maxScroll = 0;
    if (_scrollOffset > maxScroll) _scrollOffset = maxScroll;

    int listEndY = listY + maxVisible * itemH;

    // ---- Ust baslik + yukari ok ----
    _tft.fillRect(0, 0, SCR_W, hdrH, COL_CARD);
    _tft.setTextFont(2);
    _tft.setTextSize(1);
    _tft.setTextDatum(MC_DATUM);
    _tft.setTextColor(COL_BLUE, COL_CARD);
    _tft.setTextPadding(0);
    _tft.drawString("PROFIL SEC", SCR_W / 2, 10);

    if (_scrollOffset > 0) {
        _tft.setTextFont(2);
        _tft.setTextColor(COL_CYAN, COL_CARD);
        _tft.drawString("^  YUKARI  ^", SCR_W / 2, 28);
    } else {
        _tft.setTextFont(1);
        _tft.setTextColor(COL_DIM, COL_CARD);
        char info[20];
        snprintf(info, sizeof(info), "%d - %d / %d", _scrollOffset + 1,
                 _scrollOffset + maxVisible, PROFILE_COUNT);
        _tft.drawString(info, SCR_W / 2, 30);
    }
    _tft.drawFastHLine(0, hdrH - 2, SCR_W, COL_DIM);

    // ---- Profil listesi ----
    for (int idx = 0; idx < maxVisible; idx++) {
        int i = idx + _scrollOffset;
        if (i >= PROFILE_COUNT) break;

        int iy = listY + idx * itemH;
        // Alfabetik sirala, ama gercek index korunsun
        uint8_t realIdx = profileRealIdx(i);
        const AnimalProfile* p = ALL_PROFILES[realIdx];

        // Override durumu (kullanici bu profili duzenlemis mi?)
        bool isOverride = _customProfileStorage &&
                          _customProfileStorage->hasProfileOverride(realIdx);

        // Satir arkaplan (alternating)
        uint16_t rowBg = (idx % 2 == 0) ? COL_CARD : COL_BG;
        _tft.fillRect(0, iy, SCR_W, itemH, rowBg);

        // Sol kenar renk gostergesi
        uint16_t accent = (idx % 3 == 0) ? COL_GREEN : (idx % 3 == 1) ? COL_BLUE : COL_ORANGE;
        _tft.fillRect(0, iy + 2, 4, itemH - 4, accent);

        // Ayirici cizgi (altta)
        _tft.drawFastHLine(4, iy + itemH - 1, SCR_W - 4, COL_BAR_BG);

        // Profil adi (sol) — override varsa "*" ekle
        _tft.setTextFont(2);
        _tft.setTextSize(1);
        _tft.setTextDatum(ML_DATUM);
        _tft.setTextColor(COL_TEXT, rowBg);
        _tft.setTextPadding(0);
        char nameBuf[36];
        if (isOverride) {
            snprintf(nameBuf, sizeof(nameBuf), "%s *", p->name);
        } else {
            snprintf(nameBuf, sizeof(nameBuf), "%s", p->name);
        }
        _tft.drawString(nameBuf, 12, iy + itemH / 2);

        // Override "*" rozetinin rengini turuncu yap (vurgu)
        if (isOverride) {
            int nameW = _tft.textWidth(p->name);
            _tft.setTextColor(COL_ORANGE, rowBg);
            _tft.drawString("*", 12 + nameW + 4, iy + itemH / 2);
            _tft.setTextColor(COL_TEXT, rowBg);
        }

        // Gun sayisi (sag)
        _tft.setTextDatum(MR_DATUM);
        _tft.setTextColor(COL_DIM, rowBg);
        char days[12];
        snprintf(days, sizeof(days), "%d gun", p->totalDays);
        _tft.drawString(days, SCR_W - 8, iy + itemH / 2);
    }

    // ---- Alt alan: asagi ok veya bos ----
    _tft.fillRect(0, listEndY, SCR_W, SCR_H - listEndY, COL_BG);
    if (_scrollOffset < maxScroll) {
        _tft.drawFastHLine(0, listEndY + 2, SCR_W, COL_DIM);
        _tft.setTextFont(2);
        _tft.setTextSize(1);
        _tft.setTextDatum(MC_DATUM);
        _tft.setTextColor(COL_CYAN, COL_BG);
        _tft.setTextPadding(0);
        _tft.drawString("v  ASAGI  v", SCR_W / 2, listEndY + ftrH / 2);
    }
}

// ==================== PROFIL EDITOR (TAM EKRAN) ====================
// Aktif fazin sicaklik ve nem esiklerini ±dugmelerle ayarlar.
// Sicaklik: ±0.1 C, Nem: ±%1.
// Override yoksa otomatik olusturulur (IncubationService tarafinda).
void DisplayManager::drawProfileEditor(const DisplayData &data) {
    const int hdrH    = 32;
    const int rowH    = 42;
    const int rowGap  = 3;
    const int rowsY   = hdrH + 3;
    const int padX    = 8;
    const int btnW    = 50;
    const int btnH    = rowH - 8;
    const int rowCount = 4;
    const char* labels[4] = {
        "Sicaklik (C)",
        "Nem Alt (%)",
        "Nem Ust (%)",
        "Cev. Aralik (dk)"
    };
    uint16_t valColors[4] = { COL_ORANGE, COL_BLUE, COL_BLUE, COL_GREEN };

    bool isOverride = _customProfileStorage &&
                      _customProfileStorage->hasProfileOverride(
                          (uint8_t)data.profileIndex);

    // ---- ARKAPLAN + STATIK ELEMANLAR (sadece ilk acilista veya force yenilemede) ----
    if (_bgDraw) {
        _tft.fillRect(0, 0, SCR_W, SCR_H, COL_BG);

        // Baslik bandi
        _tft.fillRect(0, 0, SCR_W, hdrH, COL_CARD);
        _tft.drawFastHLine(0, hdrH - 1, SCR_W, COL_DIM);

        // Satir kart arkaplanlari + ± butonlari + etiket (statik)
        for (int i = 0; i < rowCount; i++) {
            int y = rowsY + i * (rowH + rowGap);
            _tft.fillRoundRect(padX, y, SCR_W - padX * 2, rowH, 6, COL_CARD);

            int btnY = y + rowH - btnH - 4;

            // [-] butonu (sol) - once ciz
            int minusX = padX + 8;
            _tft.fillRoundRect(minusX, btnY, btnW, btnH, 5, COL_RED);
            _tft.setTextFont(2);
            _tft.setTextDatum(MC_DATUM);
            _tft.setTextColor(COL_TEXT, COL_RED);
            _tft.drawString("-", minusX + btnW / 2, btnY + btnH / 2);

            // [+] butonu (sag) - once ciz
            int plusX = SCR_W - padX - 8 - btnW;
            _tft.fillRoundRect(plusX, btnY, btnW, btnH, 5, COL_GREEN);
            _tft.setTextColor(COL_TEXT, COL_GREEN);
            _tft.drawString("+", plusX + btnW / 2, btnY + btnH / 2);

            // Etiket: butonlardan SONRA, iki buton arasina ortali (butonlar kapatmasin)
            _tft.setTextFont(1);
            _tft.setTextSize(1);
            _tft.setTextDatum(TC_DATUM);
            _tft.setTextColor(COL_DIM, COL_CARD);
            _tft.drawString(labels[i], SCR_W / 2, y + 4);
        }

        // Alt: Fabrika + Kapat (statik butonlar)
        int botY = rowsY + rowCount * (rowH + rowGap) + 4;
        int botBtnH = 32;
        int botBtnW = (SCR_W - padX * 3) / 2;

        uint16_t resetColor = isOverride ? COL_RED : 0x2104;
        _tft.fillRoundRect(padX, botY, botBtnW, botBtnH, 6, resetColor);
        _tft.setTextFont(2);
        _tft.setTextDatum(MC_DATUM);
        _tft.setTextColor(COL_TEXT, resetColor);
        _tft.drawString("Fabrika", padX + botBtnW / 2, botY + botBtnH / 2);

        int closeX = SCR_W - padX - botBtnW;
        _tft.fillRoundRect(closeX, botY, botBtnW, botBtnH, 6, COL_BLUE);
        _tft.setTextColor(COL_TEXT, COL_BLUE);
        _tft.drawString("Kapat", closeX + botBtnW / 2, botY + botBtnH / 2);
    }

    // ---- BASLIK YAZISI (her cycle, override durumu degisebilir) ----
    _tft.setTextFont(2);
    _tft.setTextSize(1);
    _tft.setTextDatum(MC_DATUM);
    _tft.setTextColor(COL_ORANGE, COL_CARD);
    _tft.setTextPadding(SCR_W);
    char hdr[40];
    snprintf(hdr, sizeof(hdr), "DUZENLE: %s%s",
             data.profileName ? data.profileName : "?",
             isOverride ? " *" : "");
    _tft.drawString(hdr, SCR_W / 2, hdrH / 2 - 4);
    _tft.setTextFont(1);
    _tft.setTextColor(COL_DIM, COL_CARD);
    char sub[40];
    snprintf(sub, sizeof(sub), "Faz: %s",
             data.phaseName ? data.phaseName : "-");
    _tft.drawString(sub, SCR_W / 2, hdrH - 6);
    _tft.setTextPadding(0);

    // ---- DEGER YAZILARI (her cycle — text padding ile arkaplan temizlenir) ----
    char vals[4][12];
    snprintf(vals[0], sizeof(vals[0]), "%.1f", data.targetTemp);
    snprintf(vals[1], sizeof(vals[1]), "%d",    (int)data.targetHumLow);
    snprintf(vals[2], sizeof(vals[2]), "%d",    (int)data.targetHumHigh);
    // Cev araligi: 0 ise "KAPALI"; aksi halde dk goster
    if (data.turningIntervalMin == 0) {
        snprintf(vals[3], sizeof(vals[3]), "KAPALI");
    } else {
        snprintf(vals[3], sizeof(vals[3]), "%d", (int)data.turningIntervalMin);
    }

    for (int i = 0; i < rowCount; i++) {
        int y = rowsY + i * (rowH + rowGap);
        int btnY = y + rowH - btnH - 4;

        _tft.setTextFont(2);
        _tft.setTextDatum(MC_DATUM);
        _tft.setTextColor(valColors[i], COL_CARD);
        _tft.setTextPadding(80);
        // Degeri alt yariya kaydir - etiket ile cakismasin
        _tft.drawString(vals[i], SCR_W / 2, btnY + btnH / 2 + 6);
    }
    _tft.setTextPadding(0);
    _tft.setTextDatum(TL_DATUM);
}
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
