emrah1982/KuluckaMakinesi/KuluckaMakinesi_Esp32/KuluckaMakinesi/WebService.cpp

#include "WebService.h"
#include "IncubationService.h"
#include "SensorManager.h"
#include "DeviceIdentity.h"
#include <ESPmDNS.h>

WebService::WebService(IncubationService &incubator, StorageService &storage)
    : _incubator(incubator)
    , _storage(storage)
    , _server(WEB_SERVER_PORT)
    , _wifiConnected(false)
    , _apActive(false)
    , _captiveActive(false)
    , _lastWiFiCheck(0)
{
}

StorageService& WebService::getStorage() {
    return _storage;
}

OTAService& WebService::getOTAService() {
    return _ota;
}

OTAUpdater& WebService::getOTAUpdater() {
    return _otaPull;
}

void WebService::begin() {
    // Gercek WiFi SSID var mi kontrol et
    bool hasRealSSID = _hasRealWiFiSSID();

    // AP modunu baslat (gercek SSID varsa AP+STA, yoksa sadece AP)
    setupAP(hasRealSSID);

    // Route tanimlari + sunucu baslat (AP hazir olunca hemen)
    setupRoutes();
    setupAPI();
    
    // OTA servisini baslat
    _ota.begin(_server);

    // Pull-based OTA (internet uzerinden) — NVS'den URL'i yukler
    _otaPull.begin();

    _server.begin();
    Serial.println("[WEB] Web sunucu baslatildi - Port: " + String(WEB_SERVER_PORT));

    // STA baglantisi sadece gercek SSID varsa denensin
    if (hasRealSSID) {
        connectWiFi();
    } else {
        Serial.println("[STA] WiFi SSID ayarlanmamis, sadece AP modu aktif");
    }

    // Captive portal: STA henuz baglanmadiysa baslat (kullanici WiFi kurulumu icin)
    // STA bagli olunca update() icinde otomatik kapanir
    if (_apActive && !_wifiConnected) {
        startCaptivePortal();
    }

    // mDNS baslat — "kulucka-a4c138f2.local" hostname'i ile
    // AP veya STA aktif oldugu surece her iki ag uzerinden de cozumlenir.
    if (_apActive || _wifiConnected) {
        const char* host = DeviceIdentity::getMdnsHostname().c_str();
        if (MDNS.begin(host)) {
            MDNS.addService("http", "tcp", WEB_SERVER_PORT);
            // Cihaz kesfi icin ozel servis — merkezi panel/scanner bunu sorgular
            MDNS.addService("kulucka", "tcp", WEB_SERVER_PORT);
            MDNS.addServiceTxt("kulucka", "tcp", "id",   DeviceIdentity::getDeviceId());
            MDNS.addServiceTxt("kulucka", "tcp", "name", DeviceIdentity::getDeviceName());
            MDNS.addServiceTxt("kulucka", "tcp", "fw",   DeviceIdentity::getFirmwareVersion());
            Serial.printf("[mDNS] %s.local yayinda (port %d)\n", host, WEB_SERVER_PORT);
        } else {
            Serial.println("[mDNS] HATA: baslatilamadi");
        }
    }

    Serial.println("--------------------------------------------");
    Serial.printf("[ID]   %s (%s)\n",
                  DeviceIdentity::getDeviceName().c_str(),
                  DeviceIdentity::getDeviceId().c_str());
    if (_apActive) {
        Serial.print("[AP]   Hotspot: ");
        Serial.print(DeviceIdentity::getApSsid());
        Serial.print(" → http://");
        Serial.println(WiFi.softAPIP());
    }
    if (_wifiConnected) {
        Serial.print("[STA]  WiFi:    ");
        Serial.print(WIFI_SSID);
        Serial.print(" → http://");
        Serial.println(WiFi.localIP());
    }
    if (_apActive || _wifiConnected) {
        Serial.printf("[mDNS] http://%s.local\n",
                      DeviceIdentity::getMdnsHostname().c_str());
    }
    Serial.println("--------------------------------------------");
}

bool WebService::_hasRealWiFiSSID() {
    StoredSettings s = _storage.loadSettings();
    const char* ssid = s.wifiSSID;
    // Kayitli SSID bos veya placeholder ise gercek SSID yok
    if (strlen(ssid) > 0 && strcmp(ssid, "WIFI_ADI") != 0) {
        return true;
    }
    // Config.h'deki SSID de placeholder mi?
    if (strcmp(WIFI_SSID, "WIFI_ADI") != 0 && strlen(WIFI_SSID) > 0) {
        return true;
    }
    return false;
}

void WebService::setupAP(bool withSTA) {
    // Gercek WiFi varsa AP+STA, yoksa sadece AP modu
    if (withSTA) {
        WiFi.mode(WIFI_AP_STA);
        Serial.println("[WIFI] Mod: AP+STA");
    } else {
        WiFi.mode(WIFI_AP);
        Serial.println("[WIFI] Mod: Sadece AP");
    }
    delay(100);

    // AP SSID — DeviceIdentity'den (her cihazda farkli, yan yana cakismaz)
    const char* apSsid = DeviceIdentity::getApSsid().c_str();

    // AP baslat (softAP once, config sonra - ESP32 core 3.x gerekliligi)
    bool apOK = WiFi.softAP(apSsid, AP_PASSWORD, AP_CHANNEL, false, AP_MAX_CONNECTIONS);
    delay(200);

    // AP IP konfigurasyonu (softAP basladiktan sonra)
    IPAddress apIP(AP_IP);
    IPAddress apGateway(AP_GATEWAY);
    IPAddress apSubnet(AP_SUBNET);
    WiFi.softAPConfig(apIP, apGateway, apSubnet);
    delay(100);

    if (apOK) {
        _apActive = true;
        Serial.print("[AP] Hotspot acildi: ");
        Serial.print(apSsid);
        Serial.print(" | Sifre: ");
        Serial.println(AP_PASSWORD);
        Serial.print("[AP] IP: ");
        Serial.println(WiFi.softAPIP());
    } else {
        _apActive = false;
        Serial.println("[AP] HATA: Hotspot acilamadi!");
    }
}

void WebService::connectWiFi() {
    // Kayitli WiFi bilgilerini kontrol et
    StoredSettings s = _storage.loadSettings();
    const char* ssid = s.wifiSSID;
    const char* pass = s.wifiPass;

    // Eger kayitli SSID bos veya varsayilansa Config.h'den al
    if (strlen(ssid) == 0 || strcmp(ssid, "WIFI_ADI") == 0) {
        ssid = WIFI_SSID;
        pass = WIFI_PASSWORD;
    }

    Serial.print("[STA] WiFi'ye baglaniyor: ");
    Serial.println(ssid);

    WiFi.begin(ssid, pass);

    unsigned long startTime = millis();
    while (WiFi.status() != WL_CONNECTED) {
        if (millis() - startTime > WIFI_CONNECT_TIMEOUT) {
            Serial.println();
            Serial.println("[STA] WiFi baglanti zaman asimi!");
            Serial.println("[STA] Sadece AP (hotspot) modu aktif");
            _wifiConnected = false;
            return;
        }
        delay(500);
        Serial.print(".");
    }

    _wifiConnected = true;
    Serial.println();
    Serial.print("[STA] WiFi baglandi! IP: ");
    Serial.println(WiFi.localIP());
}

bool WebService::isConnected() const {
    return _wifiConnected && (WiFi.status() == WL_CONNECTED);
}

bool WebService::isAPActive() const {
    return _apActive;
}

bool WebService::isCaptivePortalActive() const {
    return _captiveActive;
}

// ============================================================
//  CAPTIVE PORTAL — DNS yonlendirme
// ============================================================
void WebService::startCaptivePortal() {
    if (!_apActive) return;
    if (_captiveActive) return;

    // Tum DNS sorgulari AP IP'sine cevap dondurur — herhangi bir alan adi -> portal
    if (_dnsServer.start(CAPTIVE_DNS_PORT, "*", WiFi.softAPIP())) {
        _captiveActive = true;
        Serial.printf("[CAPTIVE] Portal acildi: http://%s%s\n",
                      WiFi.softAPIP().toString().c_str(), CAPTIVE_PORTAL_URL);
    } else {
        Serial.println("[CAPTIVE] HATA: DNS server baslatilamadi");
    }
}

void WebService::stopCaptivePortal() {
    if (!_captiveActive) return;
    _dnsServer.stop();
    _captiveActive = false;
    Serial.println("[CAPTIVE] Portal kapatildi (STA bagli)");
}

// Loop'tan periyodik cagrilir — DNS isleme + STA durum izleme + pull-OTA isteklerinin islenmesi
void WebService::update() {
    if (_captiveActive) {
        _dnsServer.processNextRequest();
    }

    // Pull-OTA: kullanici endpoint'ten istek tetikledi mi diye bakilir,
    // tetiklendiyse blocking indirme/dogrulama burada yurutulur (loop duraklar).
    _otaPull.update();

    // STA durumunu 1sn'de bir kontrol et (sik polling fayda etmez)
    unsigned long now = millis();
    if (now - _lastWiFiCheck < 1000) return;
    _lastWiFiCheck = now;

    bool nowConnected = (WiFi.status() == WL_CONNECTED);
    if (nowConnected != _wifiConnected) {
        _wifiConnected = nowConnected;
        if (nowConnected) {
            Serial.print("[STA] Bagli: ");
            Serial.println(WiFi.localIP());
            // STA bagli — captive portal'a artik gerek yok
            stopCaptivePortal();
        } else {
            Serial.println("[STA] Baglanti koptu");
            // STA dustu, AP hala varsa portal'i tekrar ac
            if (_apActive) startCaptivePortal();
        }
    }
}

// Kayitli ssid/pass ile non-blocking baglanma denemesi (portal flow icin)
bool WebService::_tryConnectAsync(const String &ssid, const String &pass) {
    // AP'yi koru, STA'yi acmak icin moda gecisi garantile
    wifi_mode_t mode = WiFi.getMode();
    if (mode == WIFI_AP) {
        WiFi.mode(WIFI_AP_STA);
        delay(100);
    }
    WiFi.disconnect(false, true);  // ssid/pass'i sil ama AP'yi koru
    delay(100);
    return WiFi.begin(ssid.c_str(), pass.c_str()) != WL_CONNECT_FAILED;
}

String WebService::getIPAddress() const {
    if (isConnected()) {
        return WiFi.localIP().toString();
    }
    return "Bagli degil";
}

String WebService::getAPIPAddress() const {
    if (_apActive) {
        return WiFi.softAPIP().toString();
    }
    return "";
}

void WebService::setupRoutes() {
    // Ana sayfa (PROGMEM)
    _server.on("/", HTTP_GET, [](AsyncWebServerRequest *request) {
        request->send(200, "text/html", PAGE_INDEX_HTML);
    });

    // Statik dosyalar (PROGMEM)
    _server.on("/style.css", HTTP_GET, [](AsyncWebServerRequest *request) {
        request->send(200, "text/css", PAGE_STYLE_CSS);
    });

    _server.on("/app.js", HTTP_GET, [](AsyncWebServerRequest *request) {
        request->send(200, "application/javascript", PAGE_APP_JS);
    });

    // ----- Pull-based OTA (Internet uzerinden firmware guncelleme) -----
    // /ota — kullanici arayuzu
    _server.on("/ota", HTTP_GET, [this](AsyncWebServerRequest *request) {
        handleGetOtaOnlinePage(request);
    });

    // ----- Captive Portal -----
    // Portal kurulum sayfasi
    _server.on(CAPTIVE_PORTAL_URL, HTTP_GET, [this](AsyncWebServerRequest *request) {
        handleGetPortal(request);
    });

    // Captive portal trigger URL'leri — OS otomatik bunlari sorgular,
    // 302 ile portal'a yonlendirilince "Sign in to network" dialogu acilir
    // iOS / macOS
    _server.on("/hotspot-detect.html",         HTTP_GET, [this](AsyncWebServerRequest *r){ handleCaptiveTrigger(r); });
    _server.on("/library/test/success.html",   HTTP_GET, [this](AsyncWebServerRequest *r){ handleCaptiveTrigger(r); });
    // Android
    _server.on("/generate_204",                HTTP_GET, [this](AsyncWebServerRequest *r){ handleCaptiveTrigger(r); });
    _server.on("/gen_204",                     HTTP_GET, [this](AsyncWebServerRequest *r){ handleCaptiveTrigger(r); });
    // Windows
    _server.on("/connecttest.txt",             HTTP_GET, [this](AsyncWebServerRequest *r){ handleCaptiveTrigger(r); });
    _server.on("/redirect",                    HTTP_GET, [this](AsyncWebServerRequest *r){ handleCaptiveTrigger(r); });
    _server.on("/ncsi.txt",                    HTTP_GET, [this](AsyncWebServerRequest *r){ handleCaptiveTrigger(r); });
    // Firefox
    _server.on("/canonical.html",              HTTP_GET, [this](AsyncWebServerRequest *r){ handleCaptiveTrigger(r); });
    // Chrome
    _server.on("/success.txt",                 HTTP_GET, [this](AsyncWebServerRequest *r){ handleCaptiveTrigger(r); });

    // 404 — captive aktifken portal'a yonlendir, degilse normal 404
    _server.onNotFound([this](AsyncWebServerRequest *request) {
        if (_captiveActive) {
            handleCaptiveTrigger(request);
            return;
        }
        request->send(404, "text/plain", "Sayfa bulunamadi");
    });
}

void WebService::setupAPI() {
    // GET /api/status
    _server.on("/api/status", HTTP_GET, [this](AsyncWebServerRequest *request) {
        handleGetStatus(request);
    });

    // GET /api/alarm
    _server.on("/api/alarm", HTTP_GET, [this](AsyncWebServerRequest *request) {
        handleGetAlarm(request);
    });

    // GET /api/history (sicaklik/nem/CO2 grafik verisi - son 60 okuma)
    _server.on("/api/history", HTTP_GET, [this](AsyncWebServerRequest *request) {
        handleGetHistory(request);
    });

    // GET /api/phase-log (faz gecis gecmisi: hangi faza ne zaman girildi)
    _server.on("/api/phase-log", HTTP_GET, [this](AsyncWebServerRequest *request) {
        handleGetPhaseLog(request);
    });

    // POST /api/time — manuel tarih/saat ayarla (web UI'dan)
    // Form: unix=<unixSec>  veya  date=YYYY-MM-DD&time=HH:MM
    // Hem POST body hem URL query parametre destegi (form parse hatasi yedek)
    // GET /api/time?unix=... — yedek (POST body parse hatasinda kullanilabilir)
    auto timeHandler = [this](AsyncWebServerRequest *request) {
        uint32_t unixSec = 0;
        const char* errMsg = "";
        String parsedDate = "", parsedTime = "";

        // Once unix parametresi (programatik) - body veya query
        bool hasUnix = request->hasParam("unix", true) || request->hasParam("unix", false);
        if (hasUnix) {
            String us = request->hasParam("unix", true)
                       ? request->getParam("unix", true)->value()
                       : request->getParam("unix", false)->value();
            unixSec = (uint32_t)us.toInt();
        } else {
            // date + time formati (body veya query)
            bool hasDate = request->hasParam("date", true) || request->hasParam("date", false);
            bool hasTime = request->hasParam("time", true) || request->hasParam("time", false);
            if (hasDate && hasTime) {
                parsedDate = request->hasParam("date", true)
                             ? request->getParam("date", true)->value()
                             : request->getParam("date", false)->value();
                parsedTime = request->hasParam("time", true)
                             ? request->getParam("time", true)->value()
                             : request->getParam("time", false)->value();
                int y = parsedDate.substring(0, 4).toInt();
                int mo = parsedDate.substring(5, 7).toInt();
                int da = parsedDate.substring(8, 10).toInt();
                int hh = parsedTime.substring(0, 2).toInt();
                int mm = parsedTime.substring(3, 5).toInt();
                if (y >= 2024 && y <= 2099 && mo >= 1 && mo <= 12 &&
                    da >= 1 && da <= 31 && hh <= 23 && mm <= 59) {
                    DateTime dt(y, mo, da, hh, mm, 0);
                    unixSec = (uint32_t)dt.unixtime();
                } else {
                    errMsg = "validation";
                }
            } else {
                errMsg = "missing_params";
            }
        }

        // Setrayim tarihi
        bool ok = false;
        if (unixSec > 0) {
            ok = _incubator.setSystemTime(unixSec);
            if (!ok) errMsg = "rtc_set_failed";
        } else if (errMsg[0] == '\0') {
            errMsg = "no_unix_computed";
        }

        // Debug log (Serial)
        Serial.printf("[API /time] unix=%u date='%s' time='%s' ok=%d err='%s'\n",
                      unixSec, parsedDate.c_str(), parsedTime.c_str(),
                      ok ? 1 : 0, errMsg);

        // JSON cevap (detayli hata)
        String resp = String("{\"ok\":") + (ok ? "true" : "false") +
                      ",\"unix\":" + String(unixSec) +
                      ",\"err\":\"" + errMsg + "\"" +
                      ",\"date\":\"" + parsedDate + "\"" +
                      ",\"time\":\"" + parsedTime + "\"}";
        request->send(ok ? 200 : 400, "application/json", resp);
    };
    _server.on("/api/time", HTTP_POST, timeHandler);
    _server.on("/api/time", HTTP_GET,  timeHandler);   // YEDEK: POST body parse hatalarinda GET kullanilabilir

    // GET /api/profiles
    _server.on("/api/profiles", HTTP_GET, [this](AsyncWebServerRequest *request) {
        handleGetProfiles(request);
    });

    // POST /api/profile
    _server.on("/api/profile", HTTP_POST, [this](AsyncWebServerRequest *request) {
        handlePostProfile(request);
    });

    // POST /api/control
    _server.on("/api/control", HTTP_POST, [this](AsyncWebServerRequest *request) {
        handlePostControl(request);
    });

    // POST /api/pid
    _server.on("/api/pid", HTTP_POST, [this](AsyncWebServerRequest *request) {
        handlePostPID(request);
    });

    // POST /api/humidity
    _server.on("/api/humidity", HTTP_POST, [this](AsyncWebServerRequest *request) {
        handlePostHumidity(request);
    });

    // POST /api/safety
    _server.on("/api/safety", HTTP_POST, [this](AsyncWebServerRequest *request) {
        handlePostSafety(request);
    });

    // POST /api/alarm/ack — kullanici alarmi sustur (10 dk default)
    _server.on("/api/alarm/ack", HTTP_POST, [this](AsyncWebServerRequest *request) {
        handlePostAlarmAck(request);
    });

    // POST /api/alarm/snooze — alarmi ertele (candling icin 1 saat default)
    _server.on("/api/alarm/snooze", HTTP_POST, [this](AsyncWebServerRequest *request) {
        uint32_t durationMs = 0;
        if (request->hasParam("ms", true)) {
            durationMs = (uint32_t)request->getParam("ms", true)->value().toInt();
        }
        _incubator.snoozeActiveAlarm(durationMs);
        request->send(200, "application/json", "{\"ok\":true,\"action\":\"snooze\"}");
    });

    // POST /api/alarm/dismiss — alarmi tamamen kapat (bugun icin tekrar tetiklenmez)
    _server.on("/api/alarm/dismiss", HTTP_POST, [this](AsyncWebServerRequest *request) {
        _incubator.dismissActiveAlarm();
        request->send(200, "application/json", "{\"ok\":true,\"action\":\"dismiss\"}");
    });

    // GET /api/custom-profiles
    _server.on("/api/custom-profiles", HTTP_GET, [this](AsyncWebServerRequest *request) {
        handleGetCustomProfiles(request);
    });

    // POST /api/custom-profile
    _server.on("/api/custom-profile", HTTP_POST, [this](AsyncWebServerRequest *request) {
        handlePostCustomProfile(request);
    });

    // DELETE /api/custom-profile
    _server.on("/api/custom-profile", HTTP_DELETE, [this](AsyncWebServerRequest *request) {
        handleDeleteCustomProfile(request);
    });

    // POST /api/profile-override/clone — hazir profili klonla, custom slot olustur
    _server.on("/api/profile-override/clone", HTTP_POST, [this](AsyncWebServerRequest *request) {
        handlePostProfileOverrideClone(request);
    });

    // DELETE /api/profile-override — fabrika ayarlarina dondur (override sil)
    _server.on("/api/profile-override", HTTP_DELETE, [this](AsyncWebServerRequest *request) {
        handleDeleteProfileOverride(request);
    });

    // POST /api/save-settings
    _server.on("/api/save-settings", HTTP_POST, [this](AsyncWebServerRequest *request) {
        handlePostSaveSettings(request);
    });

    // POST /api/cleaning — Temizlik modu kontrolleri
    _server.on("/api/cleaning", HTTP_POST, [this](AsyncWebServerRequest *request) {
        handlePostCleaning(request);
    });

    // POST /api/egg-ip — Yumurta ESP32 IP adresini kaydet
    _server.on("/api/egg-ip", HTTP_POST, [this](AsyncWebServerRequest *request) {
        handlePostEggSensorIP(request);
    });
    // GET /api/egg-ip — Mevcut IP'yi dondur
    _server.on("/api/egg-ip", HTTP_GET, [this](AsyncWebServerRequest *request) {
        handleGetEggSensorIP(request);
    });

    // POST/GET /api/egg-discover — Asenkron mDNS kesfi baslat (fire-and-forget)
    // EggTempService kendi task'inda yumurta.local'u arar.
    // UI /api/egg-discover-status ile durumu polling yapar.
    auto startDiscovery = [this](AsyncWebServerRequest *request) {
        _incubator.getEggTempService().requestDiscovery();
        request->send(200, "application/json",
            "{\"ok\":true,\"status\":\"started\"}");
    };
    _server.on("/api/egg-discover", HTTP_GET,  startDiscovery);
    _server.on("/api/egg-discover", HTTP_POST, startDiscovery);

    // GET /api/egg-discover-status — Kesif durumu (UI polling)
    _server.on("/api/egg-discover-status", HTTP_GET, [this](AsyncWebServerRequest *request) {
        EggTempService& svc = _incubator.getEggTempService();
        EggTempService::DiscoveryStatus s = svc.getDiscoveryStatus();
        const char* sStr = "none";
        switch (s) {
            case EggTempService::DISC_RUNNING: sStr = "running"; break;
            case EggTempService::DISC_OK:      sStr = "ok";      break;
            case EggTempService::DISC_FAILED:  sStr = "failed";  break;
            default:                            sStr = "none";    break;
        }
        // OK durumunda IP'yi NVS'e kalici yap (idempotent: zaten kayitliysa overwrite)
        if (s == EggTempService::DISC_OK) {
            String ip = svc.getIP();
            StoredSettings saved = _storage.loadSettings();
            if (strcmp(saved.yumurtaIP, ip.c_str()) != 0) {
                strncpy(saved.yumurtaIP, ip.c_str(), sizeof(saved.yumurtaIP) - 1);
                saved.yumurtaIP[sizeof(saved.yumurtaIP) - 1] = '\0';
                _storage.saveSettings(saved);
            }
        }
        String resp = "{\"status\":\"" + String(sStr) + "\",\"ip\":\"" +
                      svc.getIP() + "\"}";
        request->send(200, "application/json", resp);
    });

    // GET /api/load-settings
    _server.on("/api/load-settings", HTTP_GET, [this](AsyncWebServerRequest *request) {
        handleGetLoadSettings(request);
    });

    // POST /api/wifi (eski) — sadece kaydet, reboot gerek
    _server.on("/api/wifi", HTTP_POST, [this](AsyncWebServerRequest *request) {
        handlePostWiFi(request);
    });

    // GET /api/wifi/scan — etraftaki WiFi aglarini tara (asenkron)
    // Parametreler: ?refresh=1 ile yeni tarama tetiklenir, parametresizken son sonucu doner
    _server.on("/api/wifi/scan", HTTP_GET, [this](AsyncWebServerRequest *request) {
        handleGetWifiScan(request);
    });

    // GET /api/wifi/status — STA baglanti durumu (portal polling icin)
    _server.on("/api/wifi/status", HTTP_GET, [this](AsyncWebServerRequest *request) {
        handleGetWifiStatus(request);
    });

    // POST /api/wifi/connect — kaydet + bagla (reboot olmadan)
    _server.on("/api/wifi/connect", HTTP_POST, [this](AsyncWebServerRequest *request) {
        handlePostWifiConnect(request);
    });

    // GET /api/log
    _server.on("/api/log", HTTP_GET, [this](AsyncWebServerRequest *request) {
        handleGetLog(request);
    });

    // DELETE /api/log
    _server.on("/api/log", HTTP_DELETE, [this](AsyncWebServerRequest *request) {
        handleDeleteLog(request);
    });

    // GET /api/calibration
    _server.on("/api/calibration", HTTP_GET, [this](AsyncWebServerRequest *request) {
        handleGetCalibration(request);
    });

    // POST /api/calibration
    _server.on("/api/calibration", HTTP_POST, [this](AsyncWebServerRequest *request) {
        handlePostCalibration(request);
    });

    // GET /api/identity — cihaz kimligi (deviceId, isim, FW versiyonu, MAC, AP SSID, mDNS)
    _server.on("/api/identity", HTTP_GET, [this](AsyncWebServerRequest *request) {
        handleGetIdentity(request);
    });

    // POST /api/device-name — kullanici tanimli cihaz ismini gunceller
    _server.on("/api/device-name", HTTP_POST, [this](AsyncWebServerRequest *request) {
        handlePostDeviceName(request);
    });

    // ----- Pull-based OTA endpoint'leri -----
    // GET  /api/ota/status — JSON: state, progress, remoteVersion, updateUrl, ...
    _server.on("/api/ota/status", HTTP_GET, [this](AsyncWebServerRequest *request) {
        handleGetOtaStatus(request);
    });

    // POST /api/ota/check — version.json indirme + semver karsilastirma tetikleyici
    _server.on("/api/ota/check", HTTP_POST, [this](AsyncWebServerRequest *request) {
        handlePostOtaCheck(request);
    });

    // POST /api/ota/pull — .bin indir + SHA256 dogrula + flash + reboot
    _server.on("/api/ota/pull", HTTP_POST, [this](AsyncWebServerRequest *request) {
        handlePostOtaPull(request);
    });

    // POST /api/ota/url — version.json adresini NVS'e kaydet
    _server.on("/api/ota/url", HTTP_POST, [this](AsyncWebServerRequest *request) {
        handlePostOtaUrl(request);
    });
}

// ==================== API HANDLER'LARI ====================

void WebService::handleGetStatus(AsyncWebServerRequest *request) {
    String json = _incubator.getStatusJSON();
    // JSON'un sonundaki '}' karakterini kaldir, kimlik + ag bilgisi ekle
    if (json.endsWith("}")) {
        json.remove(json.length() - 1);
        json += ",\"deviceId\":\""   + DeviceIdentity::getDeviceId()   + "\"";
        json += ",\"deviceName\":\"" + DeviceIdentity::getDeviceName() + "\"";
        json += ",\"fwVersion\":\""  + String(DeviceIdentity::getFirmwareVersion()) + "\"";
        json += ",\"eggCount\":" + String(_storage.getEggCount());
        json += ",\"apActive\":" + String(_apActive ? "true" : "false");
        if (_apActive) {
            json += ",\"apSSID\":\"" + DeviceIdentity::getApSsid() + "\"";
            json += ",\"apIP\":\"" + WiFi.softAPIP().toString() + "\"";
            json += ",\"apClients\":" + String(WiFi.softAPgetStationNum());
        }
        json += ",\"mdns\":\"" + DeviceIdentity::getMdnsHostname() + ".local\"";
        json += ",\"staConnected\":" + String(isConnected() ? "true" : "false");
        if (isConnected()) {
            json += ",\"staIP\":\"" + WiFi.localIP().toString() + "\"";
        }
        json += "}";
    }
    request->send(200, "application/json", json);
}

void WebService::handleGetAlarm(AsyncWebServerRequest *request) {
    String json = _incubator.getAlarmService().getAlarmJSON();
    request->send(200, "application/json", json);
}

void WebService::handleGetHistory(AsyncWebServerRequest *request) {
    String json = _incubator.getHistoryJSON();
    request->send(200, "application/json", json);
}

void WebService::handleGetPhaseLog(AsyncWebServerRequest *request) {
    String json = _incubator.getPhaseLogJSON();
    request->send(200, "application/json", json);
}

void WebService::handleGetProfiles(AsyncWebServerRequest *request) {
    String json = "[";
    for (uint8_t i = 0; i < PROFILE_COUNT; i++) {
        if (i > 0) json += ",";
        json += "{\"index\":";
        json += String(i);
        json += ",\"name\":\"";
        json += String(ALL_PROFILES[i]->name);
        json += "\",\"nameEN\":\"";
        json += String(ALL_PROFILES[i]->nameEN);
        json += "\",\"days\":";
        json += String(ALL_PROFILES[i]->totalDays);
        // Override durumu (kullanici bu hazir profili duzenlemis mi?)
        json += ",\"hasOverride\":";
        json += _storage.hasProfileOverride(i) ? "true" : "false";
        json += ",\"overrideIdx\":";
        json += String(_storage.getOverrideCustomIdx(i));
        json += "}";
    }
    json += "]";
    request->send(200, "application/json", json);
}

void WebService::handlePostProfile(AsyncWebServerRequest *request) {
    if (request->hasParam("index", true)) {
        uint8_t idx = request->getParam("index", true)->value().toInt();
        if (idx < PROFILE_COUNT) {
            _incubator.setProfile(idx);
            request->send(200, "application/json", "{\"ok\":true,\"msg\":\"Profil secildi: " + String(ALL_PROFILES[idx]->name) + "\"}");
        } else {
            request->send(400, "application/json", "{\"ok\":false,\"msg\":\"Gecersiz profil indexi\"}");
        }
    } else {
        request->send(400, "application/json", "{\"ok\":false,\"msg\":\"index parametresi eksik\"}");
    }
}

void WebService::handlePostControl(AsyncWebServerRequest *request) {
    if (request->hasParam("action", true)) {
        String action = request->getParam("action", true)->value();

        if (action == "start") {
            _incubator.start();
            request->send(200, "application/json", "{\"ok\":true,\"msg\":\"Kulucka baslatildi\"}");
        } else if (action == "pause") {
            _incubator.pause();
            request->send(200, "application/json", "{\"ok\":true,\"msg\":\"Sistem duraklatildi\"}");
        } else if (action == "resume") {
            _incubator.resume();
            request->send(200, "application/json", "{\"ok\":true,\"msg\":\"Sistem devam ediyor\"}");
        } else if (action == "stop") {
            _incubator.stop();
            request->send(200, "application/json", "{\"ok\":true,\"msg\":\"Sistem durduruldu\"}");
        } else {
            request->send(400, "application/json", "{\"ok\":false,\"msg\":\"Gecersiz aksiyon\"}");
        }
    } else {
        request->send(400, "application/json", "{\"ok\":false,\"msg\":\"action parametresi eksik\"}");
    }
}
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
