emrah1982/KuluckaMakinesi/(commit log)

2026-08-02 ilk commit: ESP32 akilli kulucka kontrol sistemi
    Cok profilli (11 hayvan) kulucka makinesi firmware'i, KiCad devre tasarimi,
    web arayuzu ve dokumantasyon.
    Donanim:
    - ESP32 + 3.2" TFT dokunmatik ekran
    - Grove 8 kanal I2C multiplexer (TCA9548A, 0x70) arkasinda tum I2C cihazlari
    CH0 DS3231 RTC | CH1 SHT40 | CH2 SHT30 | CH3 SCD30 CO2
    CH4 MLX90614 yumurta IR | CH7 PCF8574 4'lu role
    - PID + time-proportional isitici, PWM fan, step/DC yumurta cevirme
    Bu commit'te yer alan son calismalar:
    - Grove 8 kanal MUX'a gecis; MUX adresi otomatik bulunuyor ve kontrol
    registeri geri okunarak gercekten multiplexer oldugu dogrulaniyor
    - MLX90614 yerel yumurta IR sensoru (SMBus + PEC dogrulamali, kutuphan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
    [KuluckaMakinesi.kicad_pcb, KuluckaMakinesi.kicad_sch, log.csv, partitions.csv]
2026-08-02 fix(debug): DEBUG_ENABLED 1 - seri monitorde veri gorunmuyordu
    Periyodik [STATUS] sicaklik/nem satiri debugLog() icinde #if DEBUG_ENABLED
    blogunda. Bayrak 0 oldugu icin bu kod derlemede tamamen siliniyordu; port,
    baud ve kablo dogru olsa bile seri monitore hicbir olcum verisi gelmiyordu.
    Bayragin uzerine ne zaman 0 ne zaman 1 kullanilacagini aciklayan yorum eklendi.
    Sahaya cikarken tekrar 0 yapilabilir (flash tasarrufu).
    [Config.h]
2026-08-02 feat(tani+ekran): kanal tarayici, I2C kurtarma ve durus gostergeleri
    Sahada MUX arkasindaki cihazlarin hicbiri gorunmuyordu. Teshisi mumkun
    kilan araclar ve bu sirada ortaya cikan yaniltici gostergelerin duzeltmesi.
    TANI ARACLARI
    - I2CMux::scanAllChannels(): 8 kanali tek tek tarar, her kanaldaki I2C
    adreslerini listeler. Bir cihaz "BULUNAMADI" verdiginde asil soru
    "hic yok mu, baska kanalda mi" idi; bu tarama dogrudan yanitliyor.
    Herhangi bir cihaz eksikse acilista otomatik calisir.
    - Ana bus taramasi: tum kanallar kapaliyken kim cevap veriyor. MUX'un
    ARKASINA degil ONUNE baglanmis cihazlari ortaya cikarir.
    - Kanal secimi dogrulamasi: secim sonrasi kontrol registeri geri okunur.
    Y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
2026-08-02 feat(ekran): nem ve CO2 kadranlarina da sapma satiri + partition dokuman duzeltmesi
    SAPMA SATIRI (nem, CO2)
    Sicaklik kadranindaki "hedefe ne kadar kaldi" satiri diger iki kadrana da
    eklendi. Referans mantigi olcumun dogasina gore ayrisiyor:
    DEV_SETPOINT (sicaklik) : tek dogru deger var -> sapma set noktasina gore,
    bant icinde de sayi yazilir (0.1 C onemli).
    DEV_BAND (nem, CO2) : aralik hedeflenir -> aralik ICINDE sapma diye bir
    sey yoktur; "HEDEFTE" yazilir. Disarda ise en
    yakin sinira uzaklik gosterilir.
    Nem icin ortalamaya gore sapma yazmak yanlis olurdu: %56 da %64 de hedeftedir.
    CO2'de sensor y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
2026-08-02 fix(i2c): sonsuz bus kurtarma dongusu - eksik cihaz bus arizasi sanildi
    REGRESYON. Onceki commit'te eklenen kurtarma mantigi, calisan bir sistemi
    kurtarma dongusune sokuyordu:
    [MUX] Bus kurtarma basliyor (#6)...
    [MUX] Kurtarma BASARISIZ - MUX hala yok
    [MUX] Bus kurtarma basliyor (#7)...
    ... sonsuza kadar
    KOK NEDEN
    RelayBoard::writeState() ILK yazma hatasinda I2CMux::recover() cagiriyordu.
    Isitici rolesi her dongude yazilir; PCF8574 TAKILI DEGILSE her yazma
    basarisiz olur ve her dongude tam bus kurtarma tetiklenir. Kurtarma da
    Wire.end()/begin() + bit-bang ile bus'i yikip yeniden kurdugu icin saglam
    olan hatti da bozuyor, sonra kendini bulamiyordu.
    Kisacasi: EKSIK BIR CIHAZ, BUS AR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
    [Config.h, I2CMux.cpp, RelayBoard.cpp]
2026-08-05 fix(ekran): veri hazirligi kapisi, susturulmus alarm gostergesi, sensor dili
    TFT incelemesinde cikan uc bulgu.
    1) HER LOOP'TA EKRAN VERISI KURULUYORDU (kararlilik)
    updateDisplay() loop araligi kapisindan ONCE cagriliyordu ve loop()'ta
    delay yok; yani saniyede binlerce kez tum DisplayData bastan kuruluyordu -
    icinde String tahsisleriyle birlikte. Ekran ise 500 ms'de bir cizilir.
    Islerin %99'u cope gidiyordu ve surekli heap tahsisi, 18-21 gun kesintisiz
    calisan bir cihazda fragmentasyon riski demek.
    - Veri hazirligina DISPLAY_DATA_INTERVAL_MS (50 ms) kapisi eklendi.
    Dokunmatik etkilenmez: TOUCH_DEBOUNCE_MS zaten 250 ms.
    - DisplayData::startDate kaldirildi: her hazirlikta String olar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
    [Config.h, DisplayManager.cpp, DisplayManager.h, IncubationService.cpp]
2026-08-05 feat(ekran): CO2/IR kaynagi/IO seridi, termal kacis banneri, renk mantigi tek kaynakta
    TFT incelemesinde kalan bes maddenin tamami.
    1) DURUM SERIDI - CO2, IR KAYNAGI, I/O SAGLIGI
    Durum sekmesinde alarm kartinin altinda 264-290 arasi bos duruyordu.
    Oraya kompakt bir serit eklendi (STA_Y=266, STA_H=22):
    CO2 1250/3000 IR 37.6 Y I/O OK
    - CO2: deger durum renginde, limit KIRMIZI (diger hedeflerle ayni dil).
    Durum sekmesinde CO2 daha once hic yoktu; iki kart 115px oldugu ve
    aralarinda 6px kaldigi icin ucuncu kart sigmiyordu.
    - IR: yumurta sicakligi + kaynak. Y=yerel MLX90614 (yesil),
    U=uzak WiFi yedegi (cyan). Yedege dusuldugunde olcum agdan gelir ve
    bagl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
    [DisplayManager.cpp, DisplayManager.h, IncubationService.cpp]
2026-08-05 fix(ekran): Profil sekmesinde ust uste binen yazilar
    Uc ayri cakisma vardi. Font yukseklikleri: Font1=8, Font2=16, Font4=26 px.
    1) EVRE KARTI ICINDEKI UC SATIR
    Uc satir da Font 2 kullaniyor, yani en az 48 px gerekiyor:
    kompakt (4+ faz): kart 44 px, satirlar +3/+18/+30
    satir2 satir1'e 1 px, satir3 satir2'ye 4 px biniyordu; ustelik
    satir3 (30+16=46) 44 px'lik karti tasiyordu.
    normal (2-3 faz): kart 56 px, satirlar +4/+26/+40
    satir3 satir2'ye 2 px biniyordu.
    Kompakt kart 52 px'e cikarildi, satirlar +2/+19/+35 ve +4/+23/+40 oldu.
    2) BASLIK: PROFIL ADI vs EVRE ADI
    Profil adi (Font 4, y 20..46, sol) ile evre adi (Font 2, y 24..40, saga
    hizali) AYNI yatay bantta idi. "Ipek B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
    [DisplayManager.cpp]
2026-08-05 fix(ekran): Profil sekmesinde kaydirma gorunur hale getirildi
    "1/2" gosterilip 2. sayfaya nasil gecilecegi belli degildi.
    Kaydirma tamamen GORUNMEZ dokunma bolgeleriyle yapiliyordu:
    yukari: y 38..80 arasi
    asagi : y > 220
    Ekranda bu bolgeleri isaret eden hicbir sey yoktu; kullanici kaydirmanin
    mumkun oldugunu ancak rastgele dokunarak kesfedebilirdi. Ustelik bolgeler
    kart sinirlariyla da ortusmuyordu (y 38..80 basligin ortasindan basliyor,
    y>220 son kartin icine giriyordu).
    DUZELTME
    Dokunma bolgeleri artik EKRANDA GORUNEN kontrollerle ayni yerde:
    yukari -> baslik kartinin tamami (y 2..64). Sayfa gostergesi kaydirma
    mumkunken "^ 1/2" seklinde ve cyan renkte yazilir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
    [DisplayManager.cpp, DisplayManager.h]
2026-08-05 feat(ekran): tamamlanan evreler ayri cerceve ile gosteriliyor
    Profil sekmesinde yalnizca AKTIF evre ayrisiyordu; tamamlanan evrelerle
    henuz gelinmeyenler birbirinin ayni gorunuyordu. Kulucka nerede, hangi
    evreler geride kaldi - bunlar bir bakista okunamiyordu.
    Uc zaman durumu artik kendi cercevesine sahip:
    AKTIF yesil cerceve + koyu yesil zemin + yesil kenar cubugu
    TAMAMLANDI gri cerceve + soluk icerik + gun araliginda "OK" eki
    BEKLIYOR cerceve yok, mor kenar cubugu (one cikmasin)
    Durum gun karsilastirmasindan turetiliyor:
    isDone = kulucka basladi && aktif degil && currentDay > ph.endDay
    Kulucka baslamadiysa (currentDay == 0) hicbir evre tamamlanmis sayilmaz.
    Tamamlanan ev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
2026-08-05 fix(ekran): evre cerceveleri gun donunce otomatik ilerlemiyordu
    Onceki commit uc zaman durumu icin ayri cerceveler ekledi ama cerceve
    gun degisiminde GUNCELLENMIYORDU.
    Kart cercevesi ve kenar cubugu _bgDraw katmaninda cizilir:
    if (_bgDraw) {
    fillRoundRect(...); // zemin
    fillRoundRect(... accent); // kenar cubugu
    drawRoundRect(... yesil/gri) // CERCEVE
    }
    _bgDraw yalnizca tam yenilemede (sekme degisimi, _forceRedraw) true olur.
    Metin renkleri her dongude yeniden cizildigi icin soluklasiyordu, ama
    cerceve ve kenar cubugu eski durumda kaliyordu. Sonuc: gun donup evre
    tamamlandiginda kullanici Profil sekmesinde beklerse cerceve degismiyor,
    a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
    [DisplayManager.cpp]
2026-08-05 fix(ekran): modal titremesi + buyutulmus yazilar + Ayar'da CO2 sensoru
    1) SISTEM KONTROL MODALI SUREKLI YENILENIYORDU
    drawSysControl() her DISPLAY_UPDATE_MS'de (500 ms) cagriliyordu ve ilk isi
    fillRoundRect ile tum zemini yeniden doldurmakti; gozle gorulur sekilde
    yanip sonuyordu. Modal icerigi acikken degismedigi icin artik yalnizca BIR
    KEZ ciziliyor (_sysCtrlDrawn). Alarm modalindeki _alarmModalDrawn kalibinin
    aynisi; orada bu koruma vardi, yenisine eklemeyi atlamisim.
    2) YAZILAR BUYUTULDU - TASMA HESAPLANDI
    DURUM Font 2 -> Font 4 (modaldeki en onemli bilgi)
    Gun Font 1 -> Font 2
    Uyari Font 1 -> Font 2 (metinler 26 karakter sinirina gore kisaltildi)
    Butonlar 40 -> 44 px yu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
    [DisplayManager.cpp, DisplayManager.h]
2026-08-05 feat(test): role test modu - PCF8574 rolelerinin tek tek denenmesi (GECICI)
    Devreye alma testleri icin PCF8574 (MUX CH7) uzerindeki dort rolenin
    TFT'den tek tek acilip kapatilmasi.
    ONEMLI DUZELTME: FAN ROLEDE DEGIL
    Talepte "isitici, nem ve fan roleye bagli" deniyordu ama donanim boyle
    degil. PCF8574'teki dort role sunlar:
    P0 = Isitici P1 = Nemlendirici P2 = Cevirme guc P3 = Cevirme yon
    Fan IO18 uzerinden 25 kHz PWM ile L298N surucuye gidiyor. Bu yuzden
    testte ayri bir buton olarak veriliyor; rolelerle karistirilmamali.
    TASARIM
    - Otomatik kontrolun TAMAMI askiya alinir, roleler dogrudan yazilir.
    HeaterDriver/TurnerDriver devrede degil ki komutlari ezmesin.
    - Kulucka STATE'i DEGI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
2026-08-05 fix(test): TESTI BITIR calismiyordu + modal surekli yanip sonuyordu
    Ikisi de bir onceki commit'in hatasi.
    1) TESTI BITIR TEPKI VERMIYORDU
    Role testi dokunma blogu handleTouch icinde satir 495'te, yani
    "if (_tab == TAB_CTRL)" blogunun (satir 417) ARDINDA duruyordu. Test
    modali Kontrol sekmesinden acildigi icin _tab hep TAB_CTRL oluyor ve
    sekme isleyicisi once calisiyordu.
    Cakisan koordinatlar:
    TESTI BITIR y 208..248
    Profil Sec / Duzenle y 218..246
    Yani butona her basista profil listesi/editoru aciliyordu.
    Blok artik handleTouch'in EN BASINDA, alarm modalinden bile once.
    Modal dokunmasi tanim geregi tum sekme isleyicilerinden once gelmelidir.
    2) MODAL SUREKLI YANIP S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
    [DisplayManager.cpp, DisplayManager.h]
2026-08-05 feat(test): tek test butonu + gercek dunya guvenlik kilitleri
    1) MANUEL KART TEK GIRISE INDIRILDI
    Onceden ISITICI ve NEM toggle'lari ile TEST butonu yan yanaydi. Ilk ikisi
    temizlik modu uzerinden, test ise otomatik kontrolu tamamen askiya alan
    AYRI bir yol uzerinden calisiyordu. Iki farkli manuel mekanizmayi yan yana
    koymak hangi durumda olundugunu belirsizlestiriyor ve kazara yanlis moda
    girme riski yaratiyordu. Role testi zaten isitici (P0) ve nemlendiriciyi
    (P1) de kapsiyor; tek buton kaldi: "ROLE / CIKIS TESTI".
    2) UC GUVENLIK KILIDI EKLENDI
    KILIT 1 - H-koprusu kisa devre korumasi
    P2 (motor guc) ACIKKEN P3 (yon) degistirmek, H-koprusunde iki kolun ayni
    anda iletime girmesine (sho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
2026-08-05 feat(fan): L298N IN1 -> PCF8574 P7 uzerinden fan enable kontrolu
    Fan artik L298N motor surucu uzerinden calisiyor:
    ESP32 IO18 -> ENA : 25 kHz PWM (hiz)
    PCF8574 P7 -> IN1 : enable/yon mantik girisi
    L298N IN2 -> GND : tek yon calisma
    FIRMWARE P7'YI SURMUYORDU
    IN1 LOW iken motor donmez, PWM ne olursa olsun. P7'yi hicbir kod
    yazmadigi icin fan yalnizca PCF8574'un varsayilan durumuna bagli
    calisacakti. FanDriver artik IN1'i yonetiyor.
    Yazma yalnizca AC/KAPA gecisinde yapiliyor. writePWM() soft ramp
    sirasinda cok sik cagriliyor; her cagrida I2C'ye yazmak MUX'u ve bus'i
    bosuna mesgul ederdi.
    RELAY_ALL_OFF 0xFF -> 0x7F (guvenlik)
    Bit 7 de HIGH oldugu icin "tum cikislar kapali" den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
2026-08-05 feat(fan): FAN_SPEED_CONTROL - ENA kablosu olmadan da dogru calisma
    Kullanici IO18 -> ENA kablosunu cekmedi, yalnizca P7 -> IN1 baglayacak.
    Firmware her iki kuruluma da uyacak sekilde ayarlanabilir yapildi.
    FAN_SPEED_CONTROL = 1 (IO18 -> ENA VAR)
    Degisken hiz calisir. L298N kartindaki ENA jumper'i CIKARILMALIDIR;
    takili kalirsa ENA surekli 5V'ta kalir ve PWM etkisiz olur.
    FAN_SPEED_CONTROL = 0 (IO18 -> ENA YOK)
    ENA jumper'i takili kalir, surucu surekli aktiftir. Fan yalnizca P7 ile
    ac/kapa edilir ve daima tam hizda doner. ledcWrite yine cagrilir ama
    deger 0/255'e yuvarlanir; pin bosta salinmaz.
    NEDEN P7 ILE HIZ AYARI YAPILAMAZ
    P7 bir I2C genisletici pini. Her seviye degisimi b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
2026-08-05 feat(fan): kesintili calisma modu + README ve baglanti tablolari
    1) FAN KESINTILI CALISMA (FAN_DUTY_MODE)
    PWM daima [FAN_MIN_PWM=80, 255] araligina kirpiliyordu; yani fan hicbir
    zaman durmuyordu. FAN_DUTY_MODE=1 ile fan her FAN_DUTY_PERIOD_SEC (5 dk)
    icinde FAN_DUTY_ON_SEC (1 dk) calisip kalan surede duruyor.
    KULUCKAYA OZGU TASARIM KARARI
    Fan yalnizca sogutma degil HOMOJENLIK aracidir. Uzun sure durursa kabin
    katmanlasir (ust sicak, alt soguk); sensor kendi bolgesini olcer ve PID
    dogru olctugunu sanirken tepsinin bir bolumu hedeften sapabilir. Bu yuzden
    "kesintili" TAMAMEN KAPALI demek degil:
    - her periyotta GARANTI bir sirkulasyon penceresi var
    - sicaklik hedefi FAN_DUTY_FORCE_DELTA (0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
2026-08-05 fix(alarm): sustur suresi dolunca ses gelmiyordu + desen bozuktu
    Iki ayri hata, ikisi de hoparlorun alarm durumundan kopuk calismasindan.
    1) SES OLAY TABANLIYDI, DURUM TABANLI DEGIL
    startAlarmPattern() YALNIZCA triggerAlarm() icinde cagriliyordu. Modal ise
    durum tabanli calisiyor:
    shouldAutoShowModal() = _alarmActive && !isMuted()
    Sonuc: sustur (10 dk) suresi dolunca modal ANINDA geri geliyor, ama ses
    ancak bir sonraki triggerAlarm() cagrisinda basliyordu. O cagri da
    checkDynamic icindeki ALARM_COOLDOWN (60 sn) kapisina takiliyordu -
    kullanicinin gordugu "1-2 dakika sonra ses geliyor" tam olarak buydu.
    Daha kotusu: tekrar tetiklenmeyen alarm tiplerinde (CANDLING_DUE,
    PHASE_TRANSITION,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
    [AlarmService.cpp, AlarmService.h, IncubationService.cpp, SpeakerDriver.h]
2026-08-05 feat(alarm): modalde CO2 gosterimi + sinir disi degerin renkle ayrilmasi
    "Neden alarm aldim" sorusu modalden cevaplanamiyordu.
    1) CO2 MODALDE HIC YOKTU
    Sicaklik ve nem gosteriliyordu, CO2 satiri yoktu. CO2 alarmi geldiginde
    kullanici ne olculen degeri ne de asilan limiti gorebiliyordu - elinde
    yalnizca kirpilmis alarm metni kaliyordu.
    Artik tam genislikte bir satir: "CO2 3450 / 3000 ppm".
    Sensor takili degilse limit YAZILMIYOR ("CO2 sensor yok"); limit yazmak
    "olctuk, normaldi" izlenimi verirdi.
    2) DEGERLER NOTR RENKTEYDI
    Uc olcum de ayni renkte yaziliyordu; hangisinin sinir disinda oldugu belli
    olmuyordu. Alarm mesaji da 28 karakterde kirpildigi icin sebep kaybolabiliyordu.
    Artik her de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
2026-08-05 docs(readme): fan L298N baglanti tablosu - ortak toprak ve pull-up notlari
    Kullanicinin planladigi baglanti dogru: IO18->ENA (jumper cikarik),
    P7->IN1, IN2->GND. README bu duzene gore netlestirildi.
    EKLENEN KRITIK NOT: ORTAK TOPRAK
    IN2'yi PCF8574'un GND'sine baglamak dogrudur ama TEK BASINA YETMEZ.
    L298N'in kendi GND terminali de ayni topraga baglanmalidir: IN1'e gelen
    HIGH sinyali PCF8574'un topragina gore olculur, L298N ise kendi GND pinine
    gore degerlendirir. Ikisi bagli degilse sinyalin referansi yoktur ve
    surucu girisleri tanimsiz davranir - motor hic donmeyebilir.
    Kural olarak yazildi: ESP32 + PCF8574 + L298N + 12V beslemenin eksi ucu,
    dordu de ayni toprak noktasinda bulusmali.
    Tam b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
2026-08-05 docs(readme): role karti besleme bolumu - "LED yaniyor ama role tiklamiyor"
    Sahada karsilasilan durum: role test modali komutlari gonderiyor, PCF8574
    yazmasi geciyor ("Role karti: OK"), kart uzerindeki LED'ler sirayla yaniyor
    - ama roleler tiklamiyor.
    Bu belirti giris devresinin calistigini ama BOBIN devresinin beslenmedigini
    soyler. Dokumanda role kartinin iki ayri devresi hic anlatilmamisti:
    Mantik (giris): VCC/GND + IN1..IN4 -> LED + optokuplor, ~5 mA
    Bobin (guc) : JD-VCC/GND -> rolenin kendisi, 5V ve ~70 mA/role
    Eklenen teshis sirasi:
    1. VCC gercekten 5V mu? 3.3V'ta LED yanar (~2V yeter) ama 5V bobin cekmez.
    En sik sebep.
    2. JD-VCC jumper'i takili mi? Degilse JD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
